mattyjayt/terra-hawk-scout/docs/adr/README.md

# Architecture decision records
- [ADR-0001 — Raspberry Pi 5 on the Scout first](0001-pi5-on-scout.md) · *Accepted*
- [ADR-0002 — ESP32 + micro-ROS as the real-time I/O controller](0002-esp32-micro-ros.md) · *Superseded by ADR-0006*
- [ADR-0003 — Encoder motors for odometry](0003-encoder-motors.md) · *Deferred: no encoders on the robot today*
- [ADR-0004 — Documentation-first workflow](0004-documentation-first.md) · *Accepted*
- [ADR-0005 — Arduino UNO R4 over USB serial as the base controller](0005-r4-usb-serial-base.md) · *Accepted*
- [ADR-0006 — Scout runs on the Pi 5 + Arduino UNO R4 only (no ESP32)](0006-scout-pi-r4-only.md) · *Accepted*
