mattyjayt/terra-hawk-scout/docs/design/DD-SCOUT-LOC.md

---
id: DD-SCOUT-LOC
title: Localisation (EKF)
status: Planned
owner: Argos (draft) · Jaime (approver)
updated: 2026-11-09
---
# DD-SCOUT-LOC — Localisation (EKF)

**Learning-critical.** robot_localization config, covariances, the drift measurement method. See the [sensor-fusion figure](../figures/sensor-fusion/sensor-fusion.html) (a concept figure drawn with wheel encoders; the Scout has none, so LiDAR scan matching takes that role).

## Context and requirements
_TBD_

## Goals / non-goals
_TBD_

## Design
_TBD_

## Interfaces
_TBD_

## Alternatives considered
_TBD_

## Risks
_TBD_

## Test plan
_TBD_

## Open questions
_TBD_
