mattyjayt/terra-hawk-scout/docs/design/DD-SCOUT-PERC.md

---
id: DD-SCOUT-PERC
title: Perception node (Camera 3 · YOLO · Python)
status: In progress (code in `scout_perception`: person_detector, pan_tracker; this doc is still to be written)
owner: Argos (draft) · Jaime (approver)
updated: 2026-11-08
---
# DD-SCOUT-PERC — Perception node (Camera 3 · YOLO · Python)

**Learning-critical.** Model choice (YOLO NCNN vs ONNX Runtime), the FPS budget, classes and dataset (Roboflow).

## Context and requirements
_TBD_

## Goals / non-goals
1. Display raw_image on foxglove
2. Display compressed image on foxglove
3. Integrate object detection & tracking
4. Publish detections
5. Move and pan servo with camera to ensure subject remains in centre

## Design
_TBD_

## Interfaces
_TBD_

## Alternatives considered
_TBD_

## Risks
_TBD_

## Test plan
_TBD_

## Open questions
_TBD_
