mattyjayt/terra-hawk-scout/docs/adr/0004-documentation-first.md

# ADR-0004 — Documentation-first workflow
- **Status:** Accepted (2026-10-30)
- **Context:** Problems caught in specs are cheaper than problems caught in hardware.
- **Decision:** PRD → SRS → interfaces → design docs approved before code; IDs trace into issues, tests and releases.
- **Consequences:** recorded in the related design docs; revisit if the constraint changes.
