mattyjayt/terra-hawk-scout/cad/scout-v2/docs/figures/drivetrain-power/drivetrain-power-light.html

Fig 2Drive and powerHold to cut /cmd_velL 0.30 · R 0.30 m/s · 1481 counts/s

1 Power: 3S pack 9.0–12.6 V → 7.5 A fuse → 10 A DC switch → Cytron MDD3A. Duty capped at 8.4 V ÷ V_pack (67 % full, 93 % at 9.0 V), so the motors see ≤ 8.4 V average. Branch: Pololu D36V50F5 → 5 V to the Pi 5 header2 Drive: Hiwonder TT motor, 1:42 gearbox; hall encoder on the motor shaft, 1008 counts per wheel turn claimed (×4 quadrature) → π × 65 mm ÷ 1008 = 0.20 mm per count3 Skid steer: in a turn the tyres scrub sideways, so the wheels run as if the track were 1.7–1.9 × the 124 mm geometric one. Wheel odometry is good for distance, bad for heading: the EKF takes yaw from the MPU-6050 gyro4 Loop: ESP32 counts with PCNT and runs the wheel PID at ≥ 50 Hz (20 ms); no /cmd_vel for 300 ms → MDD3A inputs LOW/LOW: braked to a stop in 0.16–0.19 s (coasting takes 0.32–0.42 s)Scout v2's left side with the near half of the top deck cut away (the parts it carries stay in place) and the near front wheel laid on the bench. The tour drives straight at 0.3 m/s (1.47 wheel turns, about 1481 counts per second), then turns left at 0.5 rad/s with 0.2 m/s forward: the near wheels slow to 0.14 m/s and the far ones speed up to 0.26 m/s, because the scrubbing tyres need an effective track about 1.8 × 124 mm. Read through the geometric track those wheel speeds claim 0.90 rad/s, so heading comes from the gyro. Then /cmd_vel goes quiet: after 300 ms the ESP32 drives both MDD3A inputs LOW and the motors brake. Hold the figure to cut /cmd_vel yourself. The encoder magnet is drawn turning 3 × the wheel; the real one turns 42 ×. The 1008-count figure is Hiwonder's claim (one buyer measured 600): measure it on arrival. The MPU-6050 hangs under the top deck between the driver and the buck. The right-side wiring, the I²C lead and the LiDAR tower are left out; layout after CAD r1, with the fuse holder moved beside the XT30 so the series path is in view.
