mattyjayt/terra-hawk-scout/docs/design/DD-SCOUT-HWIF.md

---
id: DD-SCOUT-HWIF
title: ros2_control hardware interface (C++)
status: Deferred (not in the current plan; the base bridge, DD-SCOUT-BRIDGE, drives the base)
owner: Argos (draft) · Jaime (approver)
updated: 2026-11-09
---
# DD-SCOUT-HWIF — ros2_control hardware interface (C++)

**Learning-critical:** Jaime writes the core. Covers the read()/write() cycle, state/command interfaces and reuse of the base bridge's serial-r4 core (DD-SCOUT-BRIDGE).

## Context and requirements
_TBD_

## Goals / non-goals
_TBD_

## Design
_TBD_

## Interfaces
_TBD_

## Alternatives considered
_TBD_

## Risks
_TBD_

## Test plan
_TBD_

## Open questions
_TBD_
