mattyjayt/terra-hawk-scout/cad/scout-layout/shots/scout_iso.png

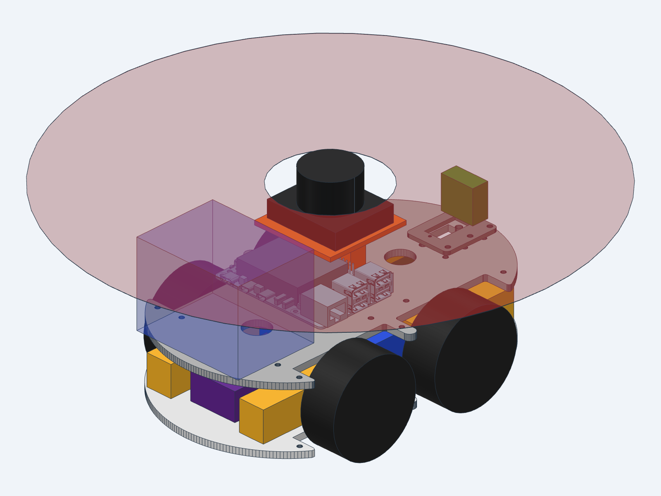
cad/scout-layout/shots/scout_iso.png
