mattyjayt/terra-hawk-scout/cad/scout-layout/shots/scout_top.png

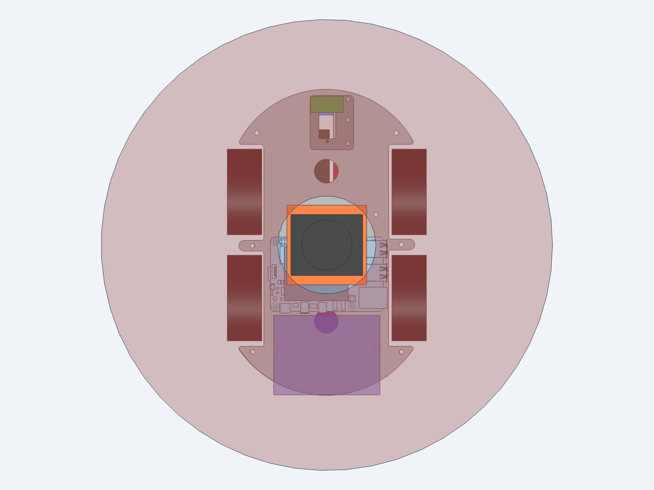
cad/scout-layout/shots/scout_top.png
