mattyjayt/terra-hawk-scout/cad/scout-v2/analysis/a1_mass_com.png

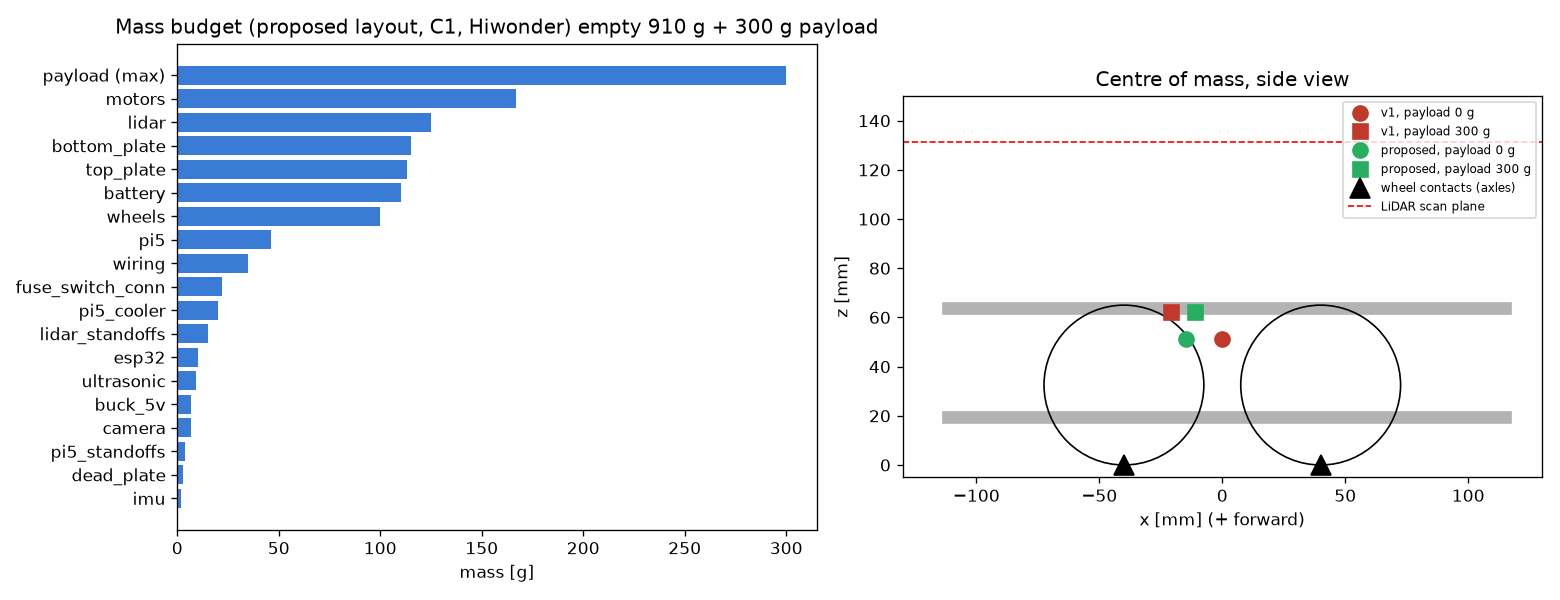
cad/scout-v2/analysis/a1_mass_com.png
