mattyjayt/terra-hawk-scout/cad/scout-v2/analysis/a2_torque_speed.png

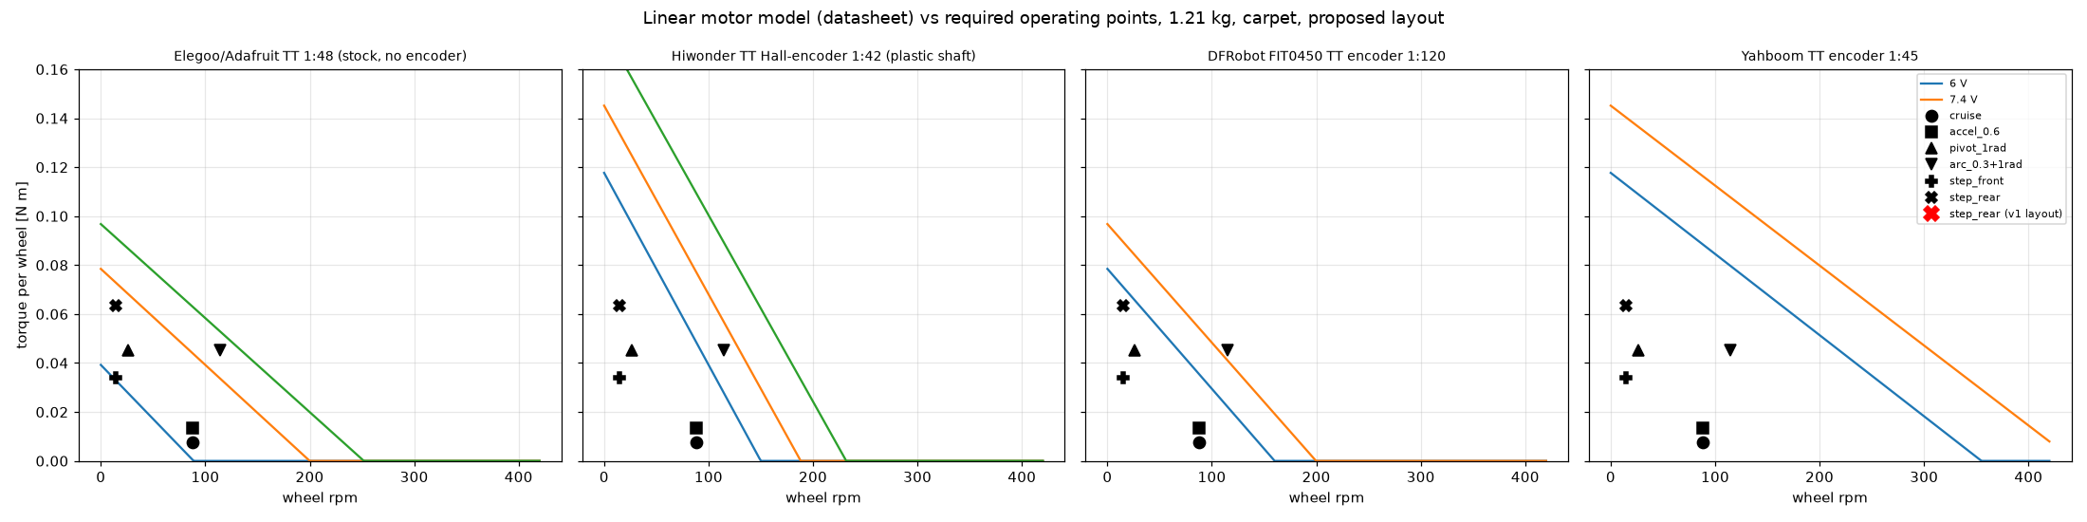
cad/scout-v2/analysis/a2_torque_speed.png
