mattyjayt/terra-hawk-scout/cad/scout-v2/analysis/a3_skid_steer.png

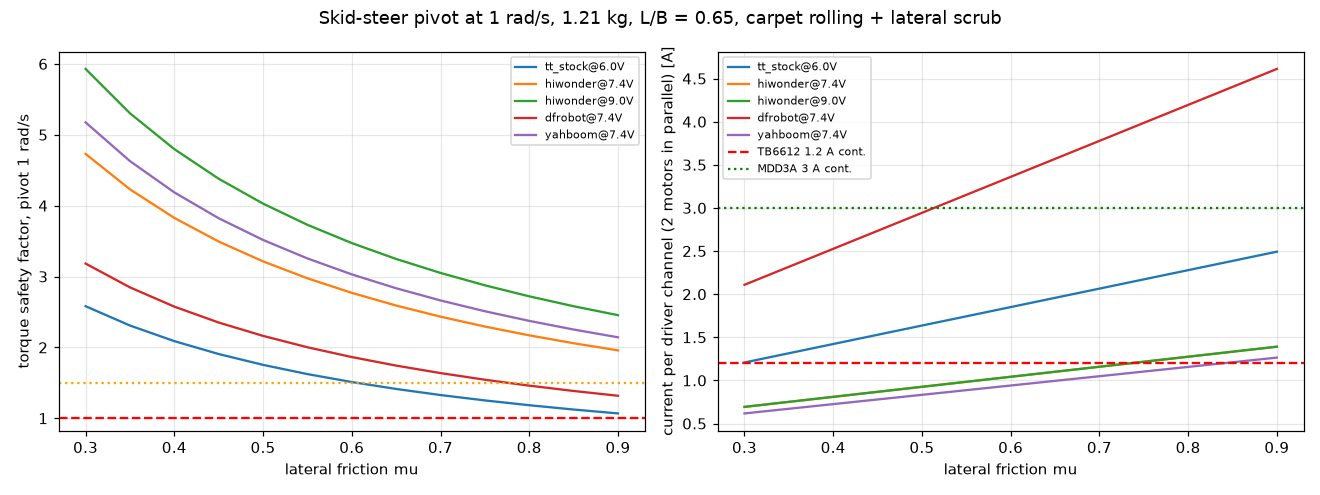
cad/scout-v2/analysis/a3_skid_steer.png
