mattyjayt/terra-hawk-scout/cad/scout-v2/analysis/a5_power.png

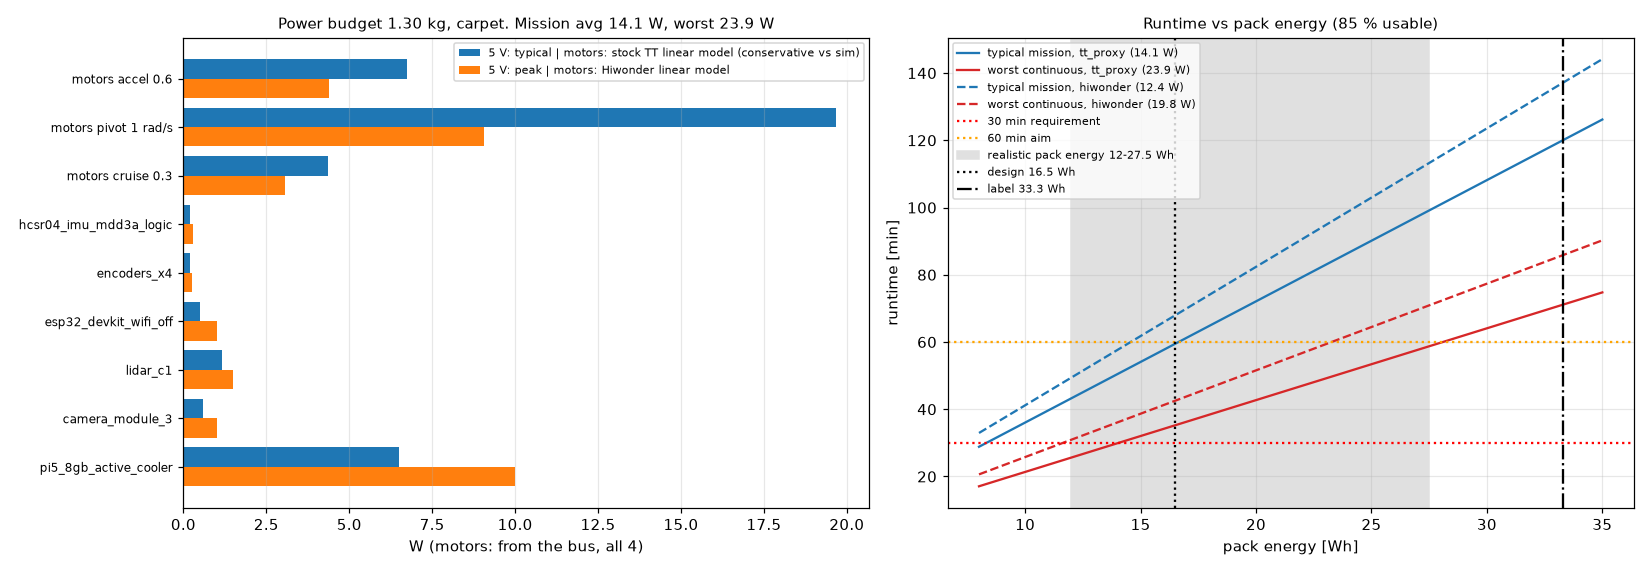
cad/scout-v2/analysis/a5_power.png
