mattyjayt/terra-hawk-scout/cad/scout-v2/analysis/a6_stability.png

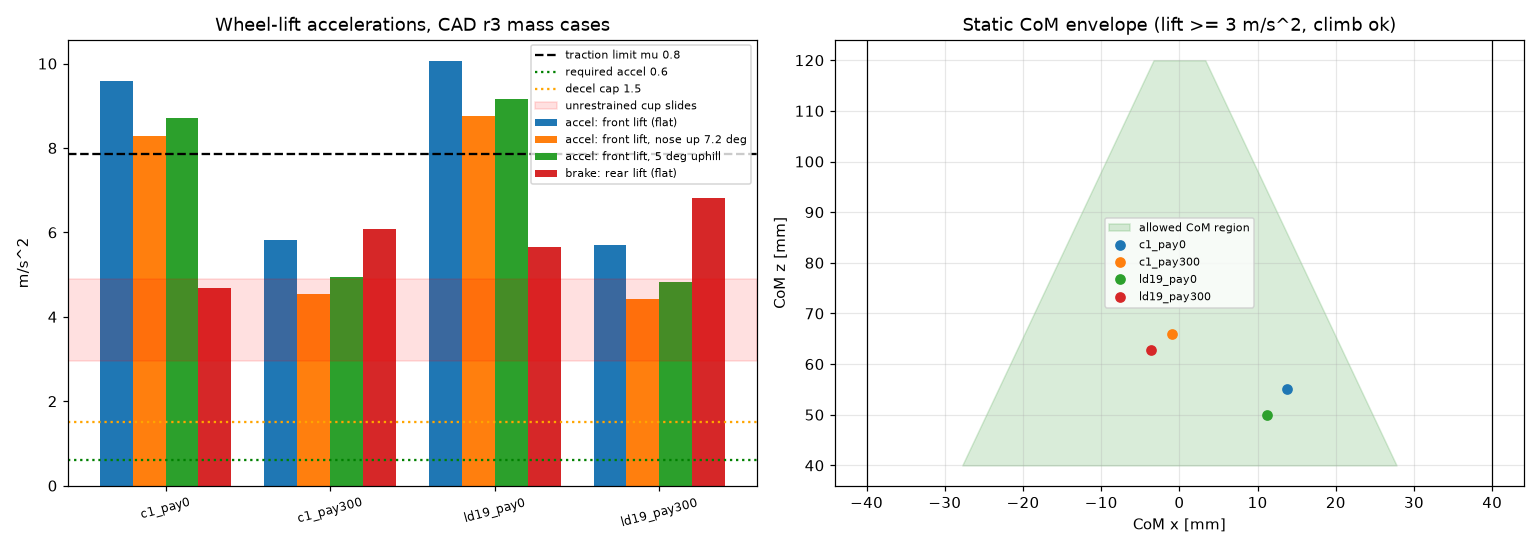
cad/scout-v2/analysis/a6_stability.png
