mattyjayt/terra-hawk-scout/cad/scout-v2/analysis/a7_odometry.png

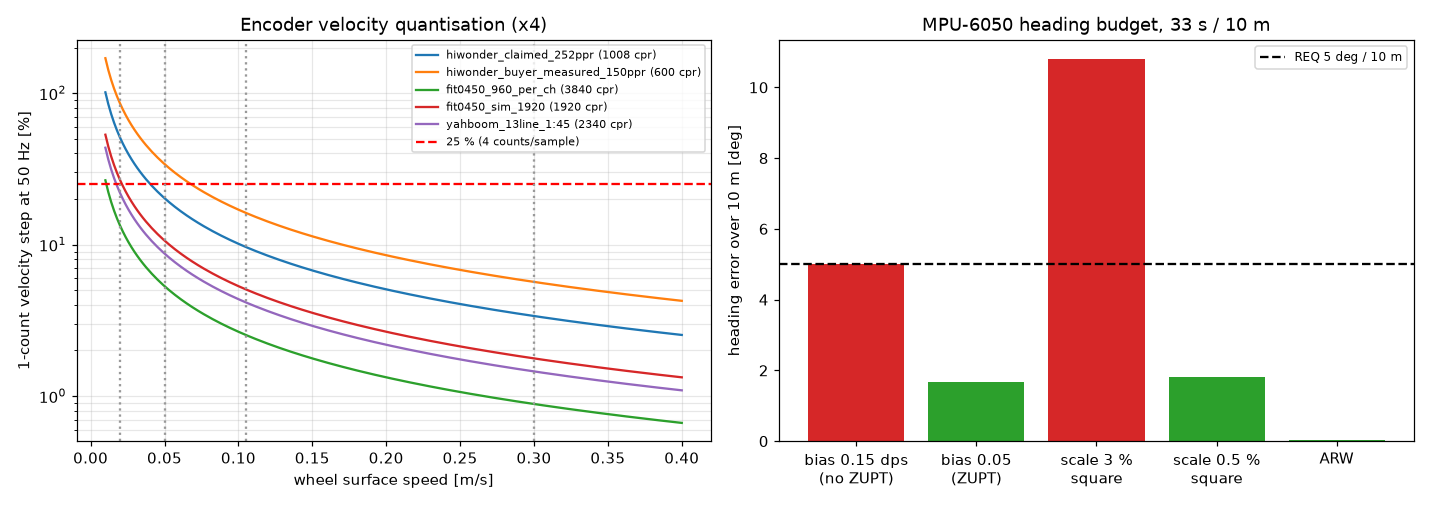
cad/scout-v2/analysis/a7_odometry.png
