mattyjayt/terra-hawk-scout/cad/scout-v2/analysis/a8_sensors.png

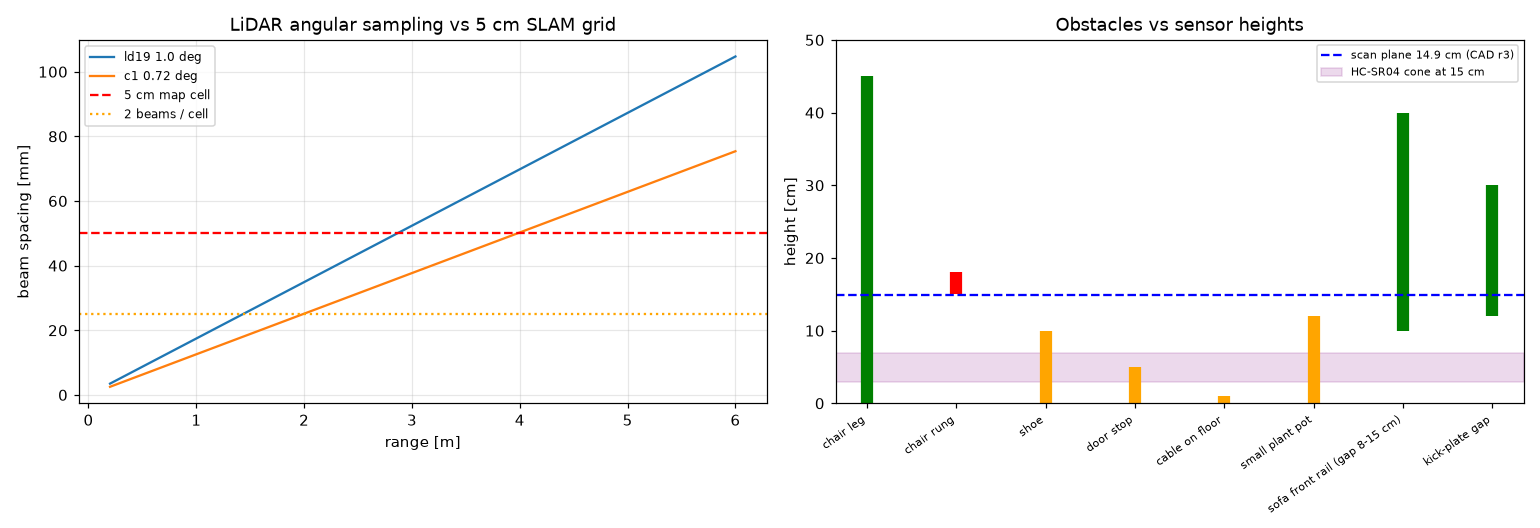
cad/scout-v2/analysis/a8_sensors.png
