mattyjayt/terra-hawk-scout/cad/scout-v2/analysis/a9_motor_review.png

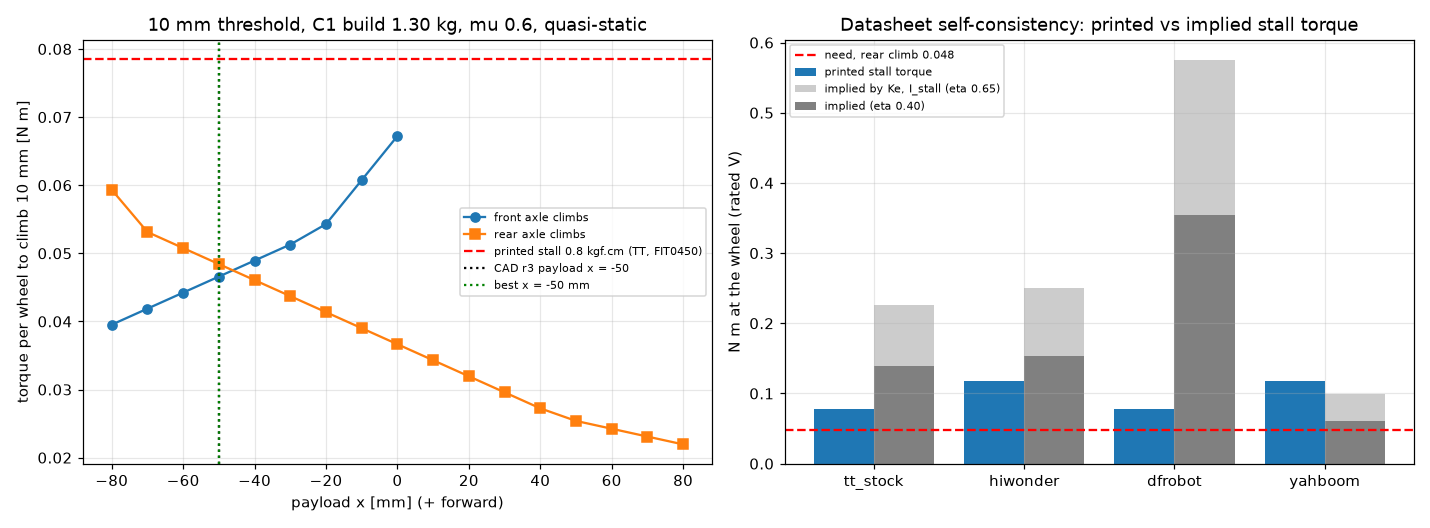
cad/scout-v2/analysis/a9_motor_review.png
