mattyjayt/terra-hawk-scout/cad/scout-v2/analysis/a9_torque_speed.png

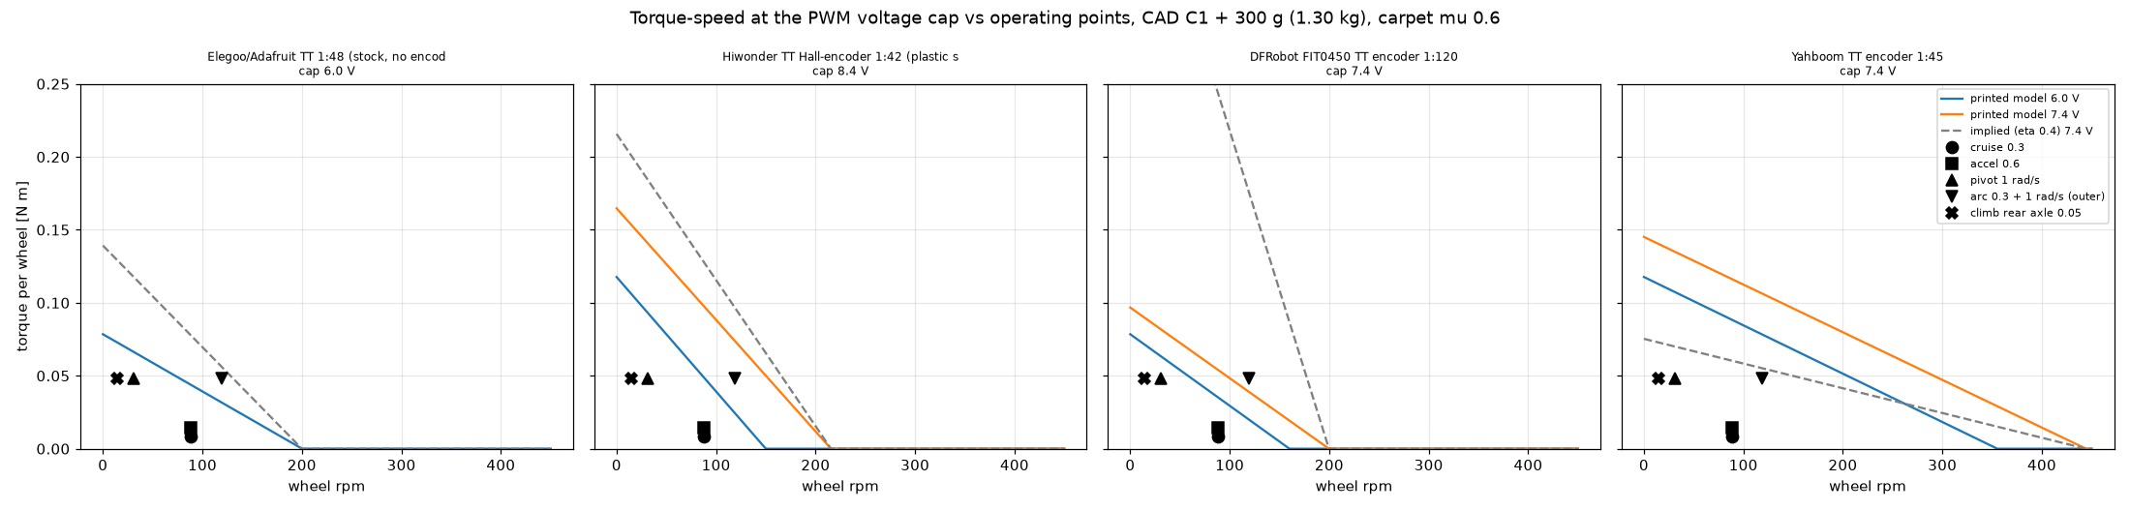
cad/scout-v2/analysis/a9_torque_speed.png
