mattyjayt/terra-hawk-scout/cad/scout-v2/docs/diagrams/scout-power-distribution/scout-power-distribution.png

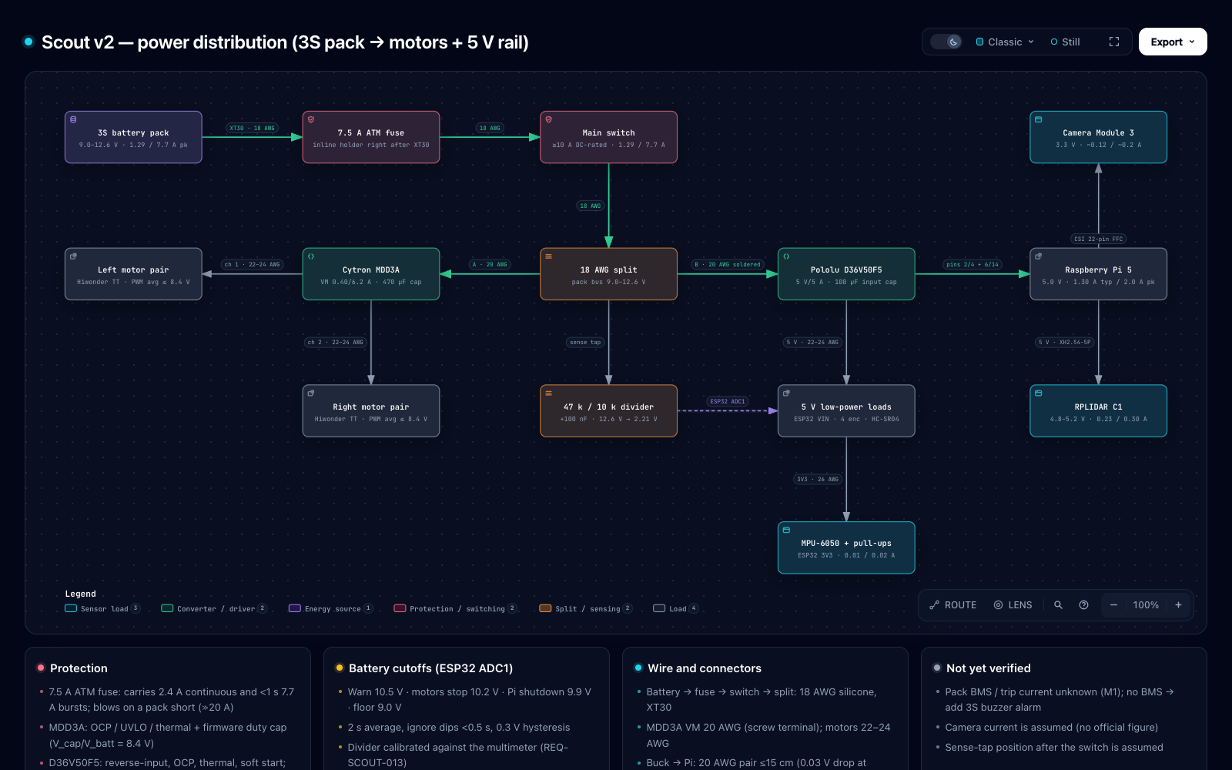
cad/scout-v2/docs/diagrams/scout-power-distribution/scout-power-distribution.png
