mattyjayt/terra-hawk-scout/cad/scout-v2/docs/figures/drivetrain-power/shots/desktop-light.png

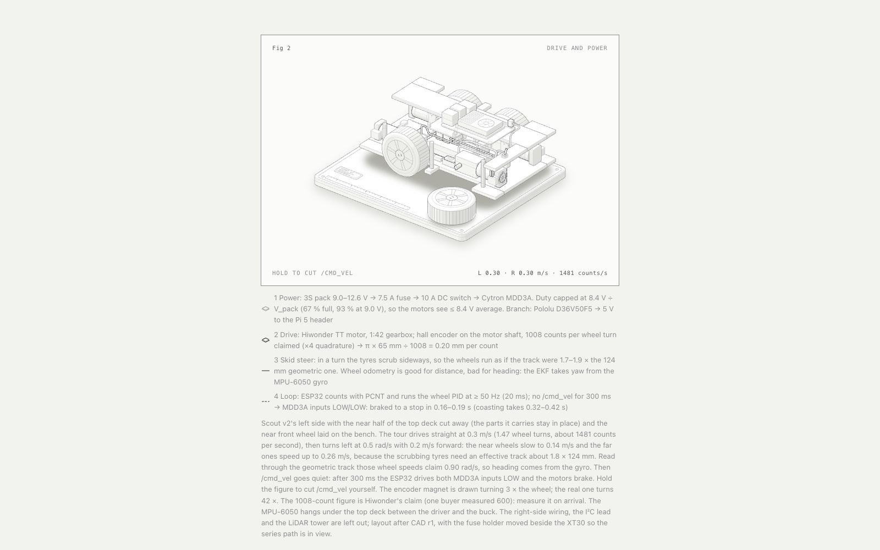
cad/scout-v2/docs/figures/drivetrain-power/shots/desktop-light.png
