mattyjayt/terra-hawk-scout/cad/scout-v2/docs/figures/drivetrain-power/shots/held-stopped.png

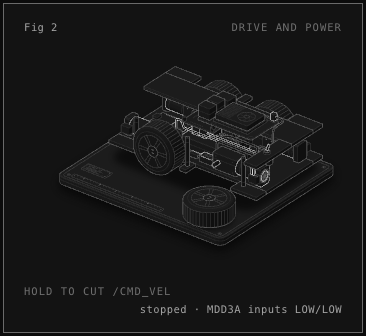
cad/scout-v2/docs/figures/drivetrain-power/shots/held-stopped.png
