mattyjayt/terra-hawk-scout/cad/scout-v2/docs/figures/drivetrain-power/shots/lines-light.png

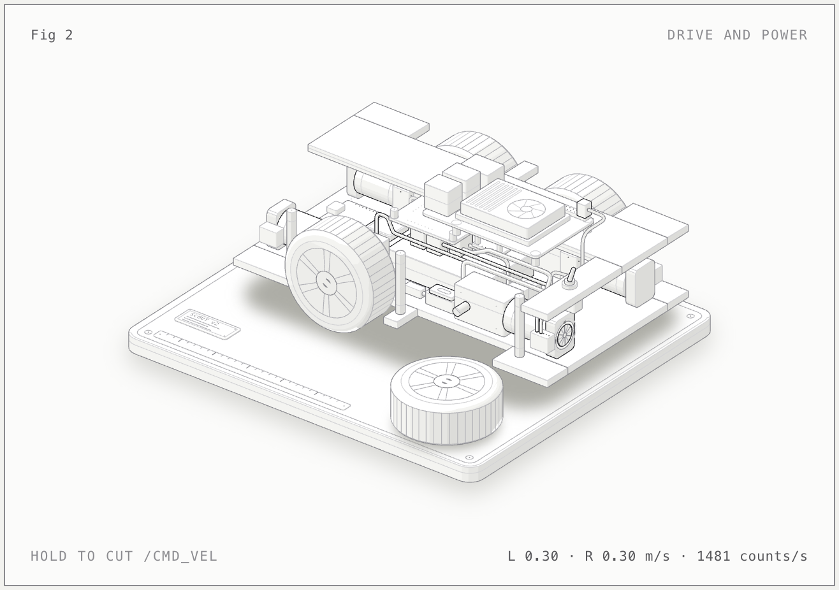
cad/scout-v2/docs/figures/drivetrain-power/shots/lines-light.png
