mattyjayt/terra-hawk-scout/cad/scout-v2/docs/figures/drivetrain-power/shots/lines.png

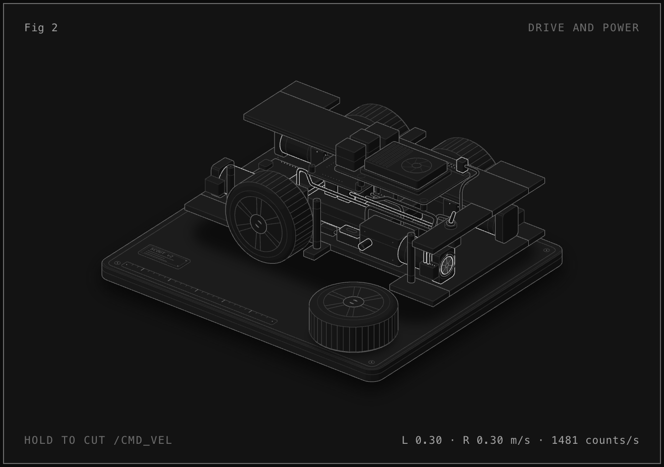
cad/scout-v2/docs/figures/drivetrain-power/shots/lines.png
