mattyjayt/terra-hawk-scout/cad/scout-v2/docs/figures/drivetrain-power/shots/phone-390-light.png

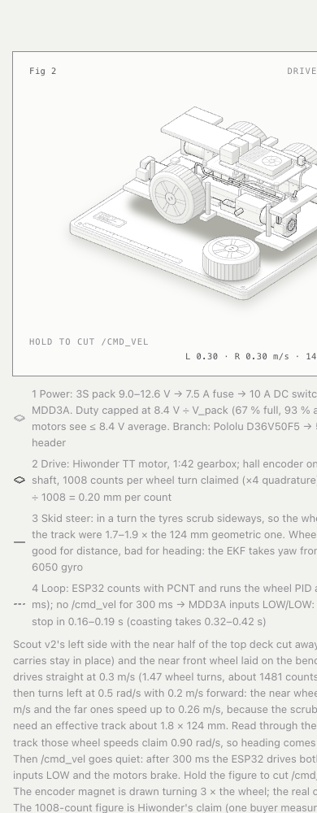
cad/scout-v2/docs/figures/drivetrain-power/shots/phone-390-light.png
