mattyjayt/terra-hawk-scout/cad/scout-v2/docs/figures/drivetrain-power/shots/phone-emulated.png

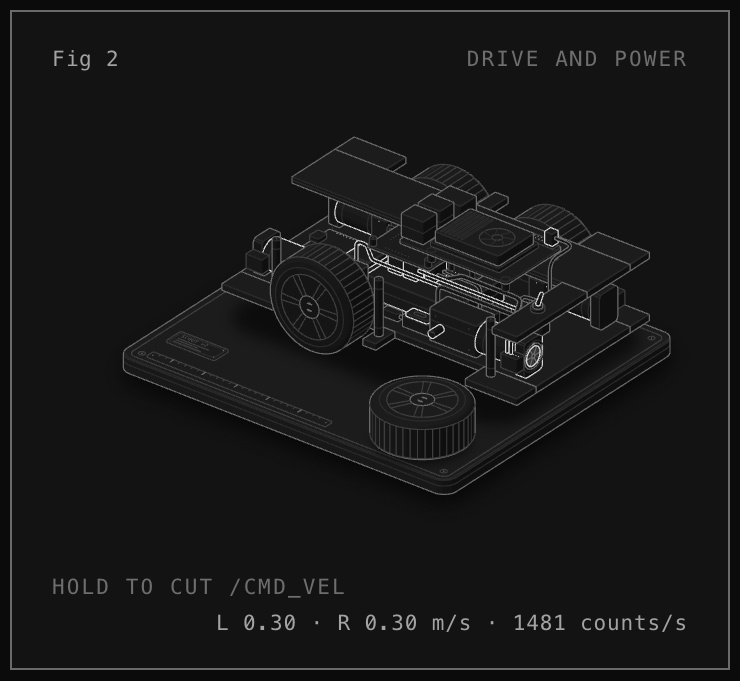
cad/scout-v2/docs/figures/drivetrain-power/shots/phone-emulated.png
