mattyjayt/terra-hawk-scout/cad/scout-v2/docs/figures/drivetrain-power/shots/phone-light-turn.png

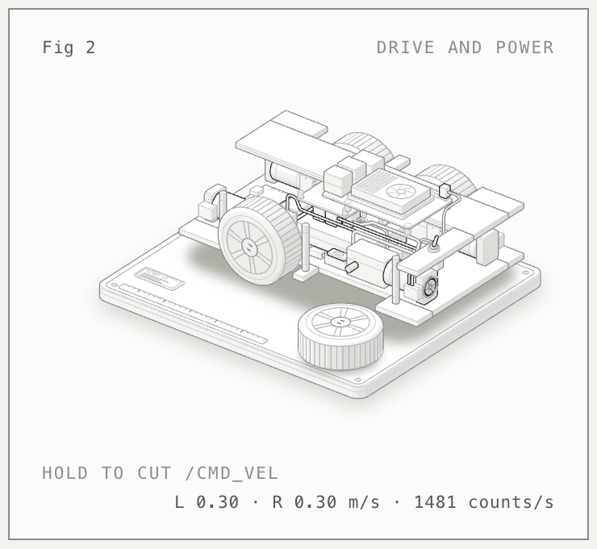
cad/scout-v2/docs/figures/drivetrain-power/shots/phone-light-turn.png
