mattyjayt/terra-hawk-scout/cad/scout-v2/docs/figures/drivetrain-power/shots/plate-dark-3000.png

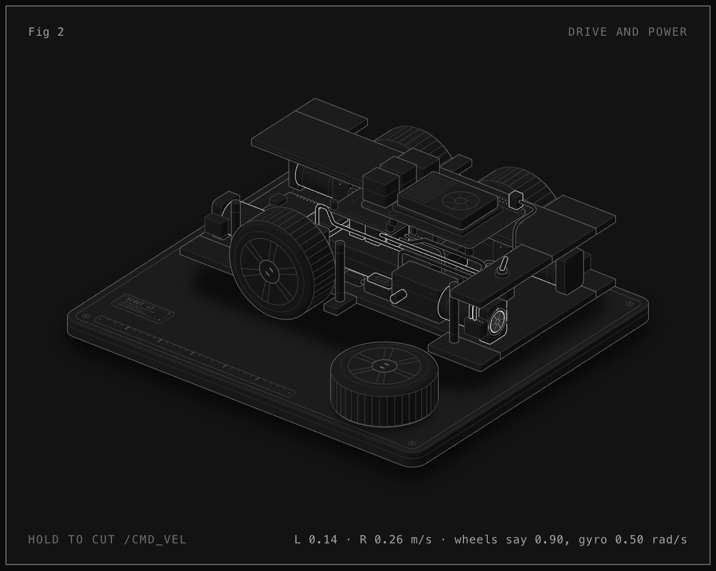
cad/scout-v2/docs/figures/drivetrain-power/shots/plate-dark-3000.png
