mattyjayt/terra-hawk-scout/cad/scout-v2/docs/figures/drivetrain-power/shots/plate-dark-7000.png

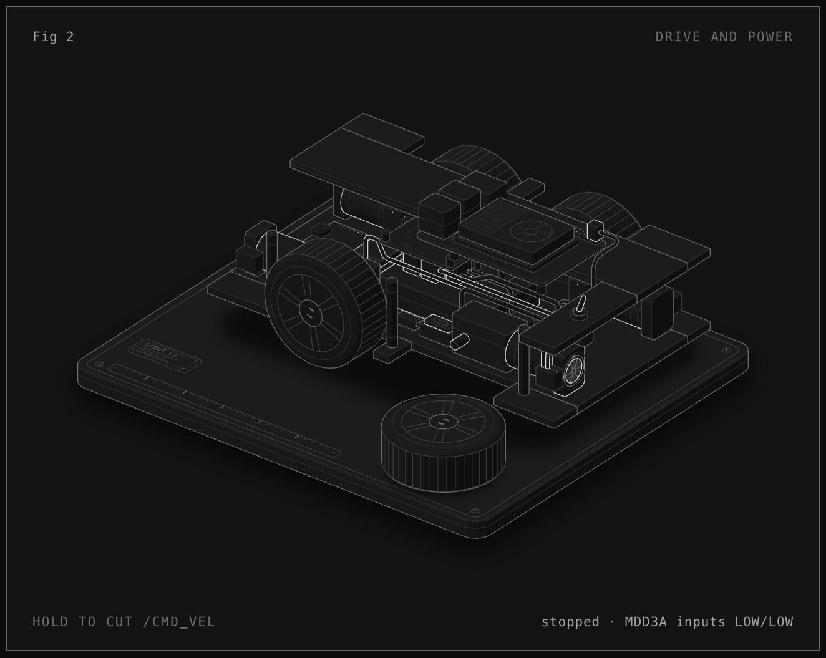
cad/scout-v2/docs/figures/drivetrain-power/shots/plate-dark-7000.png
