mattyjayt/terra-hawk-scout/cad/scout-v2/docs/figures/drivetrain-power/shots/turn-phone.png

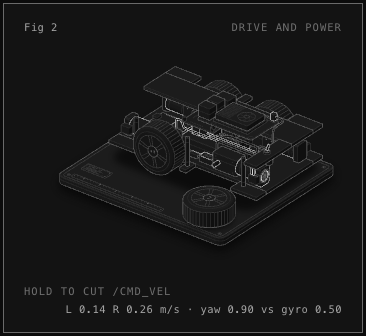
cad/scout-v2/docs/figures/drivetrain-power/shots/turn-phone.png
