mattyjayt/terra-hawk-scout/cad/scout-v2/docs/figures/drivetrain-power/shots/zoom-5v.png

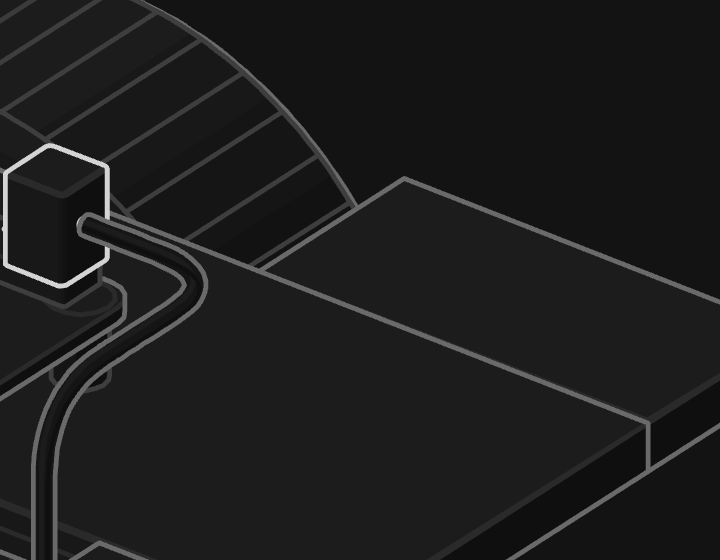
cad/scout-v2/docs/figures/drivetrain-power/shots/zoom-5v.png
