mattyjayt/terra-hawk-scout/cad/scout-v2/docs/figures/drivetrain-power/shots/zoom-front.png

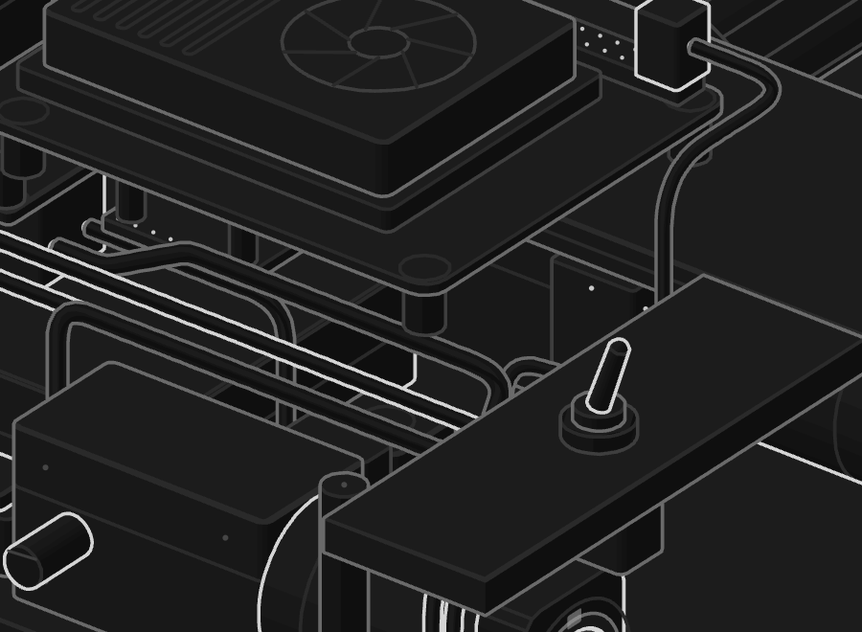
cad/scout-v2/docs/figures/drivetrain-power/shots/zoom-front.png
