mattyjayt/terra-hawk-scout/cad/scout-v2/shots/scout_v2_side.png

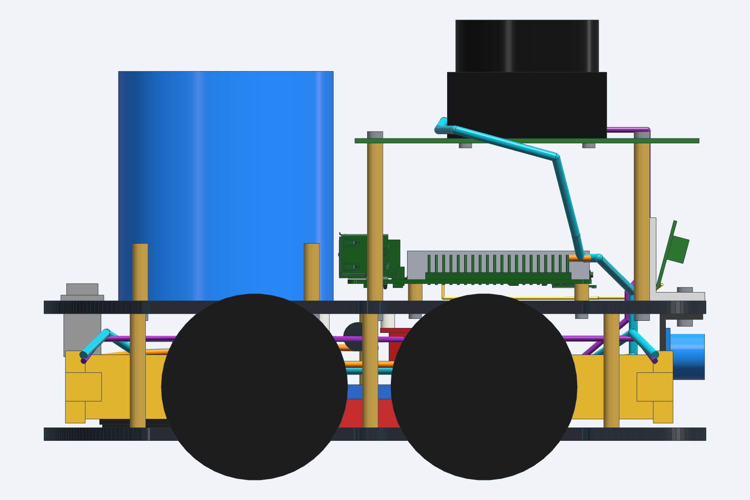
cad/scout-v2/shots/scout_v2_side.png
