mattyjayt/terra-hawk-scout/cad/scout-v2/shots/scout_v2_top.png

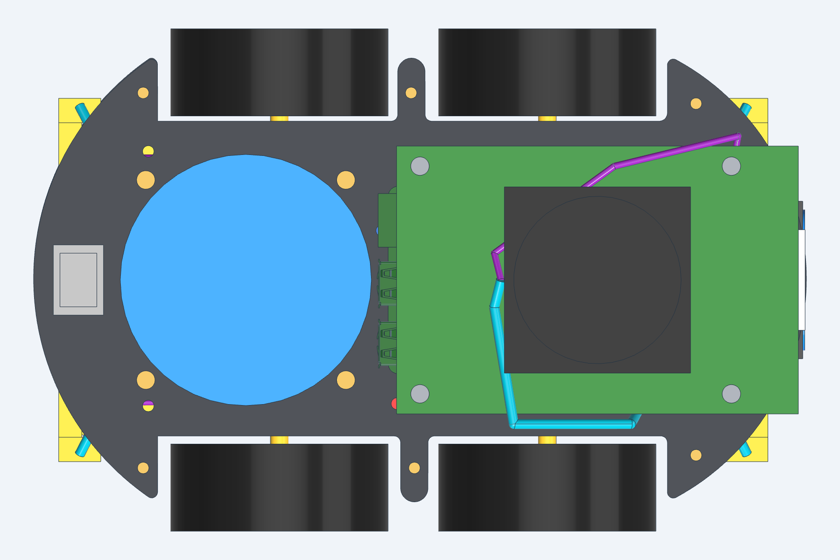
cad/scout-v2/shots/scout_v2_top.png
