mattyjayt/terra-hawk-scout/cad/scout-v2/sim/plots/a_straight.png

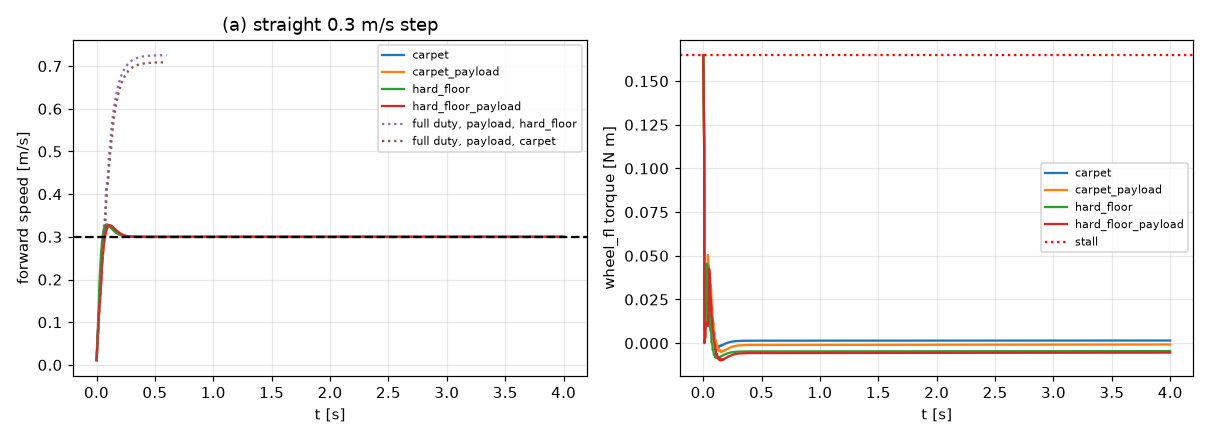
cad/scout-v2/sim/plots/a_straight.png
