mattyjayt/terra-hawk-scout/cad/scout-v2/sim/plots/b_spin.png

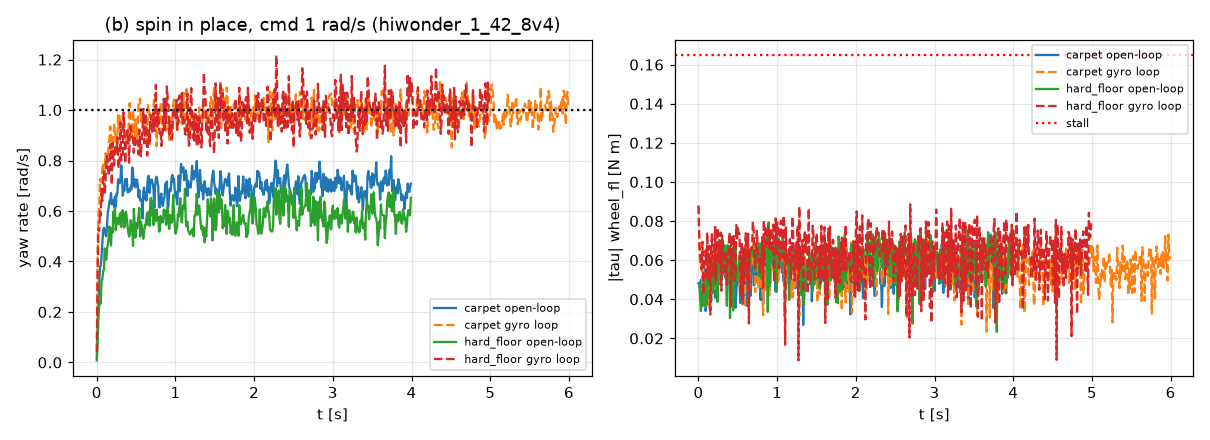
cad/scout-v2/sim/plots/b_spin.png
