mattyjayt/terra-hawk-scout/cad/scout-v2/sim/plots/c_estop.png

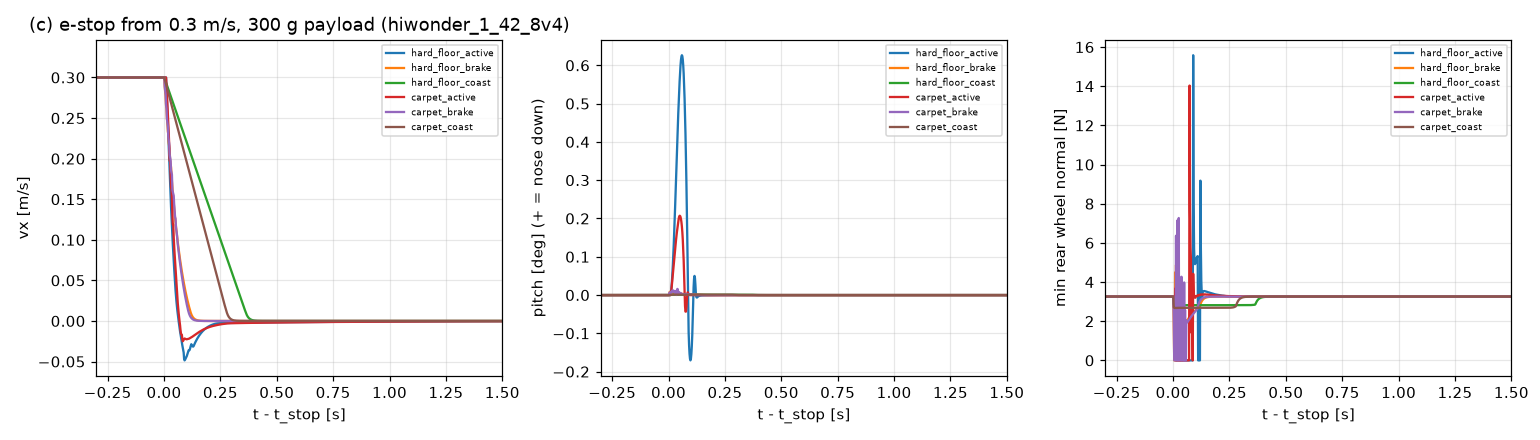
cad/scout-v2/sim/plots/c_estop.png
