mattyjayt/terra-hawk-scout/cad/scout-v2/sim/plots/d_threshold.png

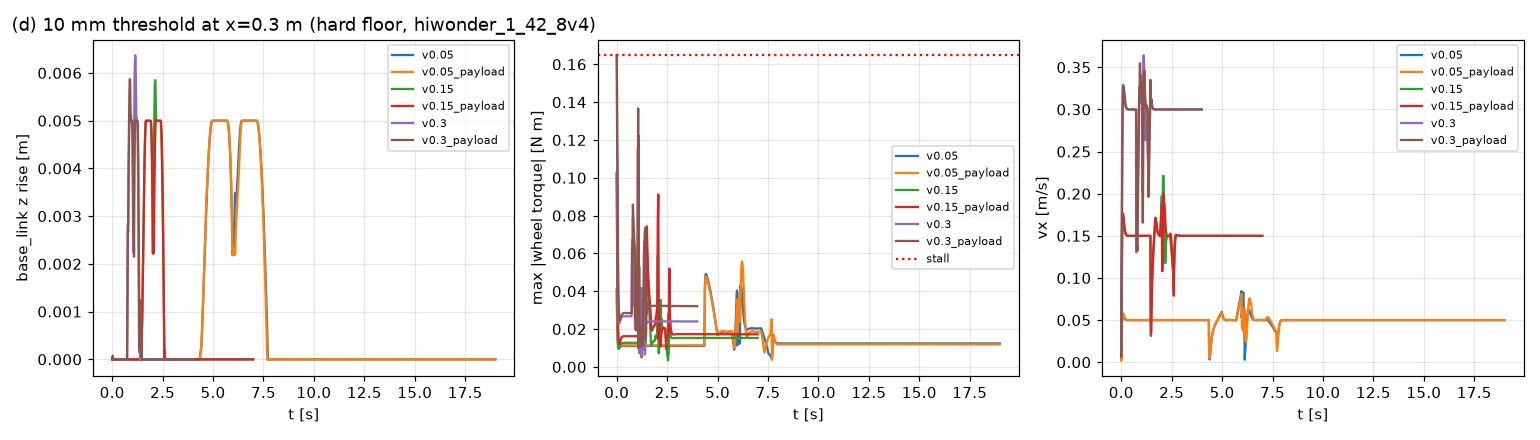
cad/scout-v2/sim/plots/d_threshold.png
