mattyjayt/terra-hawk-scout/cad/scout-v2/sim/plots/e_odometry.png

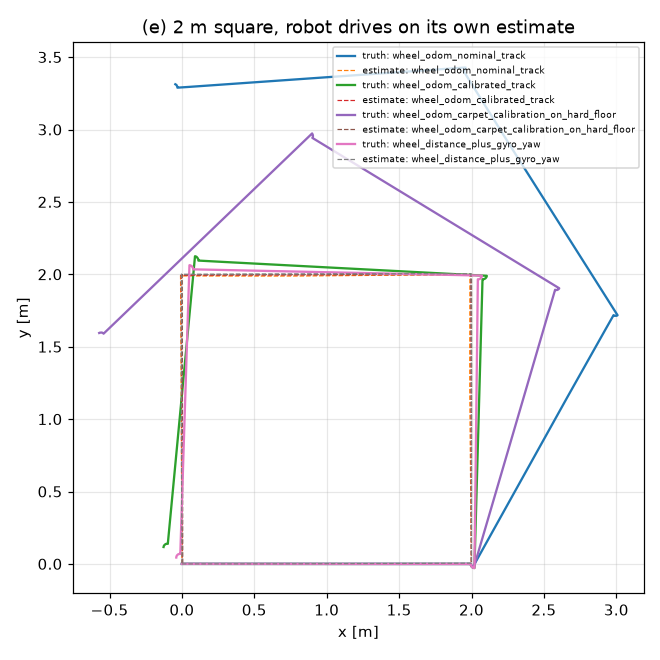
cad/scout-v2/sim/plots/e_odometry.png
