mattyjayt/terra-hawk-scout/cad/scout-v2/sim/plots/f_payload_retention.png

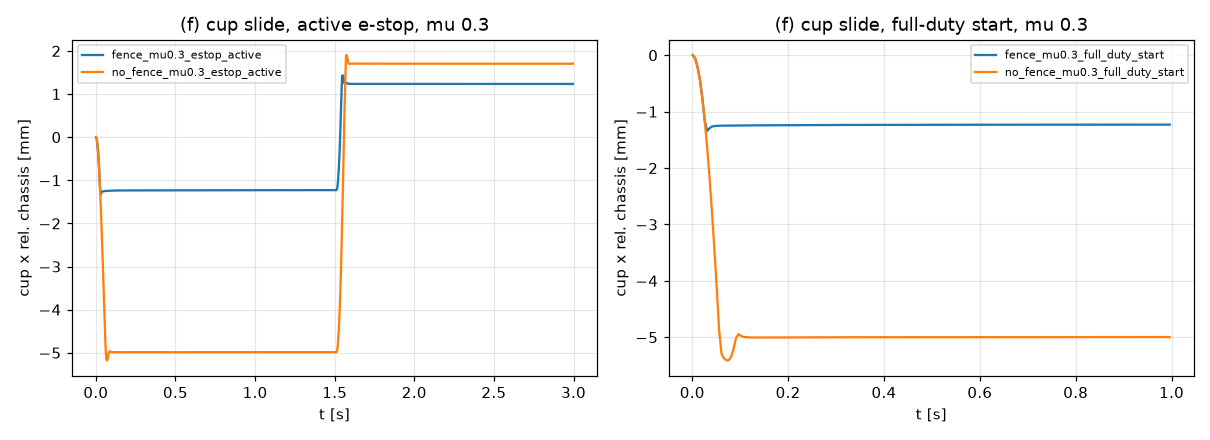
cad/scout-v2/sim/plots/f_payload_retention.png
