mattyjayt/terra-hawk-scout/cad/scout-v2/sim/plots/tt_1_48_6v/b_spin.png

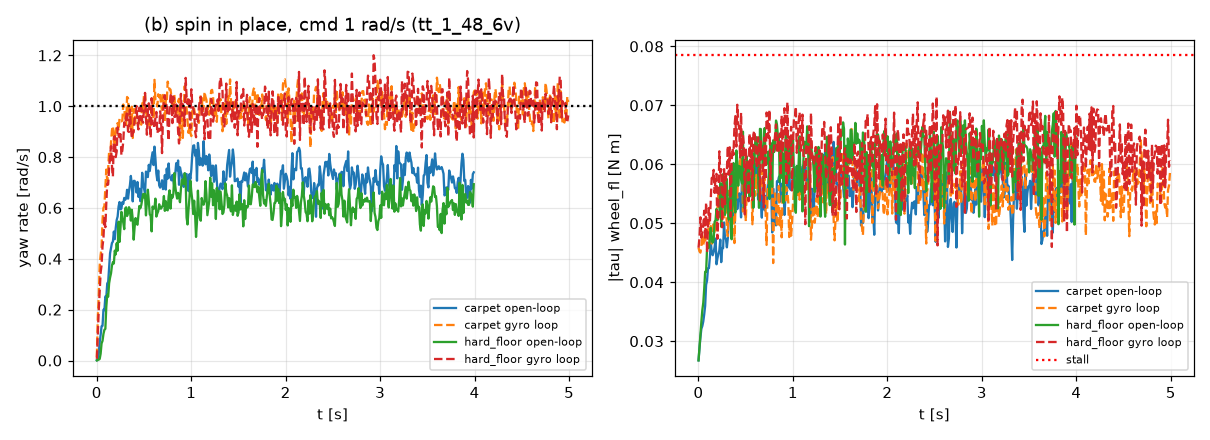
cad/scout-v2/sim/plots/tt_1_48_6v/b_spin.png
