mattyjayt/terra-hawk-scout/cad/scout-v2/sim/plots/tt_1_48_6v/c_estop.png

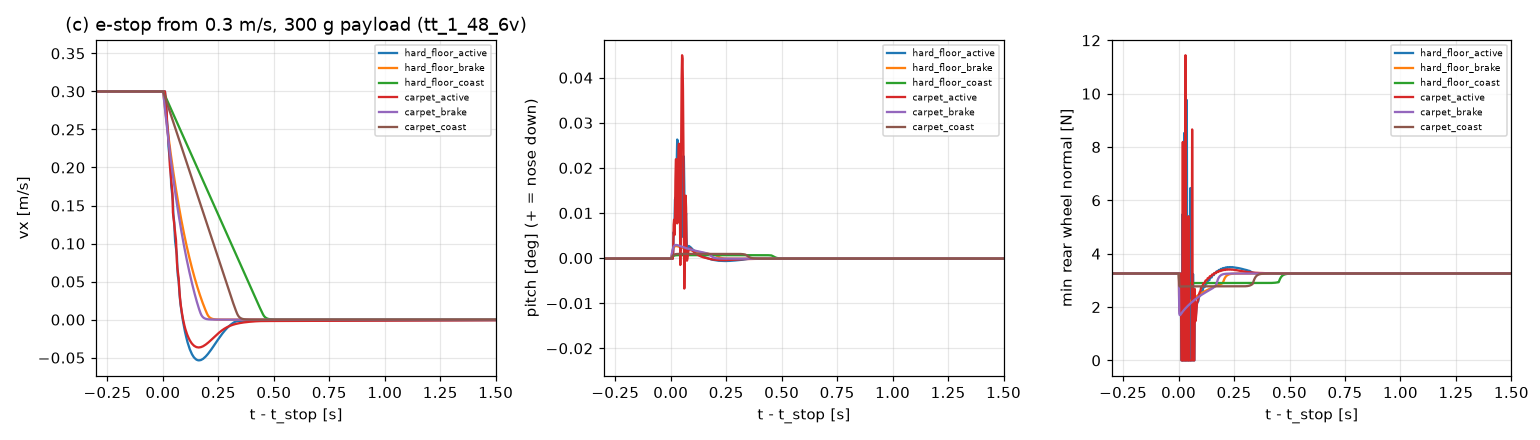
cad/scout-v2/sim/plots/tt_1_48_6v/c_estop.png
