mattyjayt/terra-hawk-scout/docs/figures/sensor-fusion/shots/after-slip-light.png

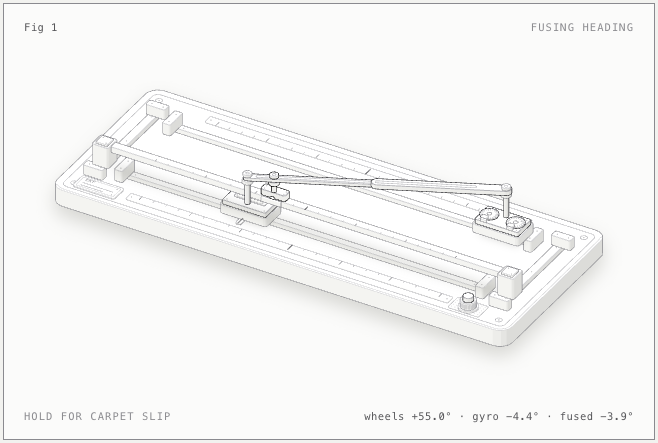
docs/figures/sensor-fusion/shots/after-slip-light.png
