mattyjayt/terra-hawk-scout/docs/figures/sensor-fusion/shots/desktop-dark.png

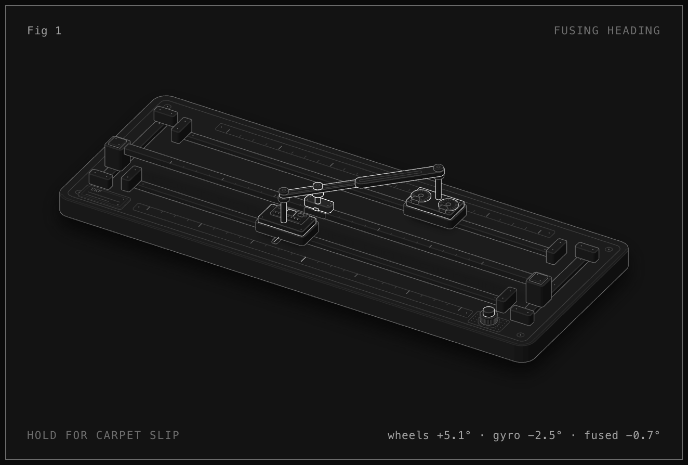
docs/figures/sensor-fusion/shots/desktop-dark.png
