mattyjayt/terra-hawk-scout/docs/figures/sensor-fusion/shots/desktop-light-3000.png

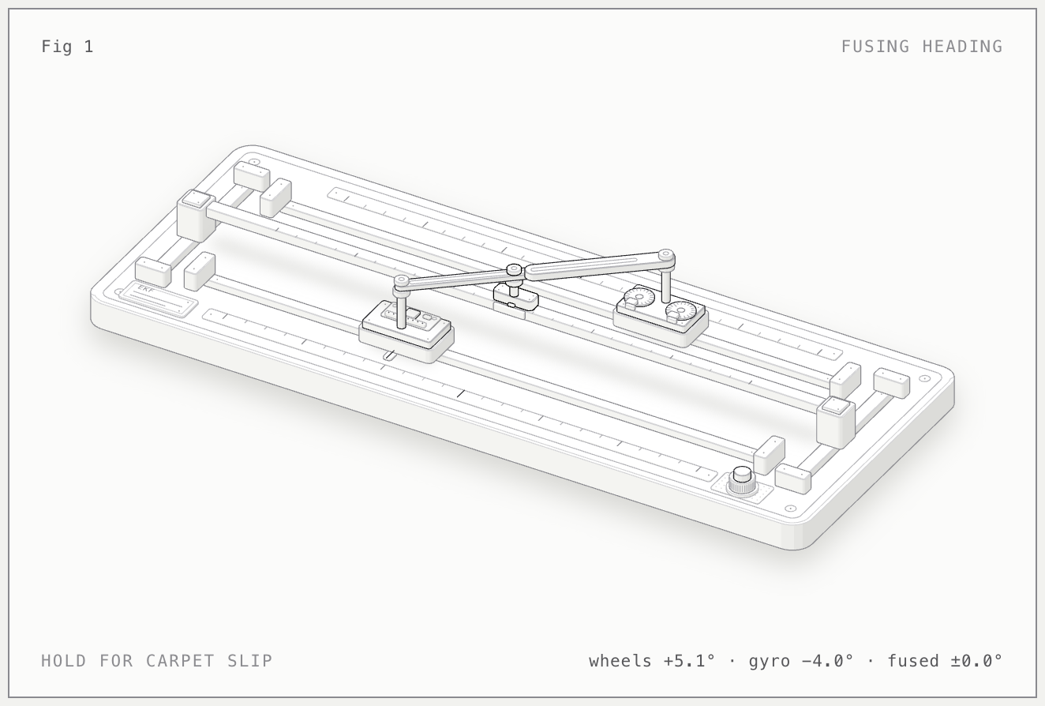
docs/figures/sensor-fusion/shots/desktop-light-3000.png
