mattyjayt/terra-hawk-scout/docs/figures/sensor-fusion/shots/desktop-light.png

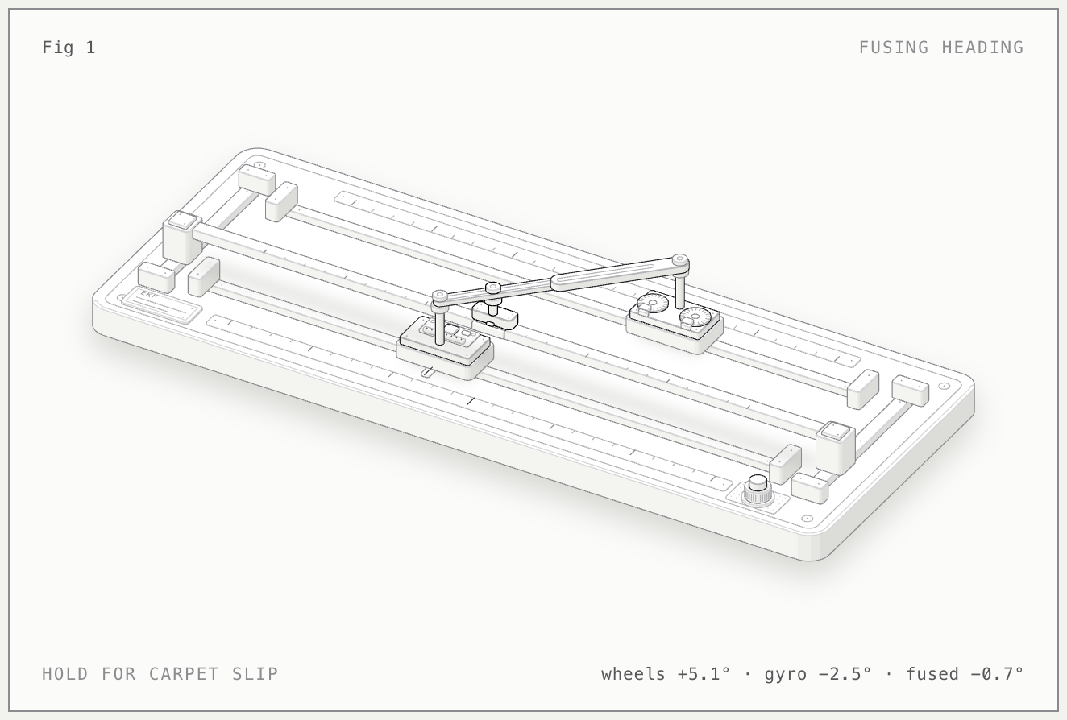
docs/figures/sensor-fusion/shots/desktop-light.png
