mattyjayt/terra-hawk-scout/docs/figures/sensor-fusion/shots/lines-light.png

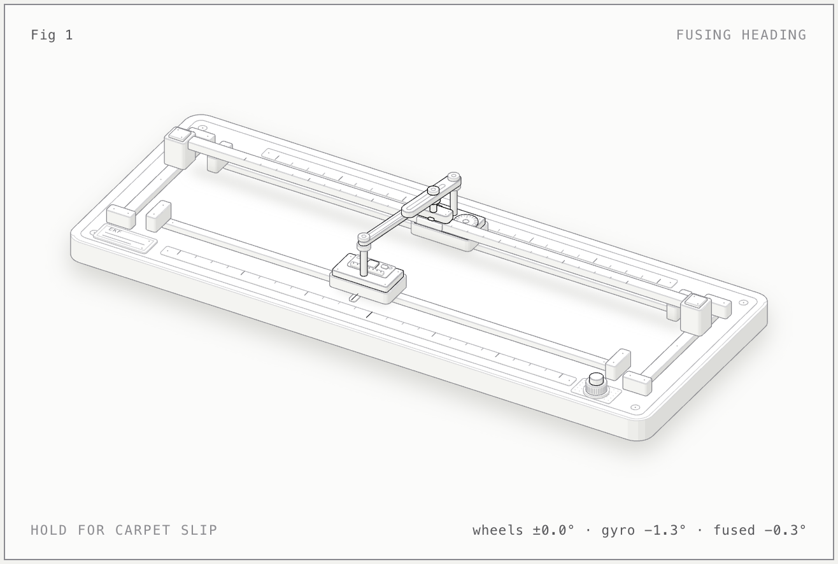
docs/figures/sensor-fusion/shots/lines-light.png
