mattyjayt/terra-hawk-scout/docs/figures/sensor-fusion/shots/lines.png

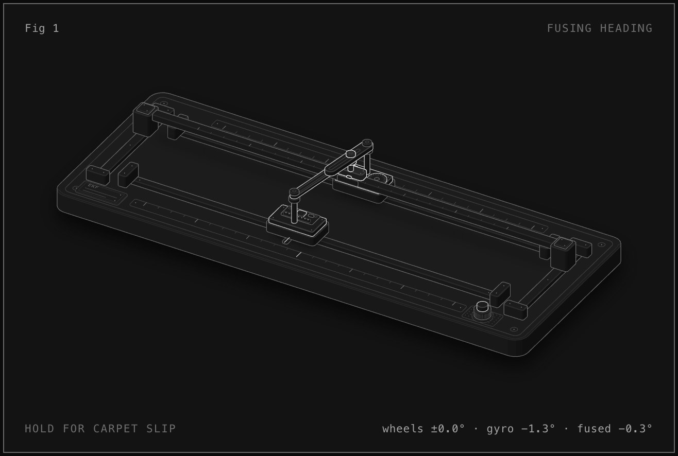
docs/figures/sensor-fusion/shots/lines.png
