mattyjayt/terra-hawk-scout/docs/figures/sensor-fusion/shots/phone-dark.png

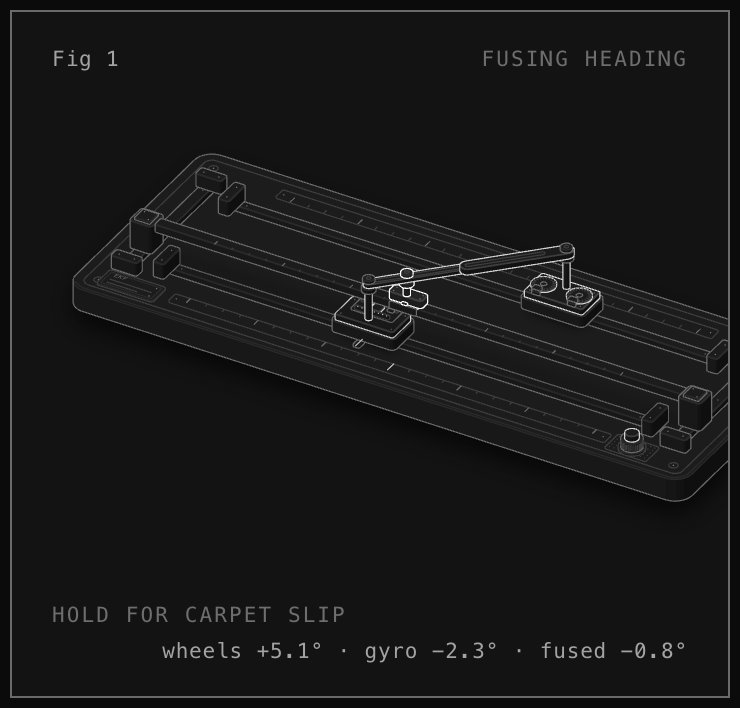
docs/figures/sensor-fusion/shots/phone-dark.png
