mattyjayt/terra-hawk-scout/docs/figures/sensor-fusion/shots/phone-light.png

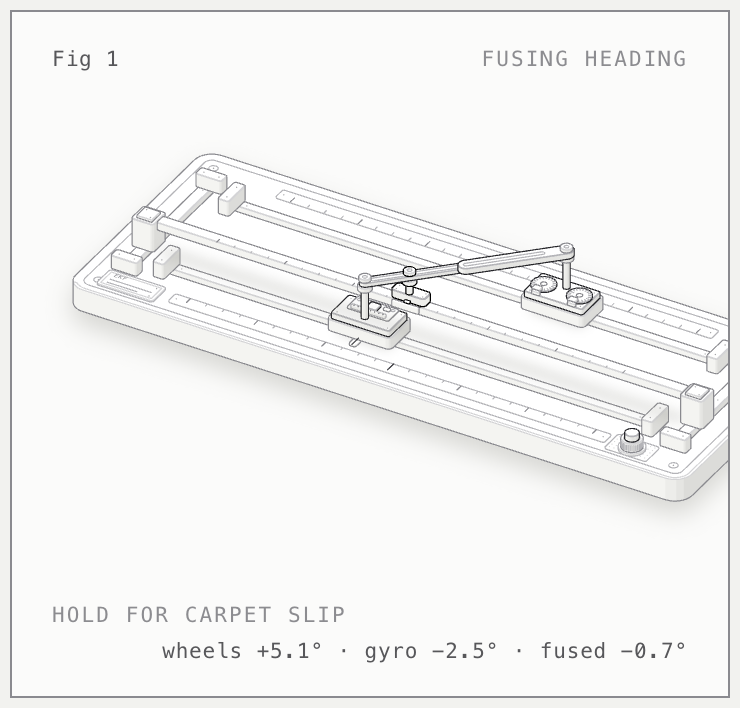
docs/figures/sensor-fusion/shots/phone-light.png
