mattyjayt/terra-hawk-scout/docs/figures/sensor-fusion/shots/zoom-dark.png

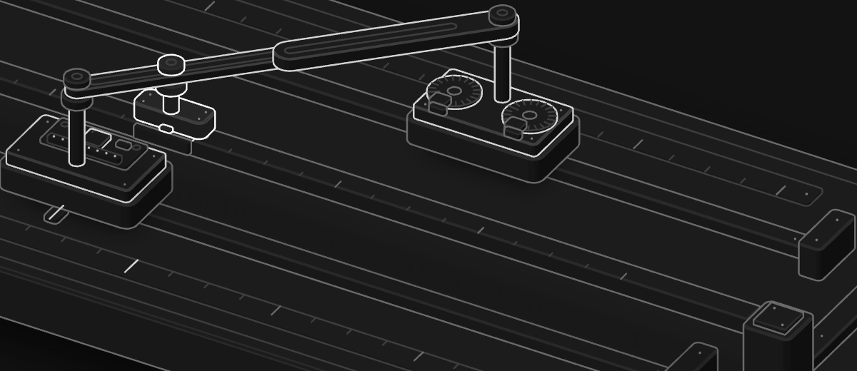
docs/figures/sensor-fusion/shots/zoom-dark.png
