mattyjayt/terra-hawk-scout/docs/hardware/bom.md

# Scout bill of materials
✅ have · 🚚 ordered · 🛒 to buy · ⏸ deferred.

| Part | Qty | Status | Notes |
|---|---|---|---|
| Elegoo Smart Robot Car V4.0 chassis (plates, TT motors, wheels) | 1 | ✅ | plates 132.5 × 230.8 × 4.5 mm |
| Raspberry Pi 5, 8 GB | 1 | ✅ | |
| Pi Camera Module 3 | 1 | ✅ | imx708, detected on the Pi |
| Arduino UNO R4 WiFi | 1 | ✅ | base controller under the Elegoo shield, USB to the Pi (ADR-0006) |
| TB6612FNG (Elegoo shield) | 1 | ✅ | VM ≤ 13.5 V |
| MPU-6050 (GY-521) | 1 | ✅ | |
| SG90 servo | 1 | ✅ | camera pan |
| HC-SR04 ultrasonic | 1 | ✅ | owned, not used yet |
| Elegoo 2S battery box | 1 | ✅ | powers the shield and motors today |
| 3S Li-ion 12.6 V 3000 mAh | 1 | ✅ | 70 × 50 × 15 mm (measured) |
| LM2596 buck | 2 | ✅ | for sensors/motor rail only (≤ 2–3 A) |
| 2D LiDAR: SLAMTEC RPLIDAR C1 | 1 | 🚚 | arriving this week |
| TT encoder gear motors | 4 | ⏸ | deferred (ADR-0003) |
| 5 V / 5 A regulator (Pololu D36V50F5) | 1 | 🛒 | Pi 5 supply on battery (v2 design) |
| Fuse holder + 5 A fuse, switch, JST/XT30 connectors | — | 🛒 | |
