mattyjayt/terra-hawk-scout/cad/scout-v2/out/3MF/scout_v2.3mf

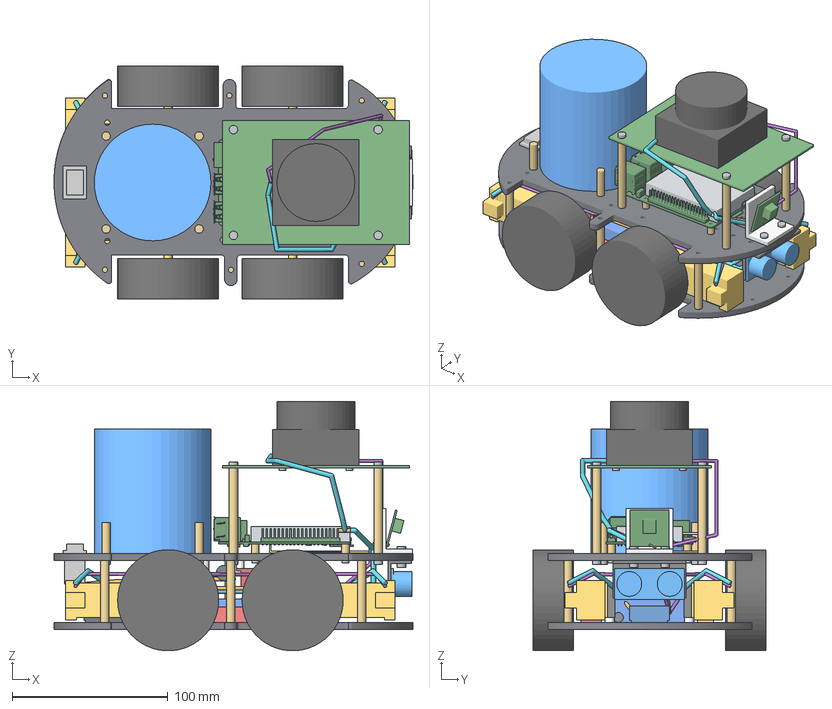
[picture p55: CAD file, 2026-11-03]
cad/scout-v2/out/3MF/scout_v2.3mf
230.8 x 150.0 x 160.3 mm
bottom_plate
top_plate
motor_fl
wheel_fl
motor_bracket_fl
motor_spacer_fl
motor_fr
wheel_fr
motor_bracket_fr
motor_spacer_fr
motor_rl
wheel_rl
motor_bracket_rl
motor_spacer_rl
motor_rr
wheel_rr
motor_bracket_rr
motor_spacer_rr
deck_pillar_1
deck_pillar_2
deck_pillar_3
deck_pillar_4
deck_pillar_5
deck_pillar_6
battery
buck_5v
cap_buck
esp32
xt30
fuse_holder
mdd3a_standoff_1
mdd3a_standoff_2
mdd3a_standoff_3
mdd3a_standoff_4
mdd3a
cap_driver
imu_standoff_1
imu_standoff_2
imu
switch
pi_standoff_1
pi_screw_1
pi_standoff_2
pi_screw_2
pi_standoff_3
pi_screw_3
pi_standoff_4
pi_screw_4
NAUO1
NAUO2
NAUO3 x 2
NAUO5
NAUO6
NAUO7
NAUO8 x 2
NAUO10
NAUO11 x 2
NAUO13
NAUO14
NAUO15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
