mattyjayt/terra-hawk-scout/cad/scout-v2/out/STL/parts/motor_rl.stl

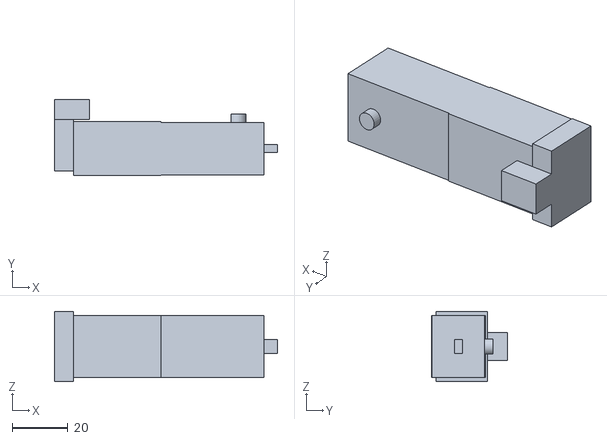
[picture p56: CAD file, 2026-11-03]
cad/scout-v2/out/STL/parts/motor_rl.stl
80.0 x 27.4 x 25.2
