mattyjayt/terra-hawk-scout/cad/scout-v2/out/STL/parts/imu_standoff_2.stl

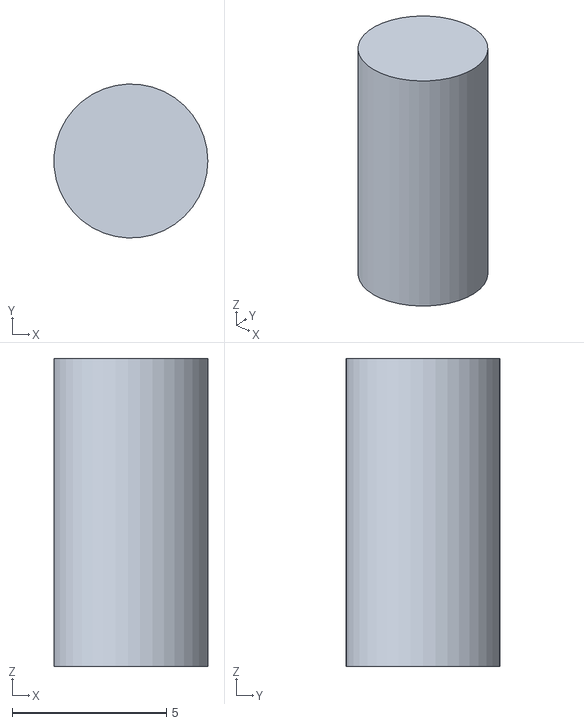
[picture p57: CAD file, 2026-11-03]
cad/scout-v2/out/STL/parts/imu_standoff_2.stl
4.99 x 5.00 x 10.0
