mattyjayt/terra-hawk-scout/cad/scout-v2/out/STL/parts/payload.stl

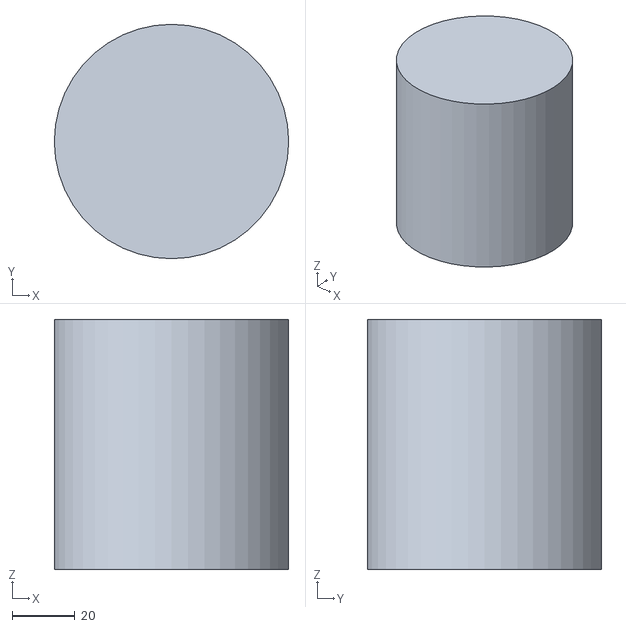
[picture p58: CAD file, 2026-11-03]
cad/scout-v2/out/STL/parts/payload.stl
75.0 x 75.0 x 80.0
