mattyjayt/terra-hawk-scout/cad/scout-v2/out/STL/parts/cable_driver_motor_fr.stl

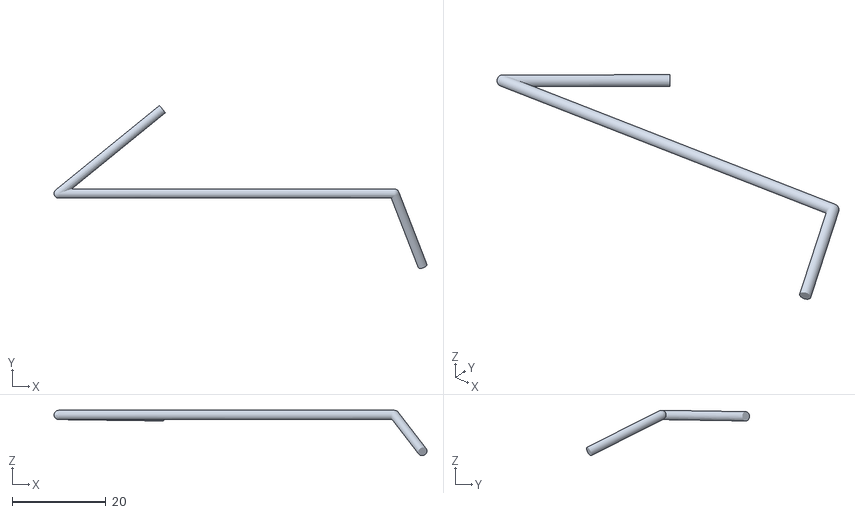
[picture p59: CAD file, 2026-11-03]
cad/scout-v2/out/STL/parts/cable_driver_motor_fr.stl
79.5 x 34.8 x 9.70
