mattyjayt/terra-hawk-scout/cad/scout-v2/out/STL/parts/pi5_cooler.stl

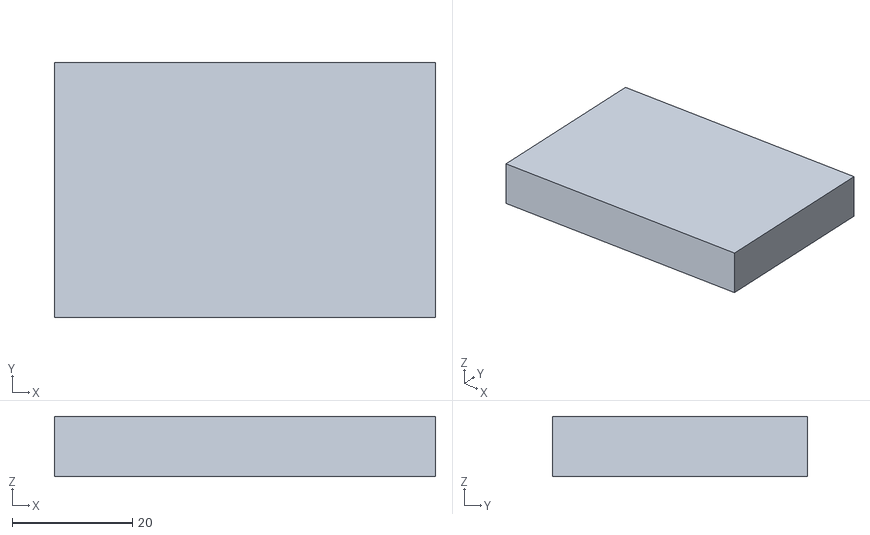
[picture p60: CAD file, 2026-11-03]
cad/scout-v2/out/STL/parts/pi5_cooler.stl
63.5 x 42.5 x 10.0
