mattyjayt/terra-hawk-scout/cad/scout-v2/out/STL/parts/wheel_rl.stl

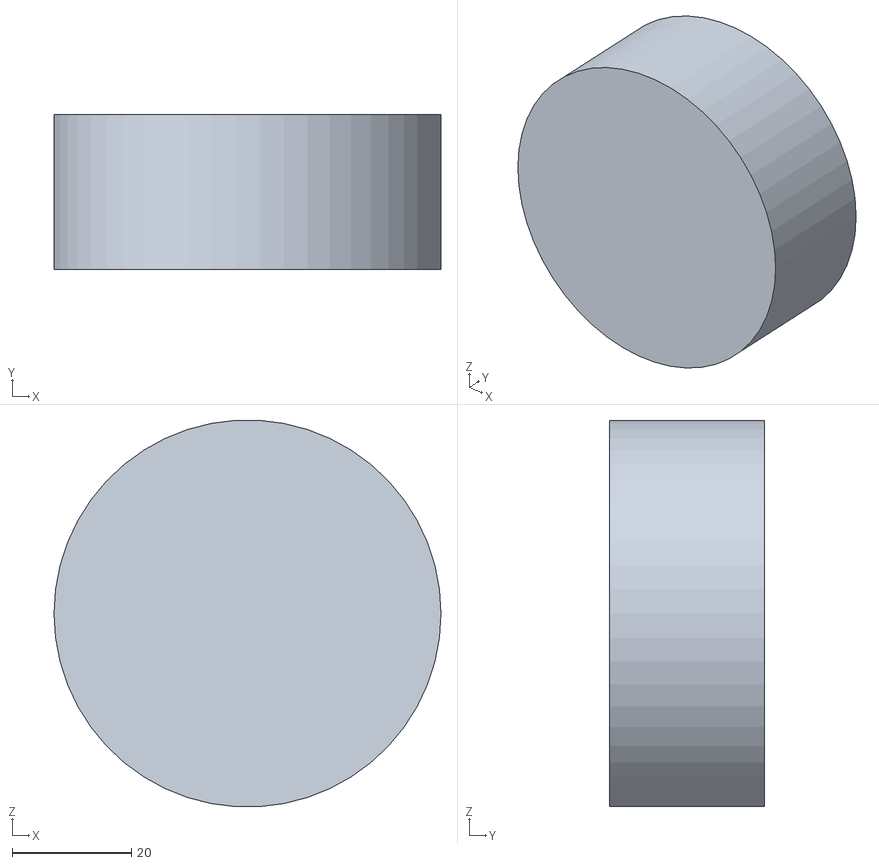
[picture p61: CAD file, 2026-11-03]
cad/scout-v2/out/STL/parts/wheel_rl.stl
65.0 x 26.0 x 64.9
