mattyjayt/terra-hawk-scout/cad/scout-v2/out/STL/parts/pi_standoff_3.stl

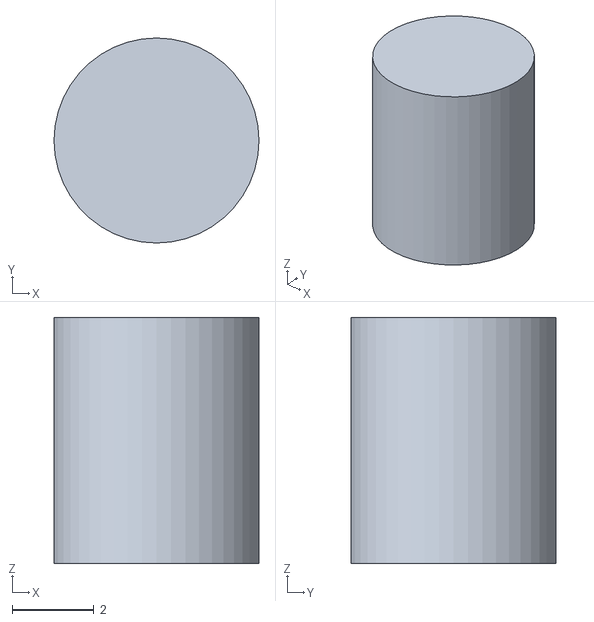
[picture p62: CAD file, 2026-11-03]
cad/scout-v2/out/STL/parts/pi_standoff_3.stl
5.00 x 5.00 x 6.00
