mattyjayt/terra-hawk-scout/cad/scout-v2/out/STL/parts/esp32.stl

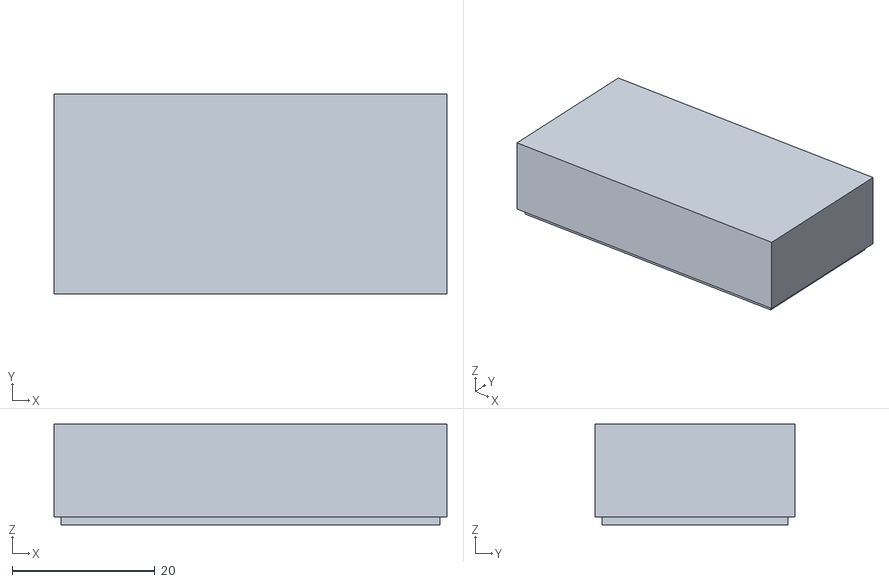
[picture p63: CAD file, 2026-11-03]
cad/scout-v2/out/STL/parts/esp32.stl
55.0 x 28.0 x 14.1
