mattyjayt/terra-hawk-scout/cad/scout-v2/out/STL/parts/cable_buck5_lidar.stl

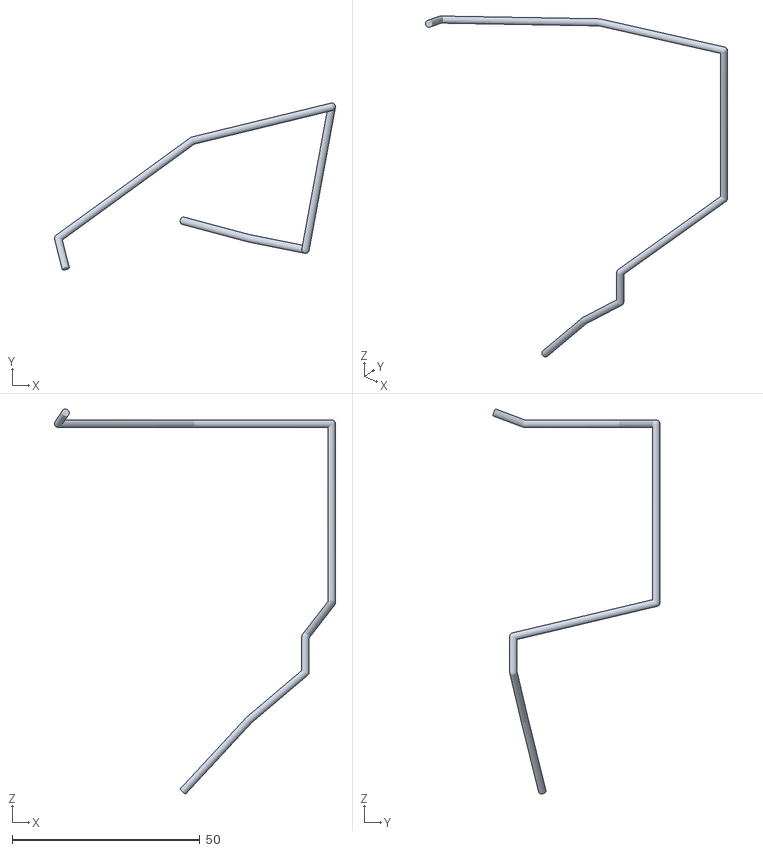
[picture p64: CAD file, 2026-11-03]
cad/scout-v2/out/STL/parts/cable_buck5_lidar.stl
74.8 x 44.4 x 102.4
