mattyjayt/terra-hawk-scout/cad/scout-v2/out/STL/parts/fence_post_2.stl

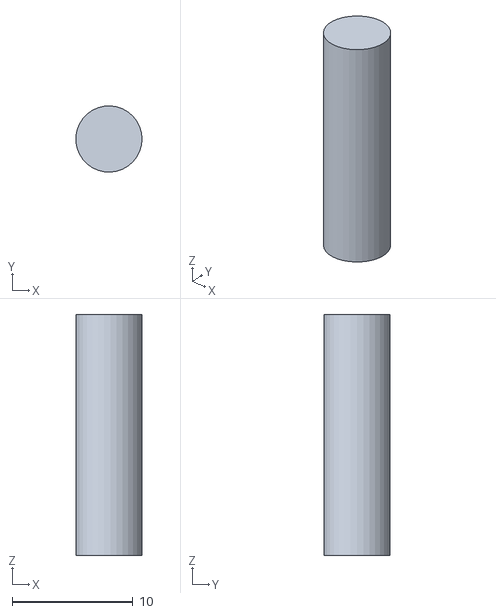
[picture p65: CAD file, 2026-11-03]
cad/scout-v2/out/STL/parts/fence_post_2.stl
5.49 x 5.49 x 20.0
