mattyjayt/terra-hawk-scout/cad/scout-v2/out/STL/parts/cable_driver_motor_rl.stl

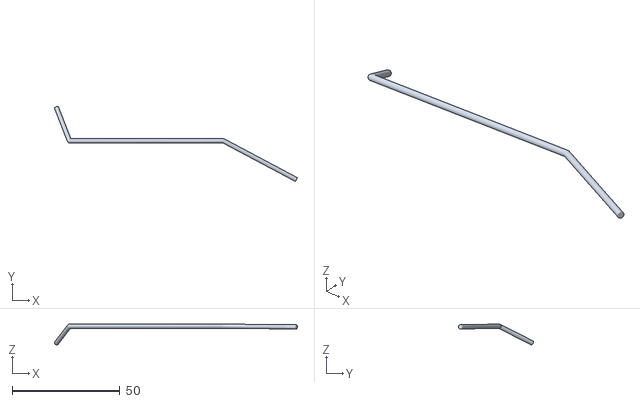
[picture p66: CAD file, 2026-11-03]
cad/scout-v2/out/STL/parts/cable_driver_motor_rl.stl
112.9 x 34.9 x 9.70
