mattyjayt/terra-hawk-scout/cad/scout-v2/out/STL/parts/cable_enc_fl.stl

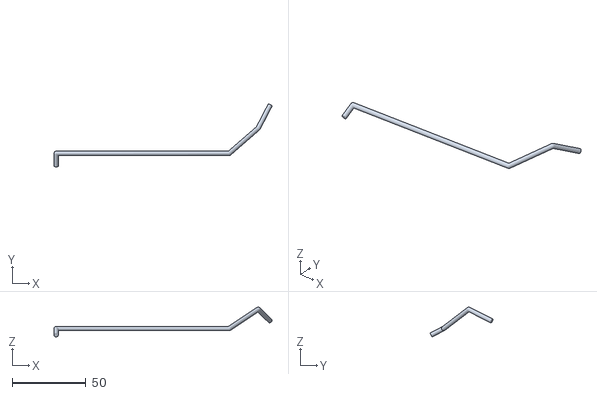
[picture p67: CAD file, 2026-11-03]
cad/scout-v2/out/STL/parts/cable_enc_fl.stl
147.4 x 42.5 x 20.2
