mattyjayt/terra-hawk-scout/cad/scout-v2/out/STL/parts/motor_spacer_rl.stl

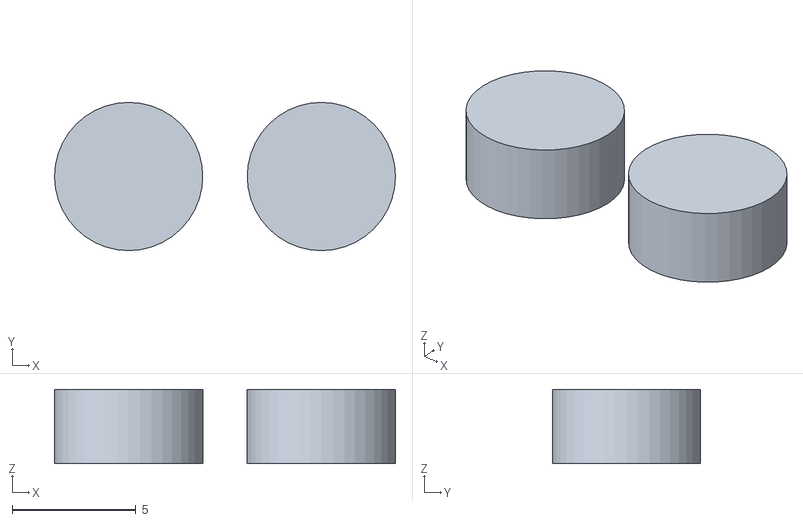
[picture p68: CAD file, 2026-11-03]
cad/scout-v2/out/STL/parts/motor_spacer_rl.stl
13.8 x 6.00 x 3.00
