mattyjayt/terra-hawk-scout/cad/scout-v2/out/STL/parts/mdd3a_standoff_2.stl

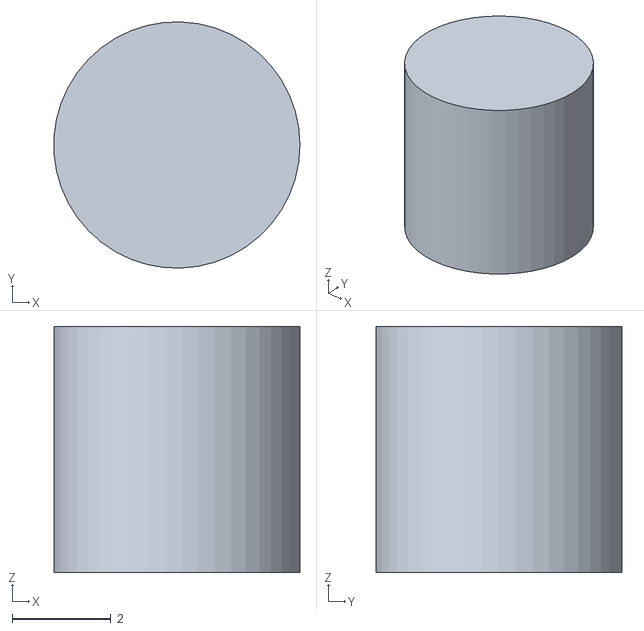
[picture p69: CAD file, 2026-11-03]
cad/scout-v2/out/STL/parts/mdd3a_standoff_2.stl
4.99 x 5.00 x 5.00
