mattyjayt/terra-hawk-scout/cad/scout-v2/out/STL/parts/switch.stl

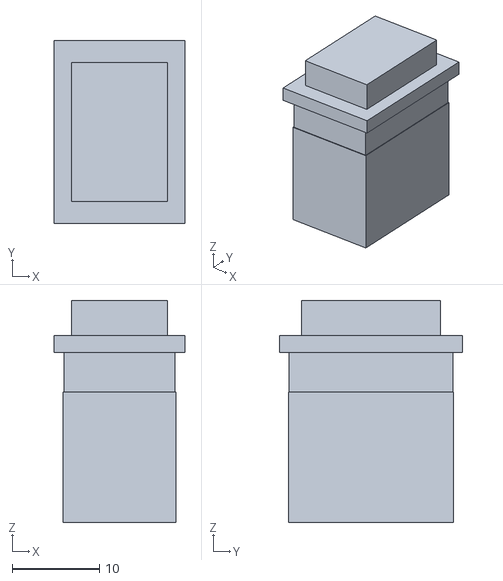
[picture p70: CAD file, 2026-11-03]
cad/scout-v2/out/STL/parts/switch.stl
15.0 x 21.0 x 25.5
