mattyjayt/terra-hawk-scout/cad/scout-v2/out/STL/parts/xt30.stl

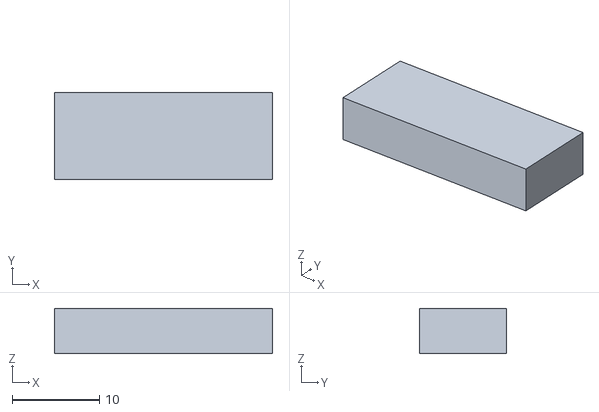
[picture p71: CAD file, 2026-11-03]
cad/scout-v2/out/STL/parts/xt30.stl
25.0 x 10.0 x 5.20
