mattyjayt/terra-hawk-scout/cad/scout-v2/out/STL/parts/camera_mount.stl

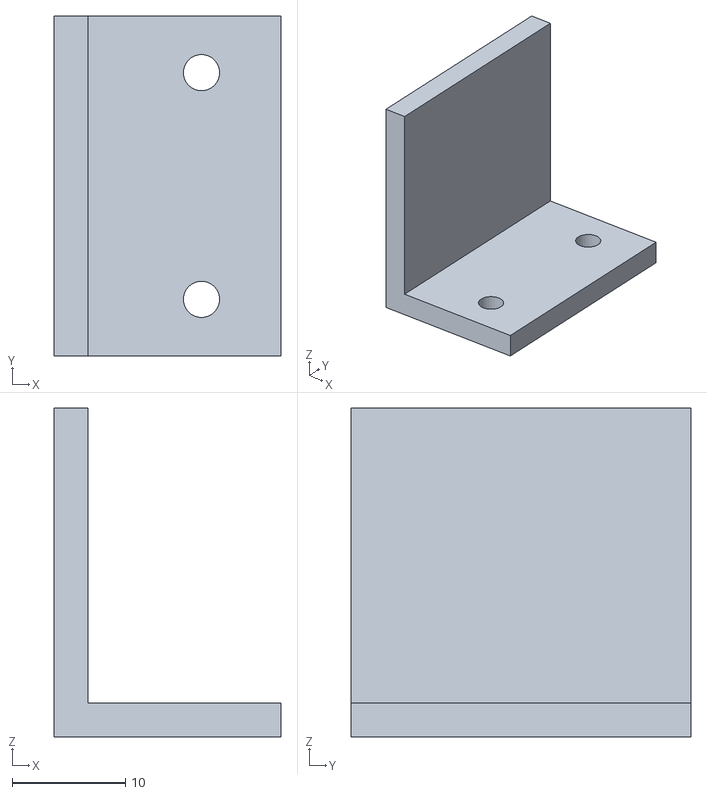
[picture p73: CAD file, 2026-11-03]
cad/scout-v2/out/STL/parts/camera_mount.stl
20.0 x 30.0 x 29.0
