mattyjayt/terra-hawk-scout/cad/scout-v2/out/STL/parts/lidar_leg_2.stl

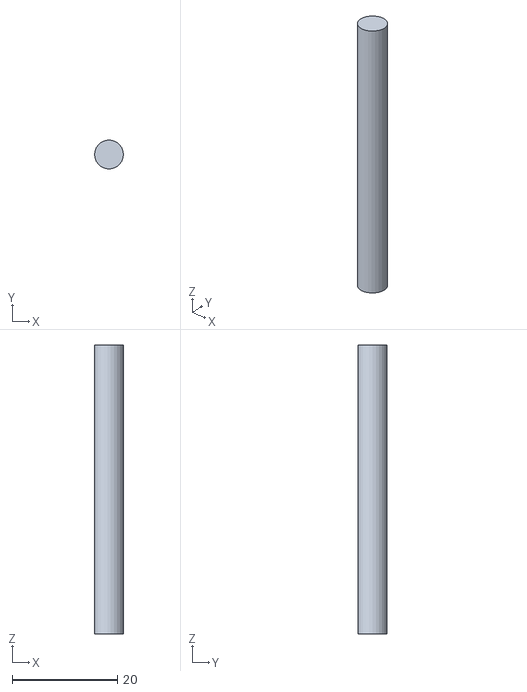
[picture p74: CAD file, 2026-11-03]
cad/scout-v2/out/STL/parts/lidar_leg_2.stl
5.50 x 5.46 x 55.0
