mattyjayt/terra-hawk-scout/cad/scout-v2/out/STL/parts/pi5.stl

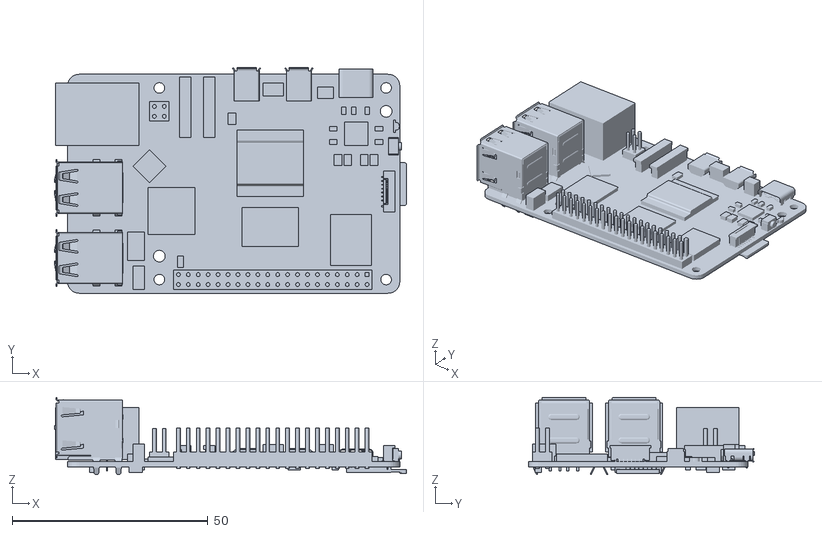
[picture p75: CAD file, 2026-11-03]
cad/scout-v2/out/STL/parts/pi5.stl
90.0 x 57.7 x 19.8
