mattyjayt/terra-hawk-scout/cad/scout-v2/out/STL/parts/cable_switch_buck5.stl

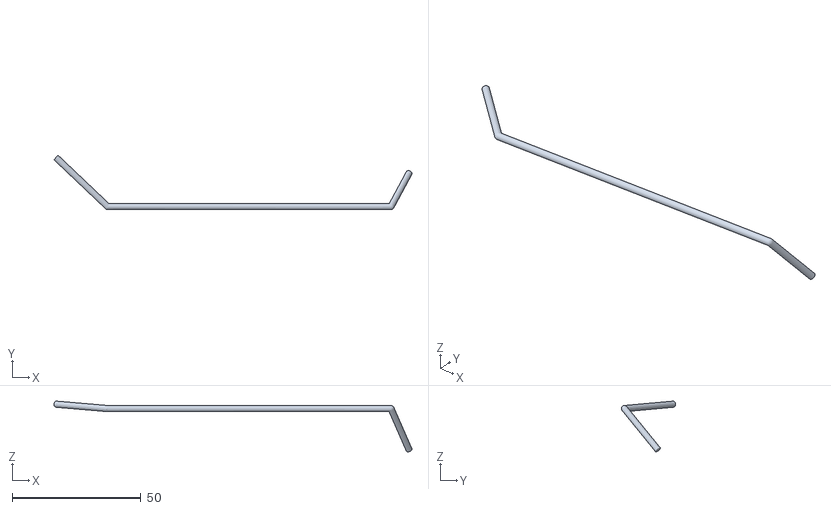
[picture p76: CAD file, 2026-11-03]
cad/scout-v2/out/STL/parts/cable_switch_buck5.stl
139.0 x 21.1 x 19.7
