mattyjayt/terra-hawk-scout/cad/scout-v2/out/STL/parts/motor_bracket_fr.stl

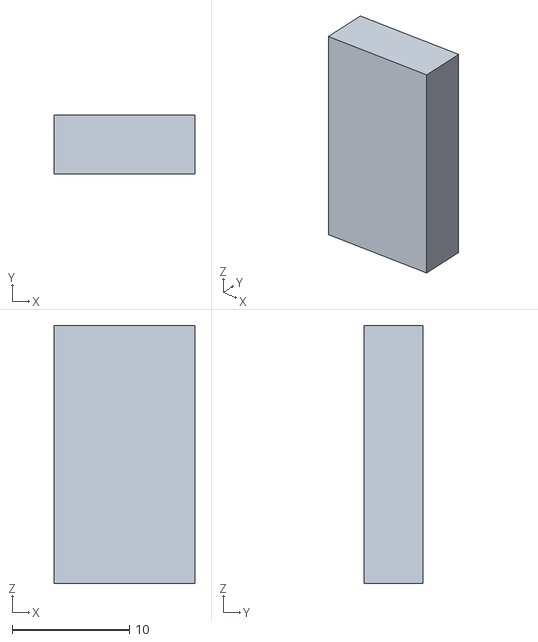
[picture p77: CAD file, 2026-11-03]
cad/scout-v2/out/STL/parts/motor_bracket_fr.stl
12.0 x 5.00 x 22.0
