mattyjayt/terra-hawk-scout/cad/scout-v2/out/STL/parts/cap_buck.stl

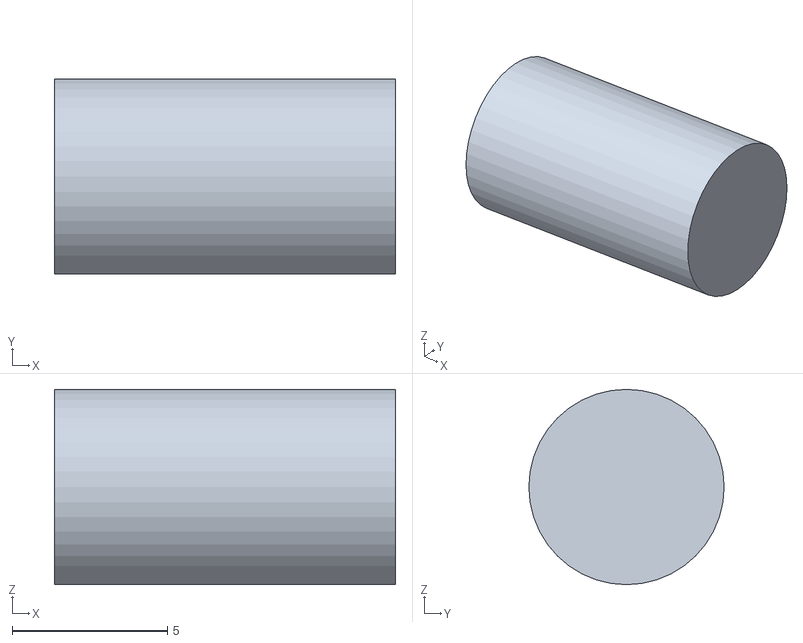
[picture p78: CAD file, 2026-11-03]
cad/scout-v2/out/STL/parts/cap_buck.stl
11.0 x 6.30 x 6.30
