mattyjayt/terra-hawk-scout/cad/scout-v2/out/STL/parts/ultrasonic.stl

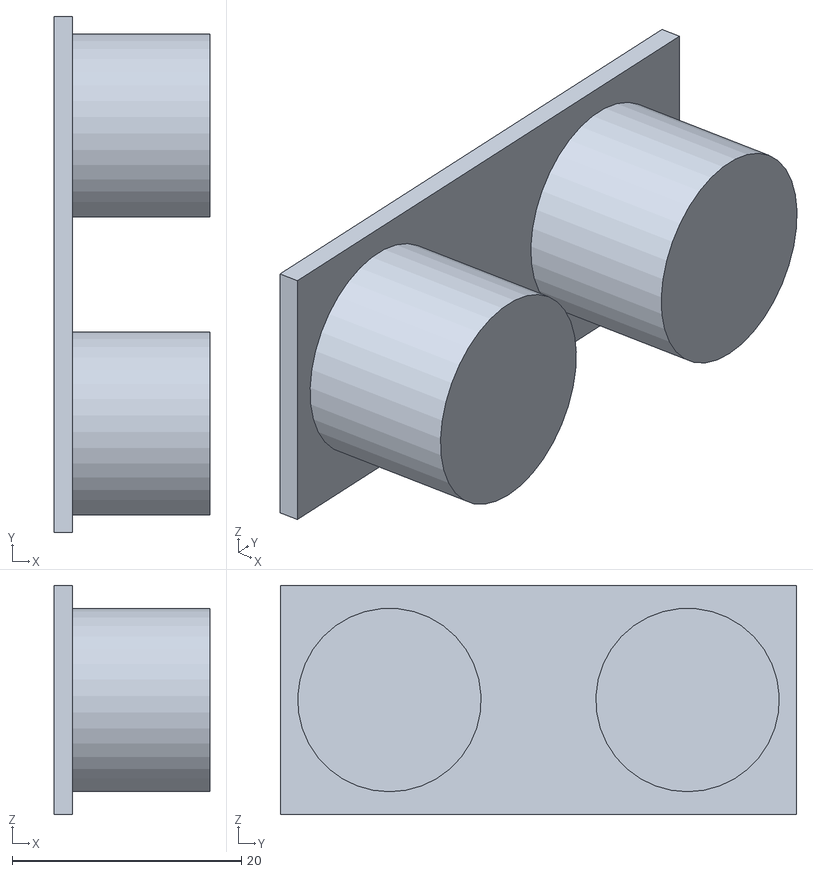
[picture p79: CAD file, 2026-11-03]
cad/scout-v2/out/STL/parts/ultrasonic.stl
13.6 x 45.0 x 20.0
