mattyjayt/terra-hawk-scout/cad/scout-v2/out/STL/parts/top_plate.stl

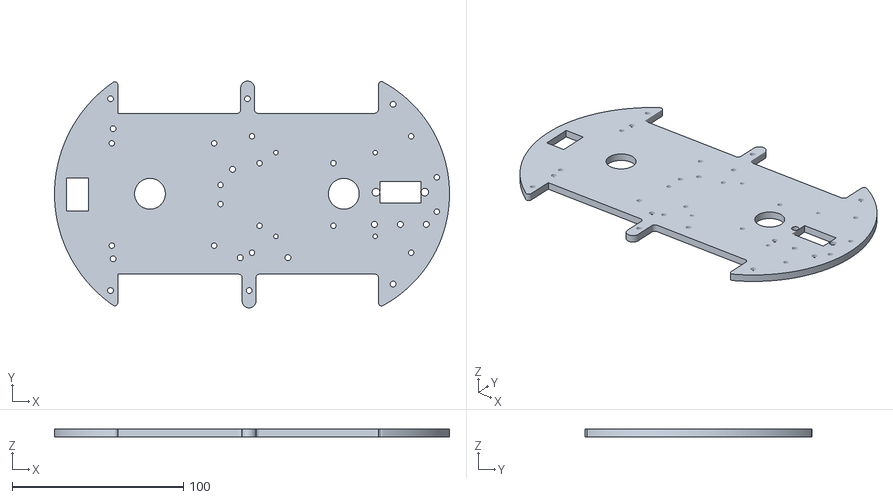
[picture p80: CAD file, 2026-11-03]
cad/scout-v2/out/STL/parts/top_plate.stl
230.8 x 132.5 x 4.50
