mattyjayt/terra-hawk-scout/cad/scout-v2/out/STL/parts/cable_camera_ffc.stl

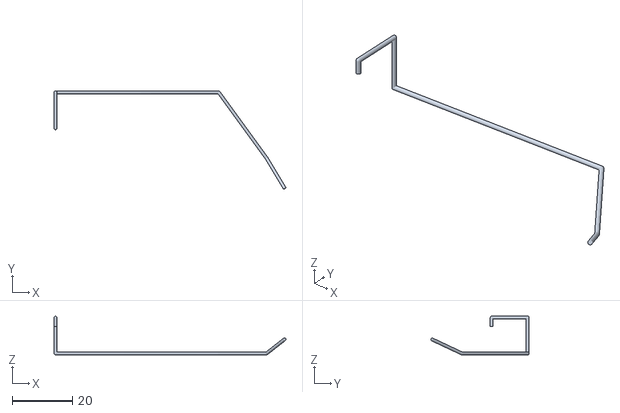
[picture p81: CAD file, 2026-11-03]
cad/scout-v2/out/STL/parts/cable_camera_ffc.stl
77.3 x 32.8 x 12.9
