mattyjayt/terra-hawk-scout/cad/scout-v2/out/STL/parts/cable_driver_esp32.stl

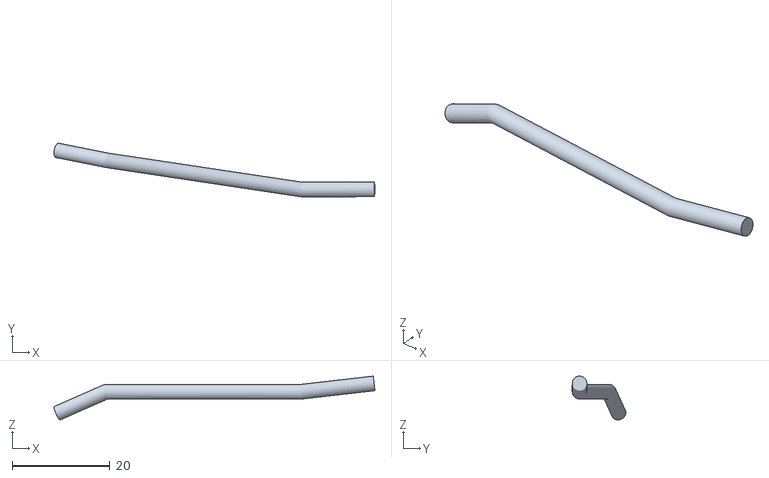
[picture p82: CAD file, 2026-11-03]
cad/scout-v2/out/STL/parts/cable_driver_esp32.stl
65.7 x 11.0 x 8.97
