mattyjayt/terra-hawk-scout/cad/scout-v2/out/STL/parts/fuse_holder.stl

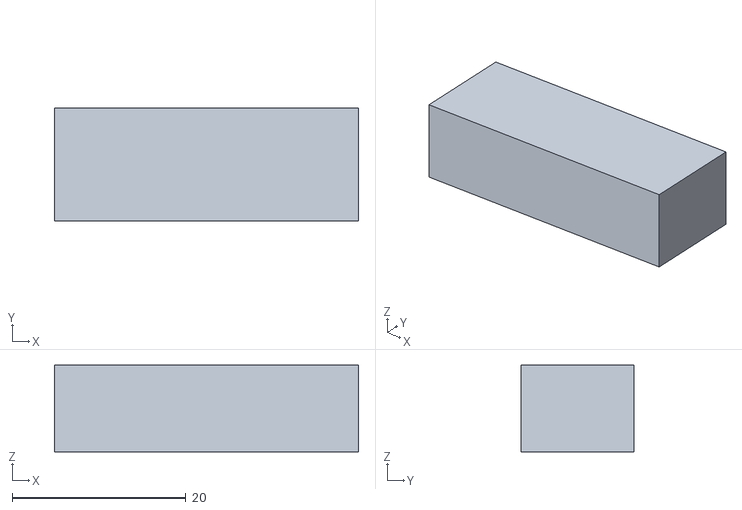
[picture p83: CAD file, 2026-11-03]
cad/scout-v2/out/STL/parts/fuse_holder.stl
35.0 x 13.0 x 10.0
