mattyjayt/terra-hawk-scout/cad/scout-v2/out/STL/parts/deck_pillar_2.stl

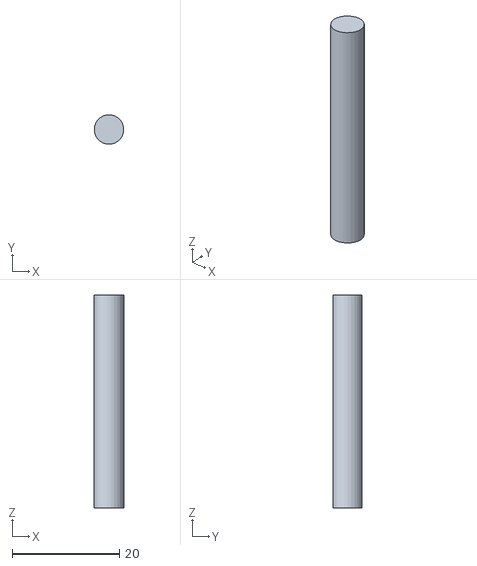
[picture p84: CAD file, 2026-11-03]
cad/scout-v2/out/STL/parts/deck_pillar_2.stl
5.50 x 5.46 x 39.7
