mattyjayt/terra-hawk-scout/cad/scout-v2/out/STL/parts/cable_switch_driver.stl

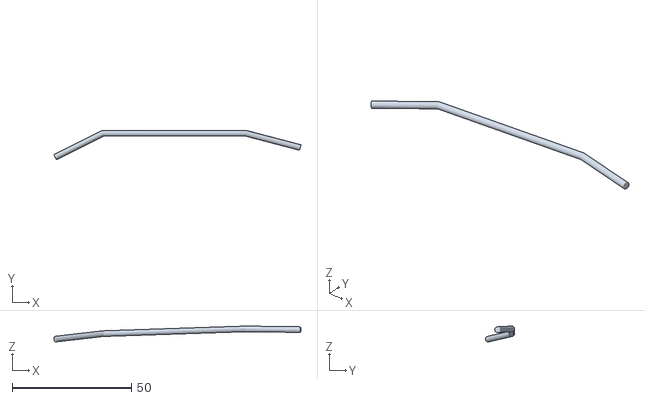
[picture p85: CAD file, 2026-11-03]
cad/scout-v2/out/STL/parts/cable_switch_driver.stl
103.7 x 12.3 x 6.68
