mattyjayt/terra-hawk-scout/cad/scout-v2/out/STL/parts/camera.stl

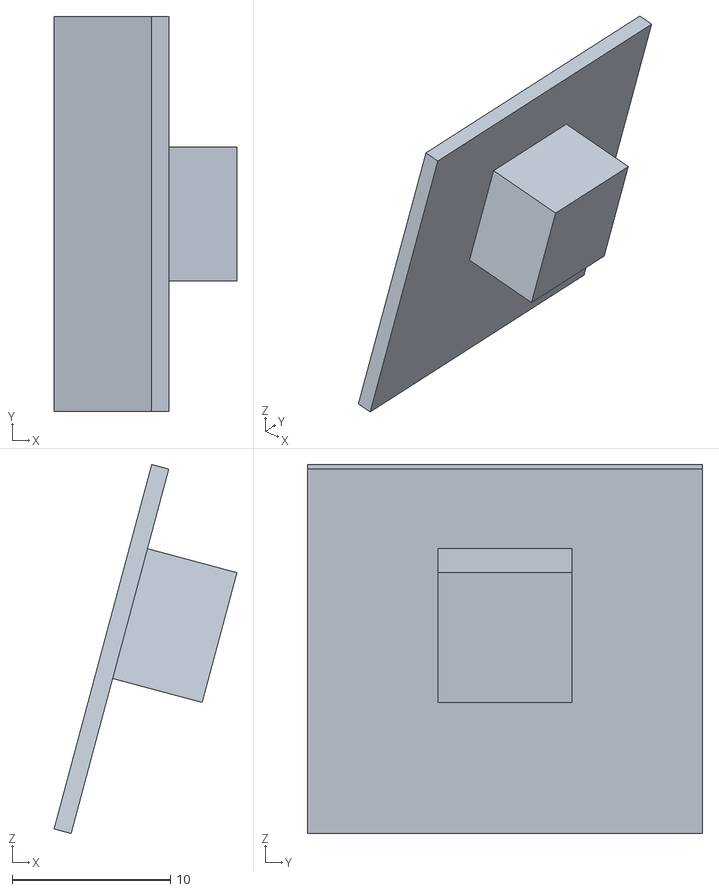
[picture p86: CAD file, 2026-11-03]
cad/scout-v2/out/STL/parts/camera.stl
11.6 x 25.0 x 23.3
