mattyjayt/terra-hawk-scout/cad/scout-v2/out/STL/parts/cable_us_esp32.stl

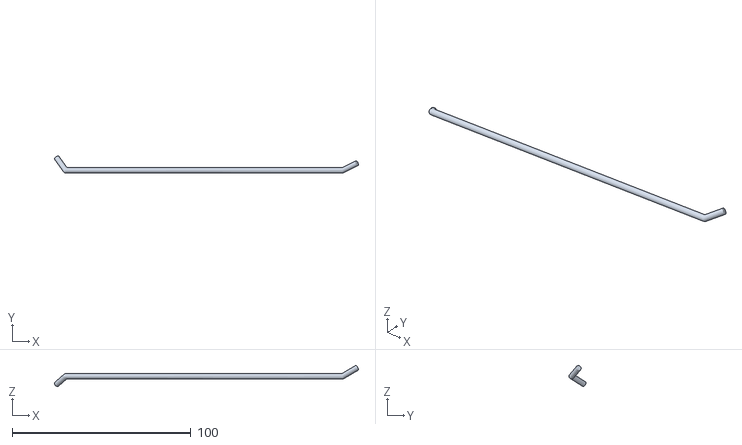
[picture p87: CAD file, 2026-11-03]
cad/scout-v2/out/STL/parts/cable_us_esp32.stl
170.2 x 9.53 x 11.8
