mattyjayt/terra-hawk-scout/cad/scout-v2/out/STL/parts/imu.stl

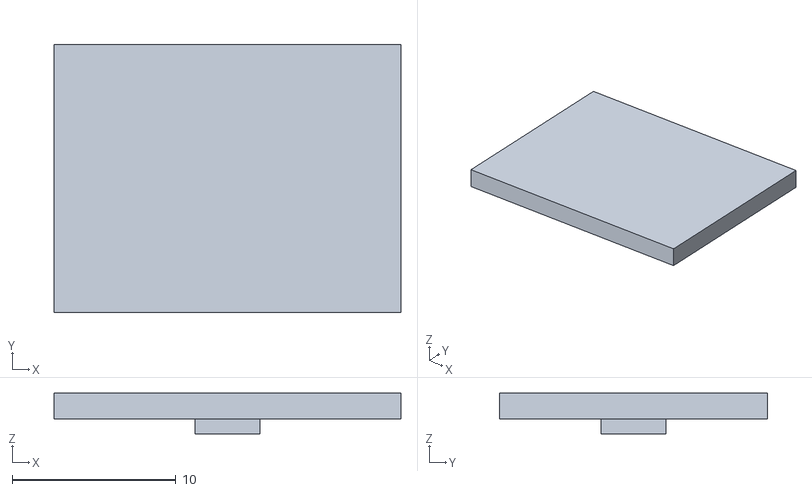
[picture p88: CAD file, 2026-11-03]
cad/scout-v2/out/STL/parts/imu.stl
21.2 x 16.4 x 2.50
