mattyjayt/terra-hawk-scout/cad/scout-v2/out/STL/parts/cable_lidar_uart.stl

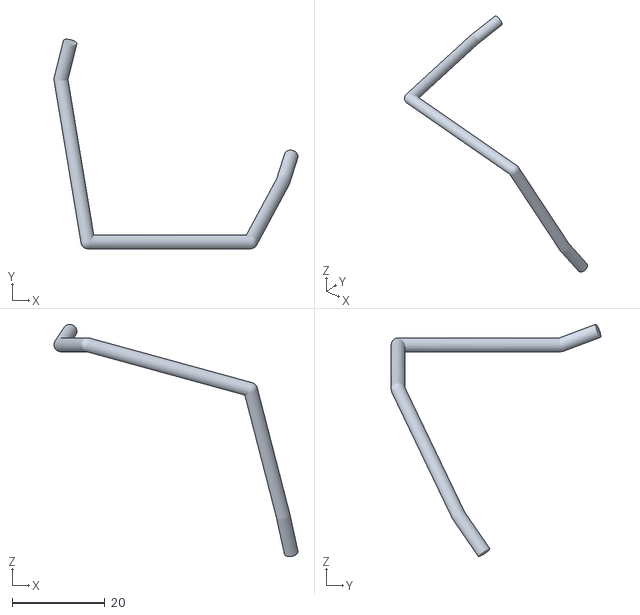
[picture p89: CAD file, 2026-11-03]
cad/scout-v2/out/STL/parts/cable_lidar_uart.stl
52.5 x 45.1 x 50.0
