mattyjayt/terra-hawk-scout/cad/scout-v2/out/STL/parts/cable_batt_xt30.stl

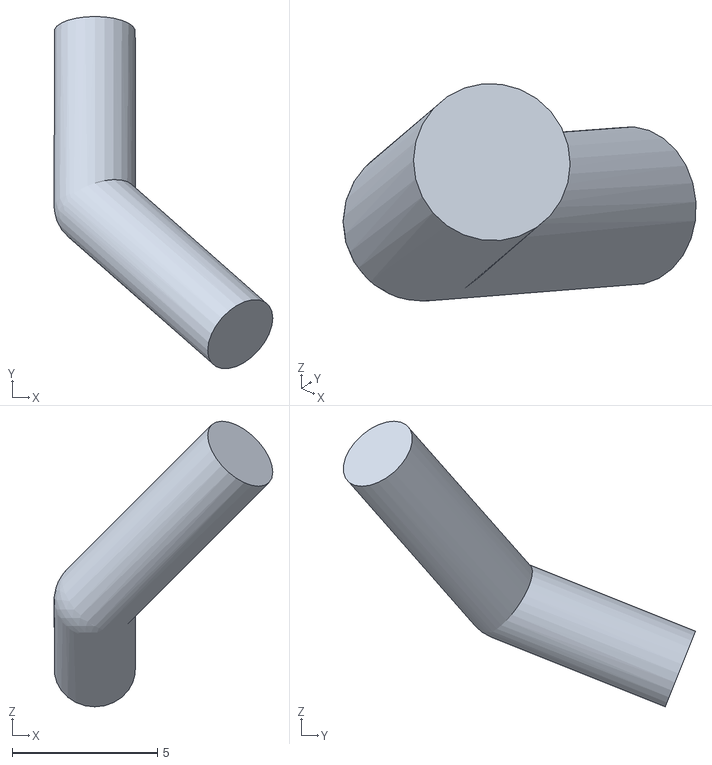
[picture p90: CAD file, 2026-11-03]
cad/scout-v2/out/STL/parts/cable_batt_xt30.stl
7.52 x 12.1 x 9.82
