mattyjayt/terra-hawk-scout/cad/scout-v2/out/STL/parts/cable_5v_esp32.stl

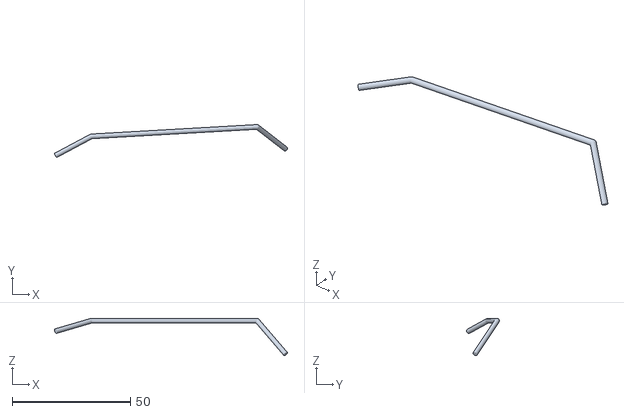
[picture p91: CAD file, 2026-11-03]
cad/scout-v2/out/STL/parts/cable_5v_esp32.stl
98.3 x 13.9 x 15.7
