mattyjayt/terra-hawk-scout/cad/scout-v2/out/STL/parts/cable_esp32_pi.stl

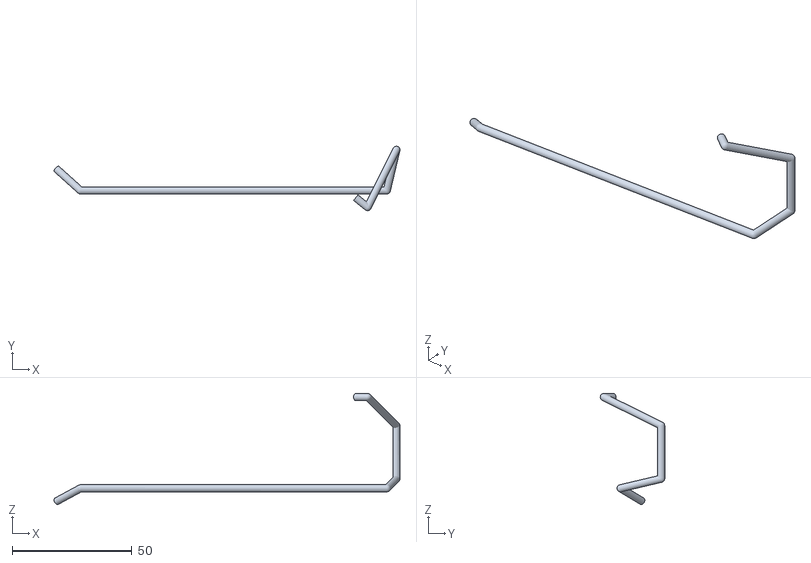
[picture p92: CAD file, 2026-11-03]
cad/scout-v2/out/STL/parts/cable_esp32_pi.stl
144.6 x 27.0 x 46.4
