mattyjayt/terra-hawk-scout/cad/scout-v2/out/STL/parts/cap_driver.stl

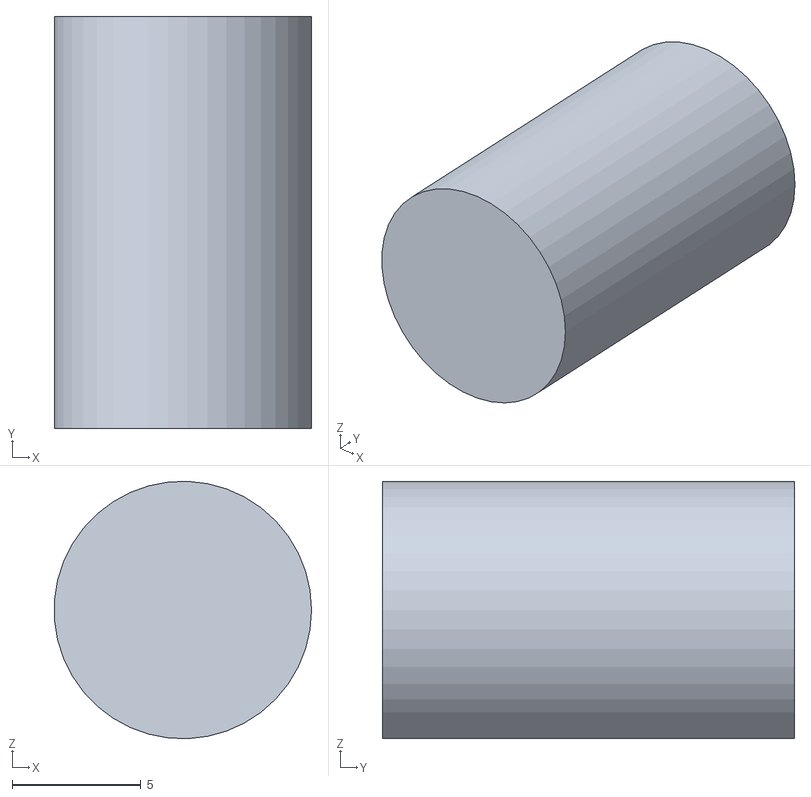
[picture p93: CAD file, 2026-11-03]
cad/scout-v2/out/STL/parts/cap_driver.stl
9.99 x 16.0 x 9.99
