mattyjayt/terra-hawk-scout/cad/scout-v2/out/STL/parts/cable_xt30_fuse.stl

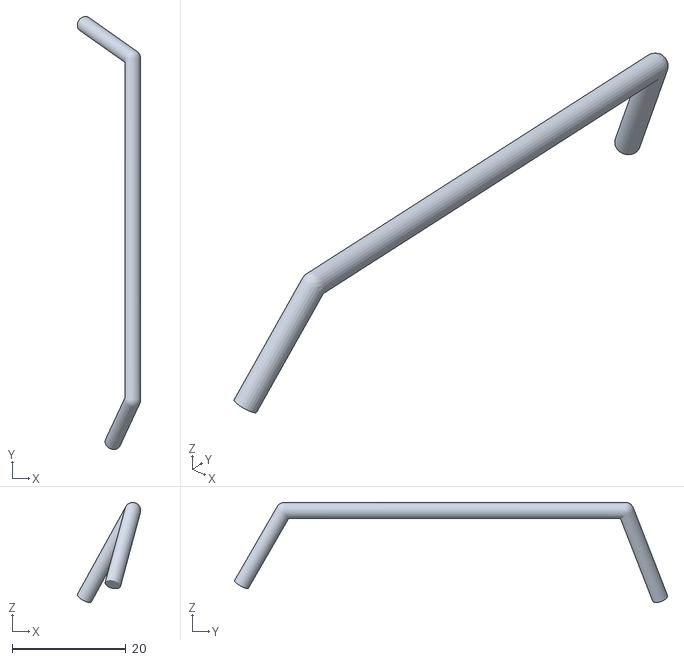
[picture p94: CAD file, 2026-11-03]
cad/scout-v2/out/STL/parts/cable_xt30_fuse.stl
11.1 x 76.0 x 17.6
