mattyjayt/terra-hawk-scout/cad/scout-v2/out/STL/parts/cable_buck5_pi.stl

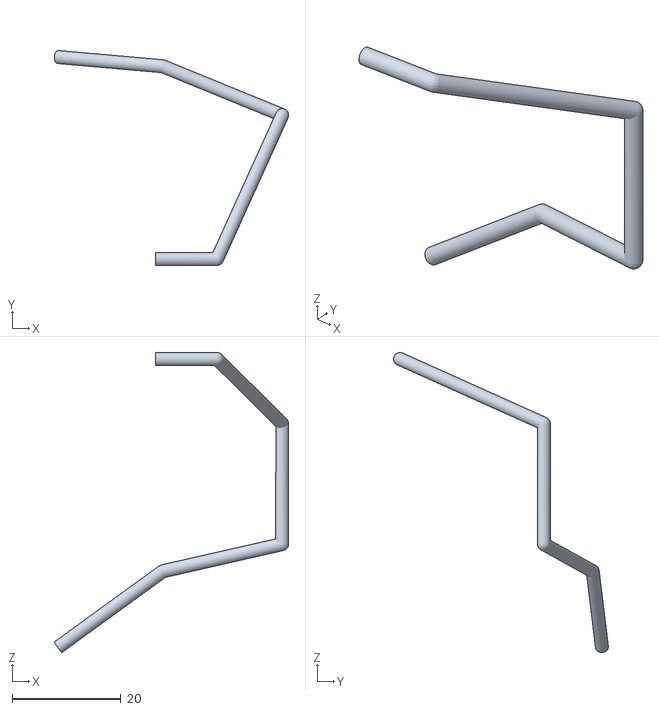
[picture p95: CAD file, 2026-11-03]
cad/scout-v2/out/STL/parts/cable_buck5_pi.stl
43.2 x 39.6 x 55.3
