mattyjayt/terra-hawk-scout/cad/scout-v2/out/STL/parts/battery.stl

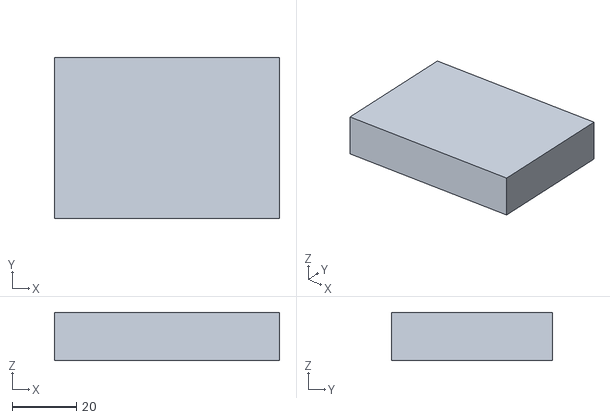
[picture p96: CAD file, 2026-11-03]
cad/scout-v2/out/STL/parts/battery.stl
70.0 x 50.0 x 15.0
