mattyjayt/terra-hawk-scout/cad/scout-v2/out/STL/parts/cable_imu_esp32.stl

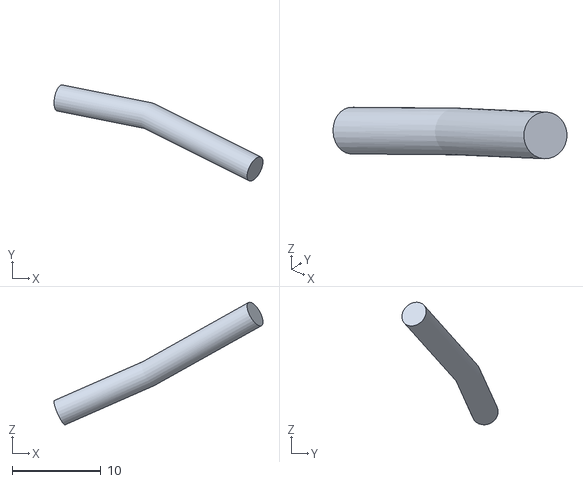
[picture p97: CAD file, 2026-11-03]
cad/scout-v2/out/STL/parts/cable_imu_esp32.stl
23.5 x 10.8 x 13.8
