mattyjayt/terra-hawk-scout/cad/scout-v2/out/STL/parts/buck_5v.stl

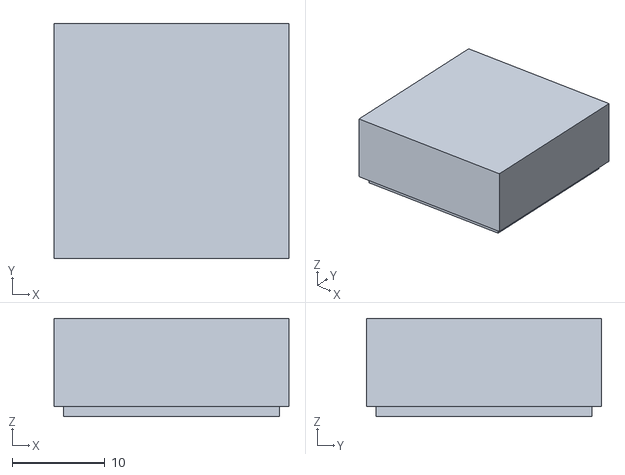
[picture p98: CAD file, 2026-11-03]
cad/scout-v2/out/STL/parts/buck_5v.stl
25.4 x 25.4 x 10.6
