mattyjayt/terra-hawk-scout/cad/scout-v2/out/STL/parts/lidar_board.stl

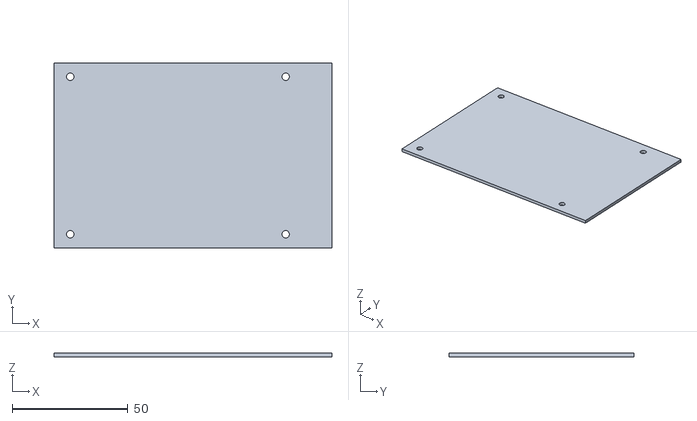
[picture p99: CAD file, 2026-11-03]
cad/scout-v2/out/STL/parts/lidar_board.stl
120.0 x 80.0 x 1.60
