mattyjayt/terra-hawk-scout/cad/scout-v2/out/STL/parts/cable_fuse_switch.stl

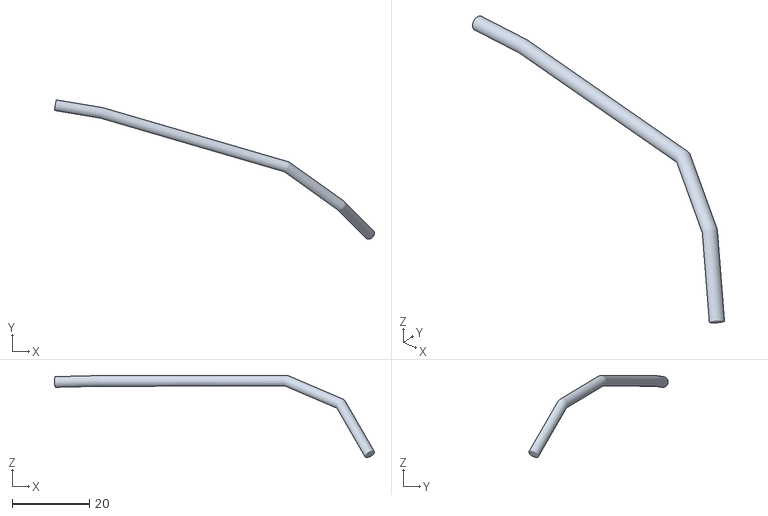
[picture p100: CAD file, 2026-11-03]
cad/scout-v2/out/STL/parts/cable_fuse_switch.stl
83.0 x 36.1 x 21.3
