mattyjayt/terra-hawk-scout/cad/scout-v2/out/STL/parts/ultrasonic_bracket.stl

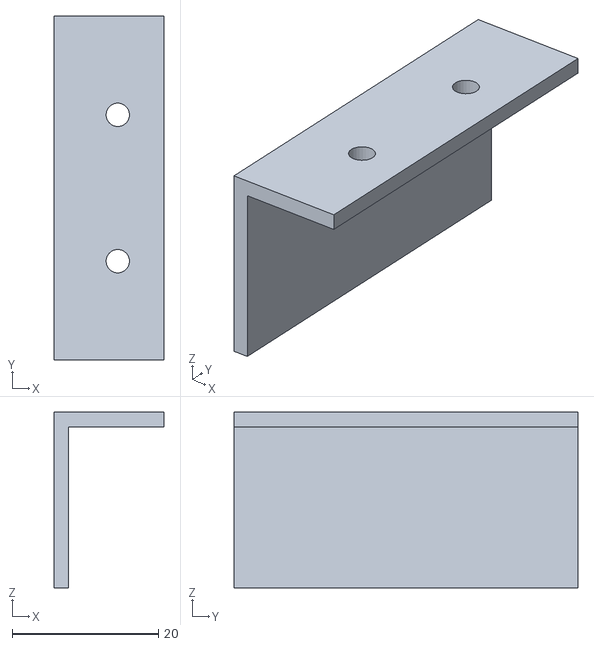
[picture p101: CAD file, 2026-11-03]
cad/scout-v2/out/STL/parts/ultrasonic_bracket.stl
15.0 x 47.0 x 24.0
