mattyjayt/terra-hawk-scout/cad/scout-v2/out/STL/parts/mdd3a.stl

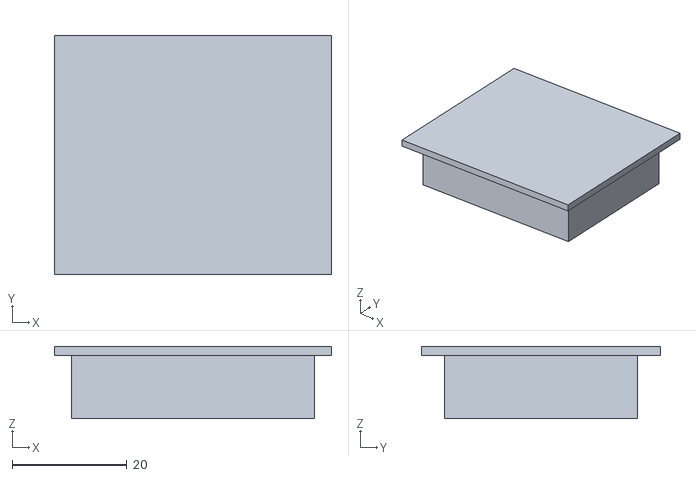
[picture p102: CAD file, 2026-11-03]
cad/scout-v2/out/STL/parts/mdd3a.stl
48.3 x 41.7 x 12.6
