mattyjayt/terra-hawk-scout/cad/scout-v2/out/STL/parts/lidar.stl

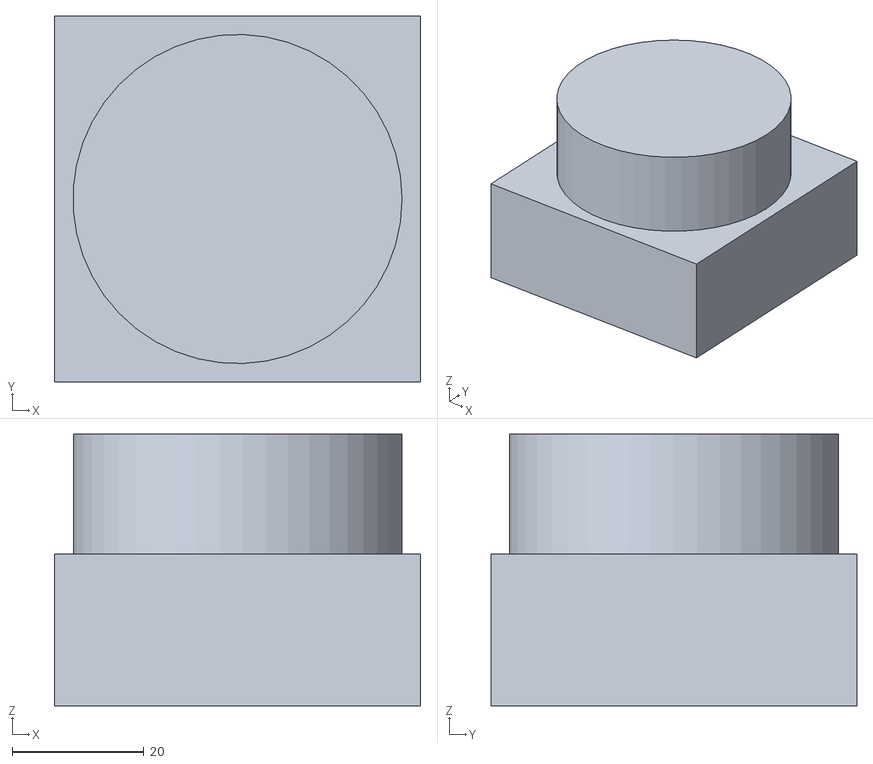
[picture p103: CAD file, 2026-11-03]
cad/scout-v2/out/STL/parts/lidar.stl
55.6 x 55.6 x 41.3
