mattyjayt/terra-hawk-scout/(list of files, cad)

Other CAD files:
cad/scout-v2/out/STL/parts/imu_standoff_1.stl
cad/scout-v2/out/STL/parts/cable_driver_motor_fl.stl
cad/scout-v2/out/STL/parts/wheel_fr.stl
cad/scout-v2/out/STL/parts/motor_spacer_fl.stl
cad/scout-v2/out/STL/parts/lidar_leg_1.stl
cad/scout-v2/out/STL/parts/fence_post_3.stl
cad/scout-v2/out/STL/parts/motor_rr.stl
cad/scout-v2/out/STL/parts/motor_bracket_rl.stl
cad/scout-v2/out/STL/parts/pi_standoff_1.stl
cad/scout-v2/out/STL/parts/motor_fl.stl
cad/scout-v2/out/STL/parts/pi_standoff_4.stl
cad/scout-v2/out/STL/parts/cable_enc_fr.stl
cad/scout-v2/out/STL/parts/cable_driver_motor_rr.stl
cad/scout-v2/out/STL/parts/motor_spacer_rr.stl
cad/scout-v2/out/STL/parts/mdd3a_standoff_3.stl
cad/scout-v2/out/STL/parts/fence_post_1.stl
cad/scout-v2/out/STL/parts/deck_pillar_4.stl
cad/scout-v2/out/STL/parts/deck_pillar_6.stl
cad/scout-v2/out/STL/parts/mdd3a_standoff_1.stl
cad/scout-v2/out/STL/parts/motor_bracket_rr.stl
cad/scout-v2/out/STL/parts/fence_post_4.stl
cad/scout-v2/out/STL/parts/bottom_plate.stl
cad/scout-v2/out/STL/parts/cable_enc_rr.stl
cad/scout-v2/out/STL/parts/lidar_leg_3.stl
cad/scout-v2/out/STL/parts/deck_pillar_1.stl
cad/scout-v2/out/STL/parts/pi_standoff_2.stl
cad/scout-v2/out/STL/parts/deck_pillar_3.stl
cad/scout-v2/out/STL/parts/motor_spacer_fr.stl
cad/scout-v2/out/STL/parts/lidar_leg_4.stl
cad/scout-v2/out/STL/parts/mdd3a_standoff_4.stl
cad/scout-v2/out/STL/parts/wheel_fl.stl
cad/scout-v2/out/STL/parts/motor_bracket_fl.stl
cad/scout-v2/out/STL/parts/wheel_rr.stl
cad/scout-v2/out/STL/parts/motor_fr.stl
cad/scout-v2/out/STL/parts/deck_pillar_5.stl
cad/scout-v2/out/STL/parts/fence_nut_1.stl
cad/scout-v2/out/STL/parts/fence_nut_2.stl
cad/scout-v2/out/STL/parts/fence_nut_3.stl
cad/scout-v2/out/STL/parts/fence_nut_4.stl
cad/scout-v2/out/STL/parts/front_screw_1.stl
cad/scout-v2/out/STL/parts/front_screw_2.stl
cad/scout-v2/out/STL/parts/lidar_board_screw_1.stl
cad/scout-v2/out/STL/parts/lidar_board_screw_2.stl
cad/scout-v2/out/STL/parts/lidar_board_screw_3.stl
cad/scout-v2/out/STL/parts/lidar_board_screw_4.stl
cad/scout-v2/out/STL/parts/lidar_leg_screw_1.stl
cad/scout-v2/out/STL/parts/lidar_leg_screw_2.stl
cad/scout-v2/out/STL/parts/lidar_leg_screw_3.stl
cad/scout-v2/out/STL/parts/lidar_leg_screw_4.stl
cad/scout-v2/out/STL/parts/lidar_screw_1.stl
cad/scout-v2/out/STL/parts/lidar_screw_2.stl
cad/scout-v2/out/STL/parts/lidar_screw_3.stl
cad/scout-v2/out/STL/parts/lidar_screw_4.stl
cad/scout-v2/out/STL/parts/pi_screw_1.stl
cad/scout-v2/out/STL/parts/pi_screw_2.stl
cad/scout-v2/out/STL/parts/pi_screw_3.stl
cad/scout-v2/out/STL/parts/pi_screw_4.stl
cad/scout-v2/out/STL/scout_v2.stl
