mattyjayt/terra-hawk-scout/cad/scout-v2/guide/index.html

Build guide · CAD round 3 · 2026-11-01

# Scout v2 assembly

The redesigned Elegoo Smart Robot Car V4.0: RPLIDAR C1, four Hiwonder encoder motors, Cytron MDD3A, Pololu 5 V buck, Pi 5 + ESP32. Orbit the model, explode it, or play the nine-step build.

Mass + cup

1.298 kg

Scan plane

148.9 mm

Ground clr.

13.8 mm

Front / rear

49 / 51

loading model…

Assembled Exploded Assembly animation

▶

0.00 / 16.40 s

Step01

Each step flies in over 1.6 s (step n starts at (n−1)·1.6 s). New parts in colour on the build cards below; drag to orbit, pinch or scroll to zoom.

01

## Build steps

Nine steps, same order as the animation. Each card lists the parts that go on, the check to pass before moving on, and jumps the 3D view to that step. Pictures: new parts in colour, earlier parts grey; step 05 is drawn lifted and seen from below; from step 06 the top plate is translucent.

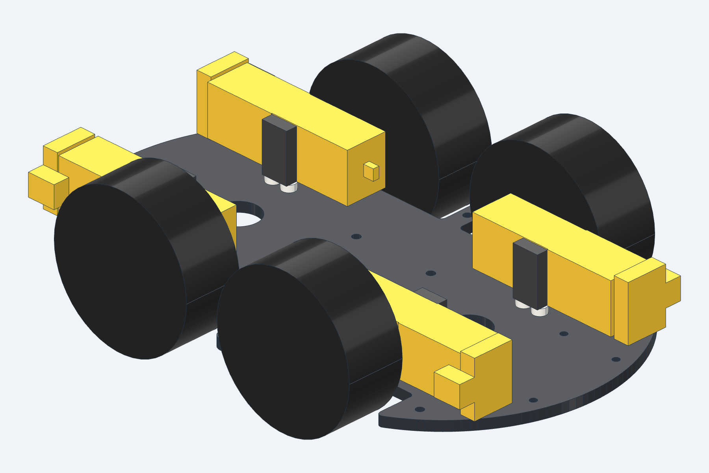
[picture p104: cad/scout-v2/assembly/step01.png]
Step 01: Bottom plate: motor spacers + Elegoo brackets, Hiwonder encoder motors, wheels


01

### Bottom plate: motor spacers + Elegoo brackets, Hiwonder encoder motors, wheels

Parts

- 1×Elegoo Smart Robot Car V4.0 bottom plate
- 4×M3 nylon round spacer 3 mm (2 per bracket)
- 4×Elegoo kit TT motor holder
- 4×Hiwonder TT Hall-encoder gear motor 1:42, plastic shaft
- 4×Elegoo kit 65 mm wheel

✓

Check

Wheels spin free; 1 mm nylon washer behind a wheel if it rubs (wheel–plate gap 1.57 mm)

▶ Show in 3D t = 0.0 s

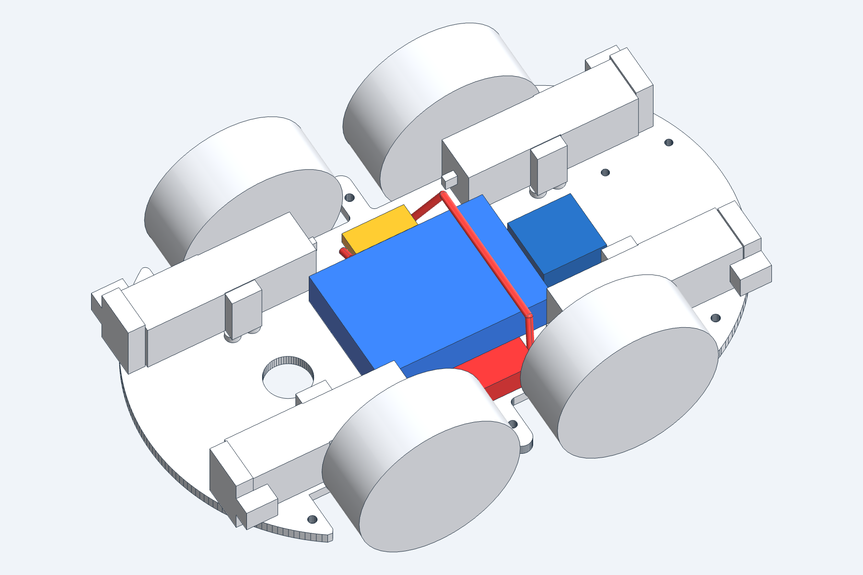
[picture p105: cad/scout-v2/assembly/step02.png]
Step 02: Lower-deck power: battery, XT30, 7.5 A fuse holder, D36V50F5 5 V buck (+100 uF)


02

### Lower-deck power: battery, XT30, 7.5 A fuse holder, D36V50F5 5 V buck (+100 uF)

Parts

- 1×Blue 3S Li-ion pack 70 x 50 x 15, 11.1 V 3000 mAh label
- 1×AMASS XT30U-M/F pair
- 1×Inline ATM mini-blade fuse holder (18 AWG) + 7.5 A ATM fuse
- 1×Pololu D36V50F5 5 V 5.5 A step-down regulator
- 1×100 uF / 25 V radial electrolytic D6.3 x 11 (buck VIN)
- ⌁Leads: batt_xt30, xt30_fuse

✓

Check

Battery centred on the centre of rotation; XT30 polarity checked before the fuse goes in; ≥2.2 mm side clearance

▶ Show in 3D t = 1.6 s

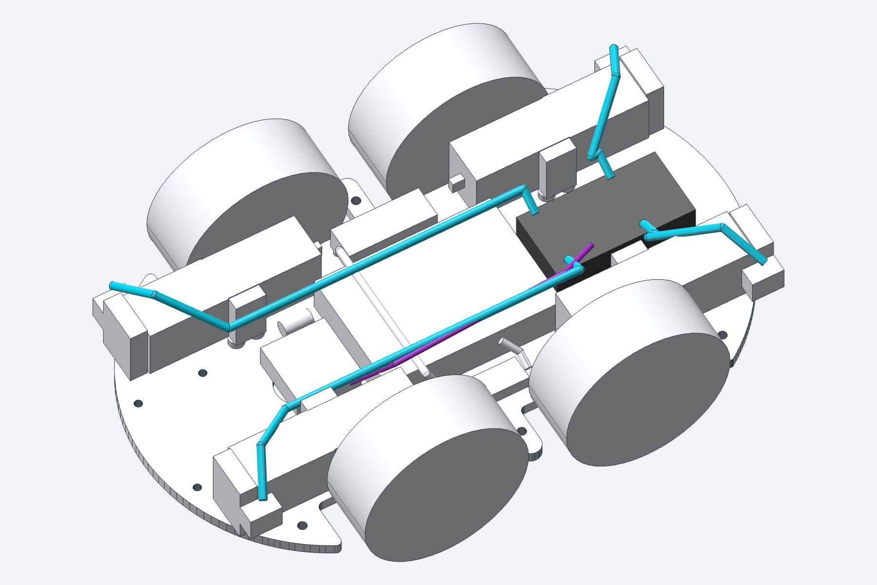
[picture p106: cad/scout-v2/assembly/step03.png]
Step 03: ESP32 in the rear bay + encoder and 5 V leads


03

### ESP32 in the rear bay + encoder and 5 V leads

Parts

- 1×ESP32 DevKit WROOM-32 USB-C
- ⌁Leads: 5v_esp32, enc_*

✓

Check

ESP32 at the rear clears the encoder connectors and the XT30/fuse

▶ Show in 3D t = 3.2 s

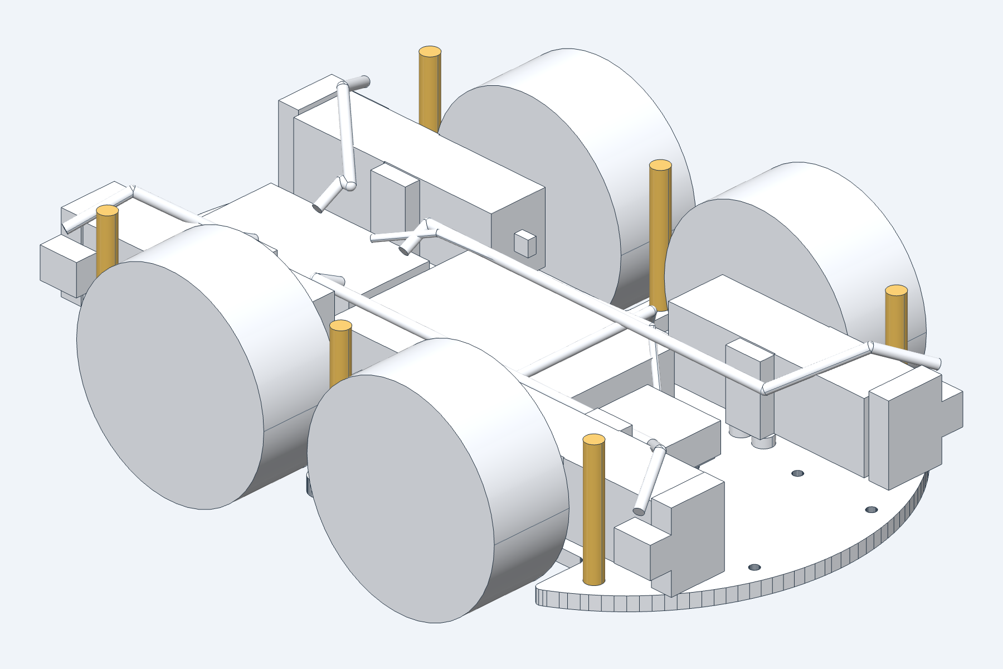
[picture p107: cad/scout-v2/assembly/step04.png]
Step 04: Deck pillars (Elegoo M3 brass)


04

### Deck pillars (Elegoo M3 brass)

Parts

- 6×Elegoo kit M3 brass hex pillar, 39.7 mm between the decks

✓

Check

Pillars square, no wire pinched under the top plate (assumed check)

▶ Show in 3D t = 4.8 s

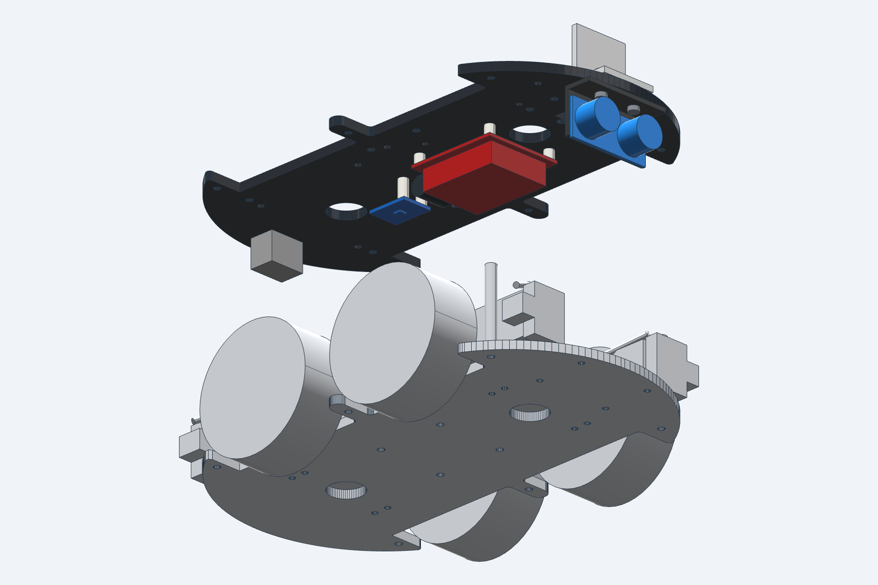
[picture p108: cad/scout-v2/assembly/step05.png]
Step 05: Top plate pre-fit on the bench: drill, MDD3A + 470 uF, IMU (chip down), rocker switch, HC-SR04 + camera holder


05

### Top plate pre-fit on the bench: drill, MDD3A + 470 uF, IMU (chip down), rocker switch, HC-SR04 + camera holder

Parts

- 1×Elegoo Smart Robot Car V4.0 top plate, drilled per the drilling table
- 4×M3 x 5 nylon hex F-F standoff + M3 x 6 nylon screws
- 1×Cytron MDD3A 4-16 V 3 A dual DC motor driver
- 1×470 uF / 25 V low-ESR radial electrolytic D10 x 16 (Panasonic EEU-FR1E471)
- 2×M3 x 10 nylon hex F-F standoff + M3 x 6 nylon screws
- 1×GY-521 MPU-6050 breakout
- 1×KCD1-form-factor SPST rocker, >= 10 A @ 12 VDC rated (DC rating to confirm on the listing)
- 1×generic HC-SR04 L-mount bracket (acrylic/ABS, 2 x M3 base holes)
- 1×HC-SR04 ultrasonic sensor
- 1×generic tilt-adjustable acrylic Raspberry Pi camera holder (2-piece, hinge screw), locked at 15 deg down
- 2×M3 x 12 pan screw + M3 nut (camera holder + HC-SR04 bracket, shared)

✓

Check

Bench pre-fit before mounting: MDD3A on nylon standoffs underneath, IMU within 25 mm of the CoR (x ≈ −25 mm), ≥10 A DC switch cut-out drilled

▶ Show in 3D t = 6.4 s

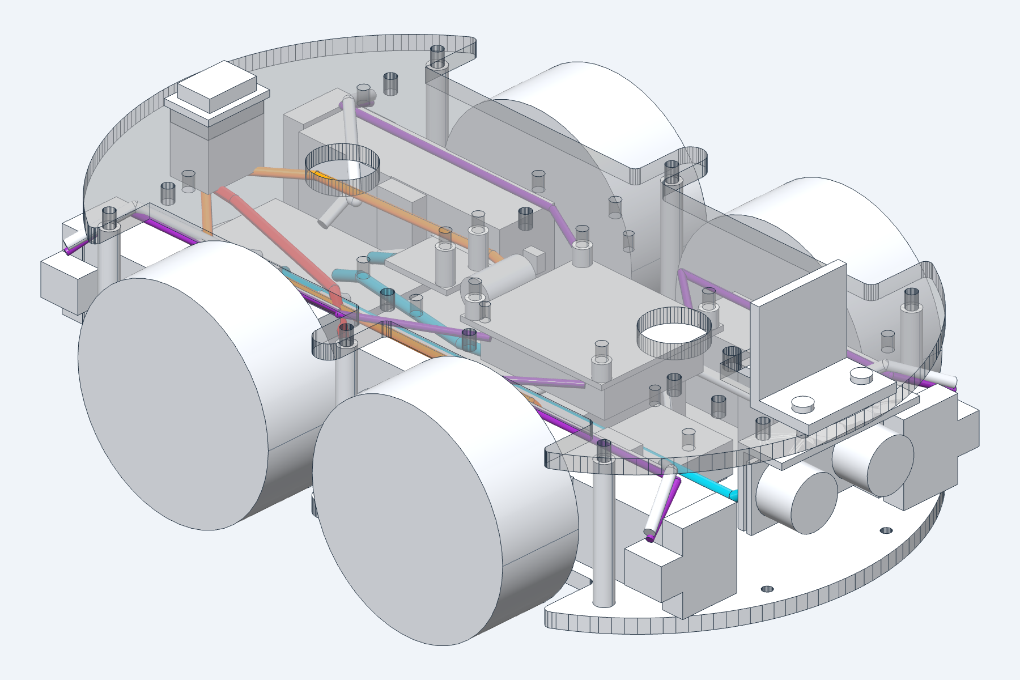
[picture p109: cad/scout-v2/assembly/step06.png]
Step 06: Close the decks: top plate on the pillars; fuse -> switch -> MDD3A / buck, motor and signal leads


06

### Close the decks: top plate on the pillars; fuse -> switch -> MDD3A / buck, motor and signal leads

Parts

- ⌁Leads: driver_esp32, driver_motor_*, fuse_switch, imu_esp32, switch_buck5, switch_driver, us_esp32

✓

Check

Polarity check, then multimeter: 5.0 V at the buck output with the Pi unplugged

▶ Show in 3D t = 8.0 s

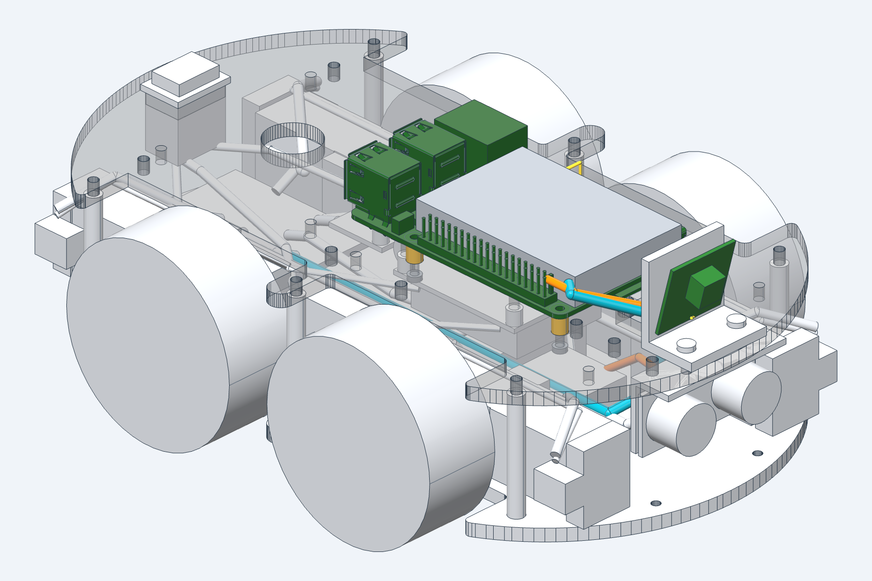
[picture p110: cad/scout-v2/assembly/step07.png]
Step 07: Pi 5 on M2.5 standoffs + Active Cooler, 5 V to GPIO, ESP32 UART, Camera Module 3 + FFC


07

### Pi 5 on M2.5 standoffs + Active Cooler, 5 V to GPIO, ESP32 UART, Camera Module 3 + FFC

Parts

- 4×M2.5 nut under the top plate (Pi standoff)
- 4×M2.5 x 6 brass hex M-F standoff
- 1×Raspberry Pi 5 8 GB
- 1×Raspberry Pi Active Cooler
- 1×Raspberry Pi Camera Module 3
- ⌁Leads: buck5_pi, camera_ffc, esp32_pi

✓

Check

Pi boots; vcgencmd get_throttled = 0x0; camera sees the floor ≤150 mm ahead; HC-SR04 does not block the camera FOV

▶ Show in 3D t = 9.6 s

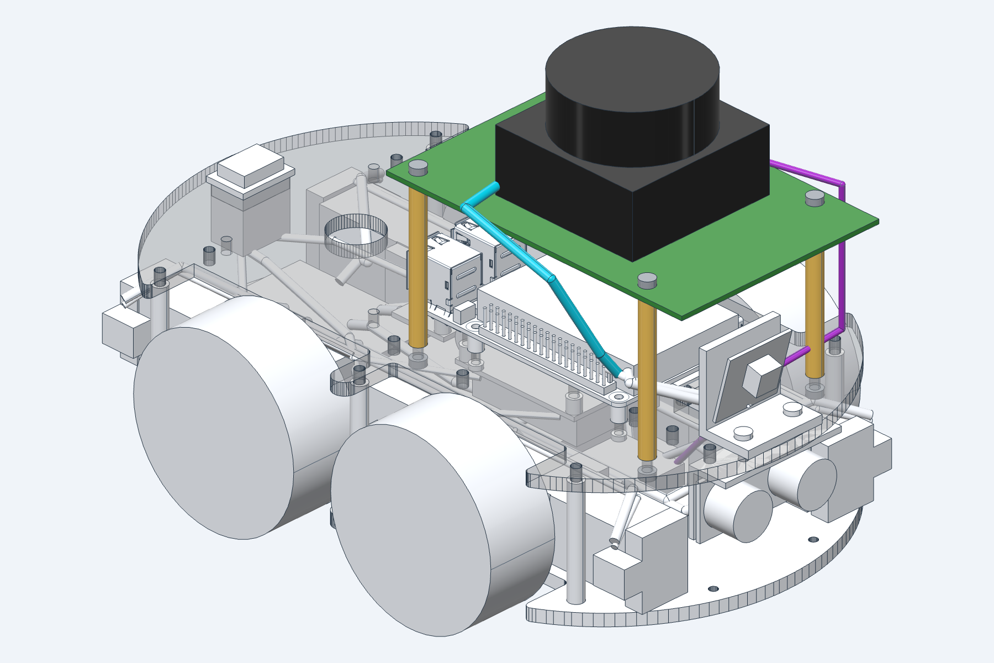
[picture p111: cad/scout-v2/assembly/step08.png]
Step 08: LiDAR tower: 4 M3 standoff legs + FR4 board, RPLIDAR C1, UART + 5 V leads


08

### LiDAR tower: 4 M3 standoff legs + FR4 board, RPLIDAR C1, UART + 5 V leads

Parts

- 4×M3 nut under the top plate (LiDAR leg)
- 4×M3 brass hex M-F standoffs, 5.5 AF, M3 nut under the plate, M3 x 6 screw on top
- 1×Electrokit ProtoPCB 80 x 120 mm (EKB12-class FR4 prototyping board)
- 4×M3 x 6 pan screw on the LiDAR board
- 4×M2.5 x 5 pan screw (LiDAR to board)
- 1×SLAMTEC RPLIDAR C1
- ⌁Leads: buck5_lidar, lidar_uart

✓

Check

Scan plane ~150 mm, ≥5 mm above every robot part; tower–cooler gap (0.75 mm in CAD) checked on the real cooler

▶ Show in 3D t = 11.2 s

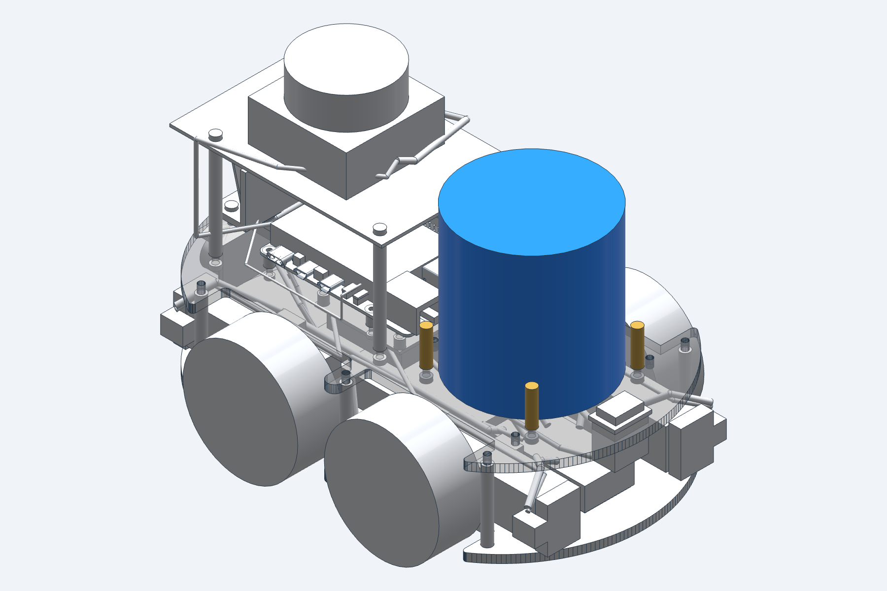
[picture p112: cad/scout-v2/assembly/step09.png]
Step 09: Payload fence: 4 M3 x 20 standoffs around the Ø75 x 80 cup keep-out (<= 300 g)


09

### Payload fence: 4 M3 x 20 standoffs around the Ø75 x 80 cup keep-out (<= 300 g)

Parts

- 4×M3 x 20 brass hex M-F standoff (payload fence)
- 4×M3 nut under the top plate (fence)
- 1×Seedling cup keep-out Ø75 x 80, <= 300 g (not bought)

✓

Check

Cup + plant within Ø75 × 80 mm (else LiDAR rear-sector shadow); 4-standoff fence holds the 300 g cup; CoM x ≥ −22 mm

▶ Show in 3D t = 12.8 s

02

## Wiring & power

Explorable diagrams (Archify) and the “how it works” figure (Anatomy). On a phone, use “open full screen”.

Power distribution Wiring Assembly sequence How it works

Battery → XT30 → 7.5 A fuse → rocker → MDD3A (470 µF) and D36V50F5 5 V buck (100 µF) → Pi 5, ESP32, C1.

Open full screen ↗

Signal and power leads: UART0 to the C1, UART2 to the ESP32, encoders, IMU, HC-SR04, camera FFC.

Open full screen ↗

The nine build steps in lanes, each with its check.

Open full screen ↗

Drivetrain and power path: how energy gets from the pack to the wheels.

Open full screen ↗

03

## Simulation

MuJoCo 3.17 runs (sim/scenarios.py, results in sim/results.json).

pass10 mm threshold at crawl (0.05 m/s) with the 300 g cup: climbs (0.056 N·m per wheel). Needs floor friction ≥ 0.4 in sim; measure M3/M4.

pass10 mm threshold at 0.3 m/s with the cup: climbs.

passEmergency stop from 0.3 m/s, brake LOW/LOW, hard floor: 0.127 s, so the firmware watchdog must be ≤ 170 ms for REQ-SCOUT-002.

passSpin in place on carpet with the gyro yaw loop: 1.00 rad/s (open loop only 0.70 rad/s).

Round-4 runs: round-3 CAD params (0.998 kg, 1.298 kg with the cup), Hiwonder 1:42 at the 8.4 V PWM cap. Floor friction is assumed until M4. Details: docs/sim-round4.md, verdict: docs/physics-final.md.

04

## Parts & drilling

Copied from docs/cad-round3.md §4, §5 and §7. Off-the-shelf parts only; nothing has been bought yet.

### Measure these first §7: open questions; they decide whether the model holds

- M5 (motor fit): Elegoo bracket hole pattern, gearbox inner-face spacing (54.4 mm assumed between gearboxes → 2.2 mm each side of the 50 mm battery), whether the Hiwonder encoder cap clears the plate with 3 mm spacers, free length behind each motor. Decides whether the Hiwonder fits as modelled.
- M1: battery mass, markings, BMS → fuse size (7.5 A assumed OK), battery mass in the CoM.
- M6: weigh plates, wheels, Pi + cooler; measure tyre width and the wheel-to-plate gap (1.57 mm in CAD).
- M7 (on arrival): D36V50F5 output at 3 A; Hiwonder encoder at 3.3 V; ppr.
- M8: only if the two-pack option (motors on the Elegoo 2S box) is taken — that would add a box to the lower deck, not modelled.
- Q-SW: a KCD1-size rocker with a published DC rating ≥ 10 A at 12–14 V (generic KCD1 = AC ratings only). If none is found, use a larger DC-rated rocker and re-place the cut-out.
- Q-C1: C1 connector position and pinout (lead assumed to exit the base's rear; 5 V from the buck, UART to GPIO14/15). Check the SLAMTEC C1 datasheet before wiring.
- Q-UART: Pi 5 UART2 on GPIO4/5 (dtoverlay=uart2-pi5) for the ESP32 and UART0 on GPIO14/15 for the C1 (disable the serial console). Confirm in the Pi docs.
- Q-MDD3A: which edge carries the VB+/VB− terminal (cap and cable ends assume the rear short edge).
- Q-holders: the exact HC-SR04 bracket and tilting camera holder to buy (dimensions assumed); the shared-screw holes (#19, #20) follow the holder bought.
- Brass standoff masses are over-estimated (solid cylinders): expect the real robot ≈ 20 g lighter than 0.998 kg (before M1/M6 corrections).

### Drilling table top plate + LiDAR board, robot frame

# | Part | Purpose | X (mm) | Y (mm) | Hole

1 | top_plate | Pi 5 M2.5 standoff | +74.0 | +24.5 | Ø2.7
2 | top_plate | Pi 5 M2.5 standoff | +74.0 | -24.5 | Ø2.7
3 | top_plate | Pi 5 M2.5 standoff | +16.0 | +24.5 | Ø2.7
4 | top_plate | Pi 5 M2.5 standoff | +16.0 | -24.5 | Ø2.7
5 | top_plate | MDD3A M3 nylon standoff | +49.6 | +18.3 | Ø3.2
6 | top_plate | MDD3A M3 nylon standoff | +49.6 | -18.3 | Ø3.2
7 | top_plate | MDD3A M3 nylon standoff | +6.4 | +18.3 | Ø3.2
8 | top_plate | MDD3A M3 nylon standoff | +6.4 | -18.3 | Ø3.2
9 | top_plate | IMU M3 nylon standoff | -16.4 | +5.6 | Ø3.2
10 | top_plate | IMU M3 nylon standoff | -16.4 | -5.6 | Ø3.2
11 | top_plate | LiDAR tower leg M3 | +95.0 | +34.0 | Ø3.2
12 | top_plate | LiDAR tower leg M3 | +95.0 | -34.0 | Ø3.2
13 | top_plate | LiDAR tower leg M3 | +2.0 | +34.0 | Ø3.2
14 | top_plate | LiDAR tower leg M3 | +2.0 | -34.0 | Ø3.2
15 | top_plate | payload fence post M3 | -20.1 | +29.9 | Ø3.2
16 | top_plate | payload fence post M3 | -20.1 | -29.9 | Ø3.2
17 | top_plate | payload fence post M3 | -79.9 | +29.9 | Ø3.2
18 | top_plate | payload fence post M3 | -79.9 | -29.9 | Ø3.2
19 | top_plate | camera holder + HC-SR04 bracket shared M3 | +110.0 | +10.0 | Ø3.2
20 | top_plate | camera holder + HC-SR04 bracket shared M3 | +110.0 | -10.0 | Ø3.2
21 | top_plate | KCD1 rocker cut-out 13 (X) x 19 (Y): 2 x Ø12 + file | -100.0 | +0.0 | 13 x 19 mm cut-out
22 | lidar_board | leg M3 through the FR4 board | +95.0 | +34.0 | Ø3.2
23 | lidar_board | leg M3 through the FR4 board | +95.0 | -34.0 | Ø3.2
24 | lidar_board | leg M3 through the FR4 board | +2.0 | +34.0 | Ø3.2
25 | lidar_board | leg M3 through the FR4 board | +2.0 | -34.0 | Ø3.2
26 | lidar_board | SLAMTEC RPLIDAR C1 M2.5 fixing | +76.5 | +21.5 | Ø2.7
27 | lidar_board | SLAMTEC RPLIDAR C1 M2.5 fixing | +76.5 | -21.5 | Ø2.7
28 | lidar_board | SLAMTEC RPLIDAR C1 M2.5 fixing | +33.5 | +21.5 | Ø2.7
29 | lidar_board | SLAMTEC RPLIDAR C1 M2.5 fixing | +33.5 | -21.5 | Ø2.7

The Elegoo plate origin: x = 0 is midway between the axles (pillar holes at x −80.7/−0.7/+84.4 are a handy reference), y = 0 is the centreline. Every hole is asserted in the model to lie inside its plate with ≥ 3 mm of material to the edge, to every existing hole and to the other new holes, and is cut in the CAD top plate. Mark from the pillar holes, centre-punch, pilot Ø1.5, then final size.

The rocker cut-out (#21) is the only non-round hole: drill 2 × Ø12 at x −100, y ±3.5, then file to 13 × 19 until the KCD1 snaps in. Alternative if filing is unwanted: a round Ø20 rocker drilled with a step drill (re-check the rating).

### Bill of materials every physical part in the model

Label(s) | Qty | Product | Source / URL | Mass each (g) | Dim./mass source
battery | 1 | Blue 3S Li-ion pack 70 x 50 x 15, 11.1 V 3000 mAh label (owned) | Jaime | 110 | measured
bottom_plate | 1 | Elegoo Smart Robot Car V4.0 bottom plate (owned) | Elegoo kit STL 'Bottom Plate.stl' | 114.5 | measured
buck_5v | 1 | Pololu D36V50F5 5 V 5.5 A step-down regulator (#4091) | www.pololu.com (https://www.pololu.com/product/4091/specs) | 7 | datasheet
camera | 1 | Raspberry Pi Camera Module 3 (owned) | datasheets.raspberrypi.com (https://datasheets.raspberrypi.com/camera/camera-module-3-standard-mechanical-drawing.pdf) | 4 | datasheet
camera_mount | 1 | generic tilt-adjustable acrylic Raspberry Pi camera holder (2-piece, hinge screw; e.g. listing 'Raspberry Pi camera module acrylic holder bracket'), locked at 15 deg down; dims assumed | generic listing | 4.9 | assumed
cap_buck | 1 | 100 uF / 25 V radial electrolytic D6.3 x 11 (buck VIN) | any (e.g. Panasonic FR series) | 0.6 | assumed
cap_driver | 1 | 470 uF / 25 V low-ESR radial electrolytic D10 x 16 (Panasonic EEU-FR1E471) | industrial.panasonic.com (https://industrial.panasonic.com/cdbs/www-data/pdf/RDF0000/ABA0000C1209.pdf) | 2 | datasheet
deck_pillar_1..6 | 6 | Elegoo kit M3 brass hex pillar, 39.7 mm between the decks (owned) | Elegoo V4.0 kit | 8 | measured
esp32 | 1 | ESP32 DevKit WROOM-32 USB-C (owned) | - | 10 | assumed
fence_nut_1..4 | 4 | M3 nut under the top plate (fence) | ISO 4032 | 0.5 | datasheet
fence_post_1..4 | 4 | M3 x 20 brass hex M-F standoff (payload fence) | RS PRO 222-452 family | 4 | datasheet
front_screw_1..2 | 2 | M3 x 12 pan screw + M3 nut (camera holder + HC-SR04 bracket, shared) | ISO 7045 / ISO 4032 | 1.3 | datasheet
fuse_holder | 1 | Inline ATM mini-blade fuse holder (18 AWG) + 7.5 A ATM fuse | any automotive supplier | 5 | assumed
imu | 1 | GY-521 MPU-6050 breakout (owned) | - | 2 | assumed
imu_standoff_1..2 | 2 | M3 x 10 nylon hex F-F standoff + M3 x 6 nylon screws | nylon standoff kit | 0.2 | datasheet
lidar | 1 | SLAMTEC RPLIDAR C1 | www.slamtec.com (https://www.slamtec.com/en/C1) (datasheet v1.0 fig 4-1) | 110 | datasheet
lidar_board | 1 | Electrokit ProtoPCB 80 x 120 mm (EKB12-class FR4 prototyping board) | www.electrokit.com (https://www.electrokit.com/en/experimentkort-1-hal-80x120mm-genomplaterade-hal) | 28.3 | datasheet
lidar_board_screw_1..4 | 4 | M3 x 6 pan screw on the LiDAR board | ISO 7045 | 0.5 | datasheet
lidar_leg_1..4 | 4 | M3 brass hex M-F standoffs, 5.5 AF (e.g. RS PRO 222-452 family / Wurth 971xxx), M3 nut under the plate, M3 x 6 screw on top | RS PRO 222-452 family | 11.1 | datasheet
lidar_leg_screw_1..4 | 4 | M3 nut under the top plate (LiDAR leg) | ISO 4032 | 0.5 | datasheet
lidar_screw_1..4 | 4 | M2.5 x 5 pan screw (LiDAR to board) | ISO 7045 | 0.2 | datasheet
mdd3a | 1 | Cytron MDD3A 4-16 V 3 A dual DC motor driver | www.cytron.io (https://www.cytron.io/p-3amp-4v-16v-dc-motor-driver-2-channels) | 14.5 | datasheet
mdd3a_standoff_1..4 | 4 | M3 x 5 nylon hex F-F standoff + M3 x 6 nylon screws | nylon standoff kit | 0.1 | datasheet
motor_bracket_fl, motor_bracket_fr, motor_bracket_rl, motor_bracket_rr | 4 | Elegoo kit TT motor holder (owned) | Elegoo V4.0 kit | 1.4 | assumed
motor_fl, motor_fr, motor_rl, motor_rr | 4 | Hiwonder TT Hall-encoder gear motor 1:42, plastic shaft (SKU 21100132) | www.hiwonder.com (https://www.hiwonder.com/products/tt-motor-plastic) | 34 | datasheet
motor_spacer_fl, motor_spacer_fr, motor_spacer_rl, motor_spacer_rr | 4 | M3 nylon round spacer 3 mm (2 per bracket) | Essentra/Keystone M3 nylon spacer kit | 0.2 | datasheet
payload | 1 | Seedling cup keep-out Ø75 x 80, <= 300 g (not bought) | BRIEF | 300 | assumed
pi5 | 1 | Raspberry Pi 5 8 GB (owned) | vendor/raspberry_pi_5.step | 46 | datasheet
pi5_cooler | 1 | Raspberry Pi Active Cooler (owned) | RP-008187-DS-1 mechanical drawing | 25 | datasheet
pi_screw_1..4 | 4 | M2.5 nut under the top plate (Pi standoff) | ISO 4032 | 0.2 | datasheet
pi_standoff_1..4 | 4 | M2.5 x 6 brass hex M-F standoff | M2.5 brass standoff kit | 1 | datasheet
switch | 1 | KCD1-form-factor SPST rocker, >= 10 A @ 12 VDC rated (DC rating to confirm on the listing) | probots.co.in (https://probots.co.in/kcd1-spdt-momentary-rocker-switch-3-pin-motor-control.html) (envelope) | 8 | datasheet
top_plate | 1 | Elegoo Smart Robot Car V4.0 top plate (owned), drilled per the drilling table | Elegoo kit STL 'Top Plate.stl' | 110.8 | measured
ultrasonic | 1 | HC-SR04 ultrasonic sensor (owned) | www.mouser.com (https://www.mouser.com/datasheet/2/813/HCSR04-1022824.pdf) | 8.5 | datasheet
ultrasonic_bracket | 1 | generic HC-SR04 L-mount bracket (acrylic/ABS, 2 x M3 base holes), e.g. listing 'HC-SR04 ultrasonic sensor mounting bracket'; dims assumed | generic listing | 3.6 | assumed
wheel_fl, wheel_fr, wheel_rl, wheel_rr | 4 | Elegoo kit 65 mm wheel (owned) | Elegoo V4.0 kit | 25 | datasheet
xt30 | 1 | AMASS XT30U-M/F pair | www.amass.com.cn | 3 | datasheet

### Cables

Routes, gauges and lengths (+15 % slack)

Route | Kind | Path (mm) | +15 % (mm) | Cable
cable_batt_xt30 | 18awg | 14.8 | 17.0 | battery pack lead (as supplied) + XT30U-M, 18 AWG silicone
cable_xt30_fuse | 18awg | 94.0 | 108.1 | XT30U-F pigtail 18 AWG into the inline ATM holder's lead (solder + heat-shrink)
cable_fuse_switch | 18awg | 97.2 | 111.7 | 18 AWG silicone, 6.3 mm insulated female QC on the rocker's input terminal
cable_switch_driver | 20awg | 106.2 | 122.1 | 20 AWG silicone pair (+ GND return) from the rocker output QC to the MDD3A VB+/VB- terminal; 470 uF/25 V soldered across VB+/VB- at the terminal
cable_switch_buck5 | 20awg | 159.4 | 183.3 | 20 AWG silicone pair to the D36V50F5 VIN/GND (both 20 AWG wires crimped together in the rocker's output QC = the split); 100 uF/25 V across VIN
cable_buck5_pi | 20awg | 113.2 | 130.1 | 20 AWG pair, 2.54 mm Dupont housings on GPIO pins 2/4 (+5 V) and 6/14 (GND), <= 15 cm
cable_5v_esp32 | 22awg | 108.3 | 124.6 | 22 AWG pair from the D36V50F5 VOUT to the ESP32 VIN/GND (also feeds encoders + HC-SR04)
cable_buck5_lidar | 22awg | 234.1 | 269.2 | 22 AWG pair from the D36V50F5 VOUT through the top-plate front slot to the C1 lead's VCC/GND
cable_lidar_uart | signal | 121.3 | 139.5 | C1 XH2.54-5P lead: TX/RX/GND as F Dupont to Pi GPIO 14/15 (pins 8/10, UART0) + GND pin 9
cable_driver_esp32 | signal | 66.5 | 76.5 | 5 x F-F Dupont jumpers (M1A/M1B/M2A/M2B PWM + GND)
cable_imu_esp32 | signal | 26.1 | 30.0 | 4 x F-F Dupont jumpers (VCC 3.3 V, GND, SDA, SCL)
cable_us_esp32 | signal | 174.8 | 201.0 | 4 x F-F Dupont jumpers 20-30 cm (VCC, TRIG, ECHO via 1k/2k divider, GND)
cable_esp32_pi | signal | 218.4 | 251.1 | 3 x F-F Dupont jumpers 30 cm (TX, RX, GND) to Pi GPIO4/5 (pins 7/29, UART2, dtoverlay=uart2-pi5)
cable_camera_ffc | ffc | 121.0 | 139.2 | Raspberry Pi 5 camera cable, 22-pin 'standard-mini' (official 200 mm)
cable_driver_motor_fl | 22awg | 118.4 | 136.2 | 22 AWG pair from the MDD3A outputs to each motor (encoder motors: the motor pins of the 6-pin lead)
cable_enc_fl | signal | 174.7 | 200.9 | motor's own 6-pin lead (PH2.0 / XH) + Dupont breakout to the ESP32 (A, B, VCC 3.3 V, GND)
cable_driver_motor_fr | 22awg | 118.4 | 136.2 | 22 AWG pair from the MDD3A outputs to each motor (encoder motors: the motor pins of the 6-pin lead)
cable_enc_fr | signal | 174.7 | 200.9 | motor's own 6-pin lead (PH2.0 / XH) + Dupont breakout to the ESP32 (A, B, VCC 3.3 V, GND)
cable_driver_motor_rl | 22awg | 128.3 | 147.5 | 22 AWG pair from the MDD3A outputs to each motor (encoder motors: the motor pins of the 6-pin lead)
cable_enc_rl | signal | 60.7 | 69.8 | motor's own 6-pin lead (PH2.0 / XH) + Dupont breakout to the ESP32 (A, B, VCC 3.3 V, GND)
cable_driver_motor_rr | 22awg | 128.3 | 147.5 | 22 AWG pair from the MDD3A outputs to each motor (encoder motors: the motor pins of the 6-pin lead)
cable_enc_rr | signal | 60.7 | 69.8 | motor's own 6-pin lead (PH2.0 / XH) + Dupont breakout to the ESP32 (A, B, VCC 3.3 V, GND)

05

## Which file for what

Everything lives in cad/scout-v2/. src/exports.py regenerates all of it (cadgen +0.8.4 run src/exports.py).

#### GLB

Web and phone: this page, quick looks.

out/GLB/scout_v2.glb (+ _assembly, _exploded). Mac: Quick Look (space bar) or Preview. iPhone: open from Files or AirDrop it. Also gltf-viewer.donmccurdy.com (drag and drop).

#### STEP

CAD software: exact solids for measuring and editing.

out/STEP/scout_v2.step (AP242, git-ignored). Open in Fusion 360, Onshape (import), SolidWorks or FreeCAD.

#### STL / 3MF

Meshes: slicers, mesh tools, renders.

out/STL/scout_v2.stl, one STL per part in out/STL/parts/, out/3MF/scout_v2.3mf. Open in PrusaSlicer, Bambu Studio, Blender or Preview. (Nothing is printed: off-the-shelf parts only.)

#### robot_params.json

Simulation and URDF/MJCF: masses, frames, sensor poses.

out/robot_params.json (v2-r3, REP-103, metres). Read by sim/gen_mjcf.py and the URDF generator; any text editor.

#### PNG / MP4 / HTML

Pictures, sim videos, diagrams.

assembly/, shots/, sim/videos/, docs/diagrams/, docs/figures/. Any browser or image viewer.

#### guide/

This page.

Double-click guide/index.html. On a phone, serve the folder: cd cad/scout-v2 && python3 -m http.server 8000, then open http://<mac-ip>:8000/guide/. After re-exporting the GLBs, run python3 -I guide/vendor/make_glb_js.py.

Frame: REP-103 base_footprint, +X forward, +Y left, +Z up; mm in CAD. 3D viewer: model-viewer 4.4.0 (Apache-2.0), bundled in guide/vendor/, no network needed.
