mattyjayt/terra-hawk-scout/cad/scout-v2/docs/diagrams/scout-assembly-sequence/scout-assembly-sequence.html

Dark

Style

Visual identitySto cycle

ClassicStable technical default Signal FlowMotion-forward presentation BlueprintEngineering review EditorialPublication and launch notes

Live Present

Export

Export diagramPortable, clean outputs

E

Share Route Share Card1200×630 PNG Reach Share Card1200×630 PNG Copy diagramPNG to clipboard

Image PNGLossless image JPEGCompact image WebPModern image

Vector & motion SVG · AutoMatches host theme SVG · LightAlways light SVG · DarkAlways dark WebM6s motion

# Scout v2 — mechanical assembly sequence with checks

Diagram guide Explore this system ×

Inspecting compiled semantics

01 Find any nodeSearch labels, responsibilities, kinds, and stable IDs. / 02 Trace a routeAsk how two semantic nodes connect in authored direction. R 03 See the whole systemOpen Semantic Radar with a live viewport and stable nodes. M 04 Compare semantic kindsCount roles, reveal their traffic, and compare direct authored links. L 05 Enter Presentation StageGive the live diagram the viewport without changing export. F

E ExportT ThemeS Style0 Reset+ Zoom in- Zoom outEsc Close

Find Archify useful? A star on GitHub helpsStar ↗ (https://github.com/tt-a1i/archify)

Find a node ×

⌕ /

No matching nodes

Semantic passport

Verified source

Authored reach

Upstream0 Downstream0

× Copy link Relations

Path Click where the path starts Find start Copy link Clear

Click two nodes on the diagram

← ▶ Journey → Overview

Click a start, then an end. Paths follow the arrows.

Semantic lens Compare system roles ×

Choose up to two semantic kinds. One reveals its real traffic; two compare only direct authored relationships.

Choose a kind to inspect its nodes and touching relationships.

Copy link Clear

Semantic radar Building overview Open radar ×

Click nodeDrag to pan

Semantic radar needs more MAP space.

Notes & index

ROUTE MAP LENS 100%

### Steps (off-the-shelf parts only)

- 01 Bottom plate + motor brackets + 4 Hiwonder encoder motors + wheels
- 02 Lower-deck power: battery on the centre of rotation, XT30, fuse holder, 5 V buck
- 03 ESP32 at the rear of the lower deck · 04 deck pillars
- 05 Top-plate bench pre-fit: MDD3A on nylon standoffs underneath, IMU near the CoR, switch
- 06 Top plate on + wiring · 07 Pi 5 + Active Cooler on standoffs, Camera Module 3 at the front tilted 15° down, HC-SR04 under the front edge
- 08 LiDAR tower (M2.5 standoffs + plate) with RPLIDAR C1, scan plane ~150 mm · 09 payload cup Ø75 × 80 mm with 4-standoff fence at x = −50 mm

### Checks, steps 01–04

- 01 Wheels spin free; 1 mm nylon washer behind a wheel if it rubs (wheel–plate gap 1.57 mm)
- 02 Battery centred on the centre of rotation; XT30 polarity checked before the fuse goes in; ≥2.2 mm side clearance
- 03 ESP32 at the rear clears the encoder connectors and the XT30/fuse
- 04 Pillars square, no wire pinched under the top plate (assumed check)

### Checks, steps 05–07

- 05 Bench pre-fit before mounting: MDD3A on nylon standoffs underneath, IMU within 25 mm of the CoR (x ≈ −25 mm), ≥10 A DC switch cut-out drilled
- 06 Polarity check, then multimeter: 5.0 V at the buck output with the Pi unplugged
- 07 Pi boots; vcgencmd get_throttled = 0x0; camera sees the floor ≤150 mm ahead; HC-SR04 does not block the camera FOV

### Checks, steps 08–09

- 08 Scan plane ~150 mm, ≥5 mm above every robot part; tower–cooler gap (0.75 mm in CAD) checked on the real cooler
- 09 Cup + plant within Ø75 × 80 mm (else LiDAR rear-sector shadow); 4-standoff fence holds the 300 g cup; CoM x ≥ −22 mm
