mattyjayt/terra-hawk-scout/cad/scout-v2/docs/diagrams/scout-wiring/scout-wiring.html

Dark

Style

Visual identitySto cycle

ClassicStable technical default Signal FlowMotion-forward presentation BlueprintEngineering review EditorialPublication and launch notes

Live Present

Export

Export diagramPortable, clean outputs

E

Share Route Share Card1200×630 PNG Reach Share Card1200×630 PNG Copy diagramPNG to clipboard

Image PNGLossless image JPEGCompact image WebPModern image

Vector & motion SVG · AutoMatches host theme SVG · LightAlways light SVG · DarkAlways dark WebM6s motion

# Scout v2 — electrical interfaces and signals

Diagram guide Explore this system ×

Inspecting compiled semantics

01 Find any nodeSearch labels, responsibilities, kinds, and stable IDs. / 02 Trace a routeAsk how two semantic nodes connect in authored direction. R 03 See the whole systemOpen Semantic Radar with a live viewport and stable nodes. M 04 Compare semantic kindsCount roles, reveal their traffic, and compare direct authored links. L 05 Enter Presentation StageGive the live diagram the viewport without changing export. F

E ExportT ThemeS Style0 Reset+ Zoom in- Zoom outEsc Close

Find Archify useful? A star on GitHub helpsStar ↗ (https://github.com/tt-a1i/archify)

Find a node ×

⌕ /

No matching nodes

Semantic passport

Verified source

Authored reach

Upstream0 Downstream0

× Copy link Relations

Path Click where the path starts Find start Copy link Clear

Click two nodes on the diagram

← ▶ Journey → Overview

Click a start, then an end. Paths follow the arrows.

Semantic lens Compare system roles ×

Choose up to two semantic kinds. One reveals its real traffic; two compare only direct authored relationships.

Choose a kind to inspect its nodes and touching relationships.

Copy link Clear

Semantic radar Building overview Open radar ×

Click nodeDrag to pan

Semantic radar needs more MAP space.

Notes & index

ROUTE MAP LENS 100%

### Pi 5 links

- ESP32 and RPLIDAR C1 each on their own Pi UART: no USB plugs, avoids the 600 mA no-PD USB limit
- C1: UART TX+RX 460800 baud, 3.3 V logic, 4.8–5.2 V supply (XH2.54-5P lead)
- Camera Module 3 on CSI via 22-pin mini FFC

### ESP32 real-time I/O

- MDD3A: 4 PWM/DIR lines; watchdog drives all inputs LOW/LOW (brake, 0.16–0.19 s)
- PWM pins boot LOW; duty cap lives in the lowest PWM-write function
- 4 encoders × A/B counted by PCNT (no GPIO ISRs); edge timing below 0.1 m/s
- 18 of 19 safe ESP32 pins used with the MDD3A

### Logic levels

- HC-SR04 ECHO is 5 V → 1 k / 2 k divider to 3.3 V; TRIG direct
- MPU-6050 on ESP32 3V3 with pull-ups
- Hiwonder encoder at 3.3 V unpublished: check on arrival, else dividers

### Not specified in the review

- Which Pi UART (UART0/2/3…) and which ESP32 GPIO numbers are used
- Pi 5 ↔ ESP32 baud rate
