mattyjayt/terra-hawk-scout/cad/scout-v2/docs/diagrams/scout-assembly-sequence/scout-assembly-sequence.png

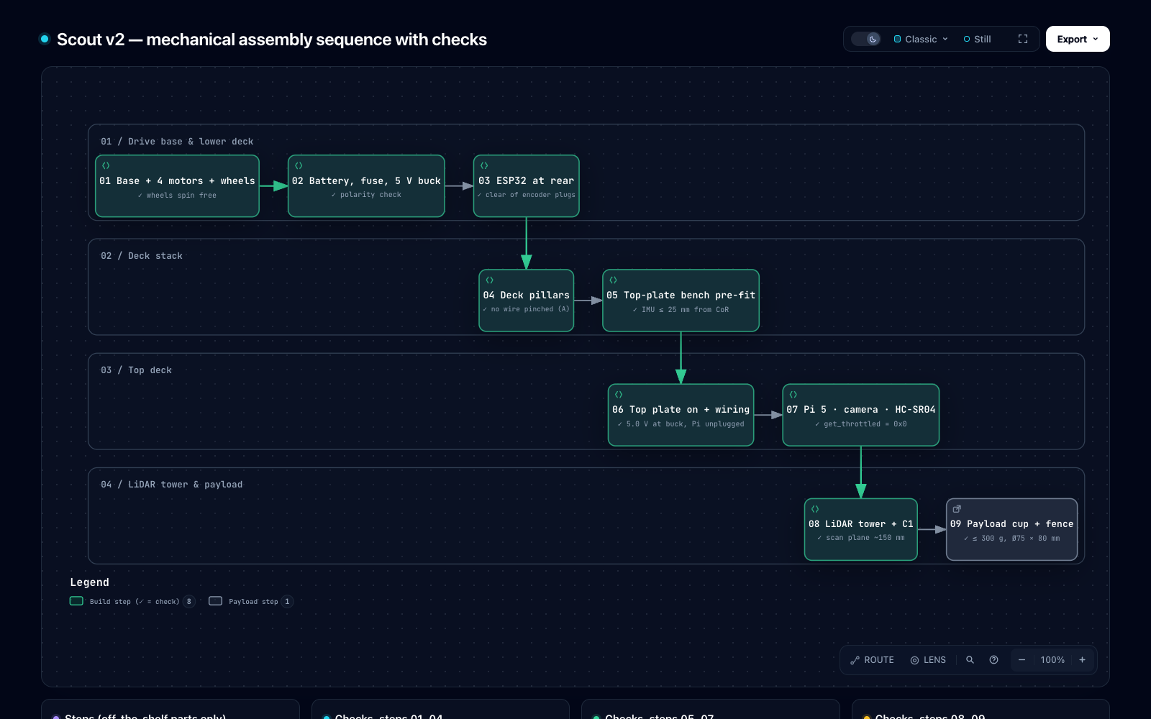
cad/scout-v2/docs/diagrams/scout-assembly-sequence/scout-assembly-sequence.png
