mattyjayt/terra-hawk-scout/cad/scout-v2/docs/diagrams/scout-wiring/scout-wiring.png

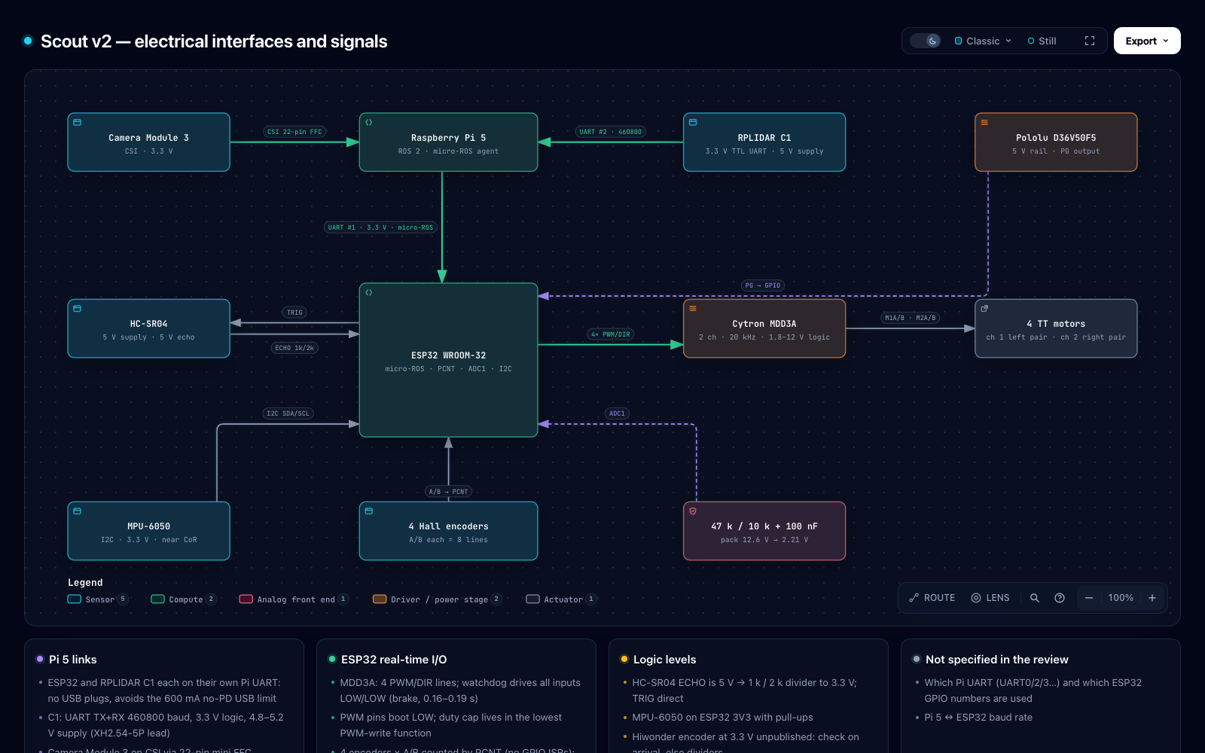
cad/scout-v2/docs/diagrams/scout-wiring/scout-wiring.png
