mattyjayt/terra-hawk-scout/cad/scout-v2/urdf/scout.urdf

<?xml version="1.0"?>
<!--
  TerraHawk Scout v2 robot description - GENERATED by urdf/gen_description.py, do not hand-edit.
  Params: out/robot_params.json  (version v2-r3)

  DESIGN LEDGER
  - Frames: REP-103. base_footprint = ground plane at the centre of rotation (midpoint of the
    front and rear axles, on the centreline). +X forward (Elegoo servo / Dead Plate end), +Y left, +Z up.
  - Units: metres, kilograms, radians. Params file is already in this frame (no transform).
  - base_link: fixed above base_footprint at mean axle height z=0.0325 m. Its inertial lumps every
    rigid chassis part in the params file (100 links, 0.898 kg, parallel-axis theorem in sim/scout_params.py).
  - Wheels: 4 continuous joints wheel_<fl|fr|rl|rr>_joint, axis +Y on every wheel, so a positive
    joint velocity rolls the robot forward on BOTH sides (no mirrored sign). Radius 0.0325 m,
    width 0.026 m, track 0.124 m, wheelbase 0.08 m.
    Wheel visual/collision cylinder is rotated rpy=(pi/2,0,0) so its axis lies along the joint axis.
  - Limits: effort = stall torque 0.1648 N m, velocity = no-load 22.56 rad/s:
    Hiwonder TT Hall-encoder 1:42 at the 8.4 V PWM average-voltage cap (sim/motor_profiles.json hiwonder_1_42_8v4;
    listing values, unverified - bench-test on arrival).
  - Sensors (fixed joints from base_link): laser_link at the scan plane (z=0.148905 above ground),
    camera_link (X forward body convention, pitched 15 deg down = rpy 0 +0.2618 0) + camera_optical_link (REP-103
    optical: z forward, x right, y down; rpy = -pi/2 0 -pi/2), imu_link (MPU-6050 die, GY-521 hung chip-down: roll pi),
    ultrasonic_link (X = sensing direction). RPLIDAR C1 native angles are clockwise; sllidar_ros2 converts.
  - Payload: the CAD keep-out cylinder (D75 x 80 mm, 300 g) at x = -50 mm; xacro arg payload:=true, and the expanded
    scout_payload.urdf.
  - Collision: boxes from each params link bbox (plates, motors, boards, LiDAR), cylinders for wheels. Cable routes
    (cable_*) are in the inertial lump only.
  - Assumptions: see the params file's mass_source fields (measured / datasheet / assumed / cad-volume x density).
-->
<robot name="scout">
  <material name="plate"><color rgba="0.85 0.85 0.85 1"/></material>
  <material name="motor"><color rgba="0.89 0.75 0.27 1"/></material>
  <material name="battery"><color rgba="0.23 0.48 0.84 1"/></material>
  <material name="lidar"><color rgba="0.13 0.16 0.19 1"/></material>
  <material name="pi5"><color rgba="0.12 0.44 0.26 1"/></material>
  <material name="default"><color rgba="0.55 0.35 0.68 1"/></material>
  <material name="rubber"><color rgba="0.1 0.1 0.1 1"/></material>
  <link name="base_footprint"/>
  <joint name="base_footprint_joint" type="fixed">
    <origin xyz="0 0 0.0325" rpy="0 0 0"/>
    <parent link="base_footprint"/>
    <child link="base_link"/>
  </joint>
  <link name="base_link">
    <inertial>
      <origin xyz="0.0153803 2.35581e-07 0.0249681" rpy="0 0 0"/>
      <mass value="0.898108"/>
      <inertia ixx="0.00211262" ixy="-5.90936e-07" ixz="-0.00068217" iyy="0.0044873" iyz="-2.23639e-06" izz="0.00381432"/>
    </inertial>
    <visual name="battery">
      <origin xyz="0 0 -0.0067" rpy="0 0 0"/>
      <geometry><box size="0.07 0.05 0.015"/></geometry>
      <material name="battery"/>
    </visual>
    <visual name="bottom_plate">
      <origin xyz="0.002005 -2.5e-06 -0.01645" rpy="0 0 0"/>
      <geometry><box size="0.23078 0.132523 0.0045"/></geometry>
      <material name="plate"/>
    </visual>
    <visual name="buck_5v">
      <origin xyz="0.0507 0 -0.0089" rpy="0 0 0"/>
      <geometry><box size="0.0254 0.0254 0.0106"/></geometry>
      <material name="default"/>
    </visual>
    <visual name="camera">
      <origin xyz="0.105785 0 0.0463845" rpy="0 0 0"/>
      <geometry><box size="0.011569 0.025 0.023339"/></geometry>
      <material name="default"/>
    </visual>
    <visual name="camera_mount">
      <origin xyz="0.107 0 0.044505" rpy="0 0 0"/>
      <geometry><box size="0.02 0.03 0.029"/></geometry>
      <material name="default"/>
    </visual>
    <visual name="cap_buck">
      <origin xyz="0.045 -0.01995 -0.01105" rpy="0 0 0"/>
      <geometry><box size="0.011 0.0063 0.0063"/></geometry>
      <material name="default"/>
    </visual>
    <visual name="cap_driver">
      <origin xyz="-0.004 0 0.017505" rpy="0 0 0"/>
      <geometry><box size="0.01 0.016 0.01"/></geometry>
      <material name="default"/>
    </visual>
    <visual name="deck_pillar_1">
      <origin xyz="-0.0807 -0.0561 0.0056525" rpy="0 0 0"/>
      <geometry><box size="0.0055 0.0055 0.039705"/></geometry>
      <material name="default"/>
    </visual>
    <visual name="deck_pillar_2">
      <origin xyz="-0.0807 0.0559 0.0056525" rpy="0 0 0"/>
      <geometry><box size="0.0055 0.0055 0.039705"/></geometry>
      <material name="default"/>
    </visual>
    <visual name="deck_pillar_3">
      <origin xyz="-0.0007 0.0559 0.0056525" rpy="0 0 0"/>
      <geometry><box size="0.0055 0.0055 0.039705"/></geometry>
      <material name="default"/>
    </visual>
    <visual name="deck_pillar_4">
      <origin xyz="0.0003 -0.0561 0.0056525" rpy="0 0 0"/>
      <geometry><box size="0.0055 0.0055 0.039705"/></geometry>
      <material name="default"/>
    </visual>
    <visual name="deck_pillar_5">
      <origin xyz="0.0844 -0.0523 0.0056525" rpy="0 0 0"/>
      <geometry><box size="0.0055 0.0055 0.039705"/></geometry>
      <material name="default"/>
    </visual>
    <visual name="deck_pillar_6">
      <origin xyz="0.0844 0.0527 0.0056525" rpy="0 0 0"/>
      <geometry><box size="0.0055 0.0055 0.039705"/></geometry>
      <material name="default"/>
    </visual>
    <visual name="esp32">
      <origin xyz="-0.0665 0 -0.00715" rpy="0 0 0"/>
      <geometry><box size="0.055 0.028 0.0141"/></geometry>
      <material name="default"/>
    </visual>
    <visual name="fence_nut_1">
      <origin xyz="-0.020125 0.029875 0.024305" rpy="0 0 0"/>
      <geometry><box size="0.0055 0.0055 0.0024"/></geometry>
      <material name="default"/>
    </visual>
    <visual name="fence_nut_2">
      <origin xyz="-0.020125 -0.029875 0.024305" rpy="0 0 0"/>
      <geometry><box size="0.0055 0.0055 0.0024"/></geometry>
      <material name="default"/>
    </visual>
    <visual name="fence_nut_3">
      <origin xyz="-0.079875 0.029875 0.024305" rpy="0 0 0"/>
      <geometry><box size="0.0055 0.0055 0.0024"/></geometry>
      <material name="default"/>
    </visual>
    <visual name="fence_nut_4">
      <origin xyz="-0.079875 -0.029875 0.024305" rpy="0 0 0"/>
      <geometry><box size="0.0055 0.0055 0.0024"/></geometry>
      <material name="default"/>
    </visual>
    <visual name="fence_post_1">
      <origin xyz="-0.020125 0.029875 0.040005" rpy="0 0 0"/>
      <geometry><box size="0.0055 0.0055 0.02"/></geometry>
      <material name="default"/>
    </visual>
    <visual name="fence_post_2">
      <origin xyz="-0.020125 -0.029875 0.040005" rpy="0 0 0"/>
      <geometry><box size="0.0055 0.0055 0.02"/></geometry>
      <material name="default"/>
    </visual>
    <visual name="fence_post_3">
      <origin xyz="-0.079875 0.029875 0.040005" rpy="0 0 0"/>
      <geometry><box size="0.0055 0.0055 0.02"/></geometry>
      <material name="default"/>
    </visual>
    <visual name="fence_post_4">
      <origin xyz="-0.079875 -0.029875 0.040005" rpy="0 0 0"/>
      <geometry><box size="0.0055 0.0055 0.02"/></geometry>
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
    <visual name="lidar_screw_2">
      <origin xyz="0.0765 -0.0215 0.084155" rpy="0 0 0"/>
      <geometry><box size="0.0045 0.0045 0.0017"/></geometry>
      <material name="lidar"/>
    </visual>
    <visual name="lidar_screw_3">
      <origin xyz="0.0335 0.0215 0.084155" rpy="0 0 0"/>
      <geometry><box size="0.0045 0.0045 0.0017"/></geometry>
      <material name="lidar"/>
    </visual>
    <visual name="lidar_screw_4">
      <origin xyz="0.0335 -0.0215 0.084155" rpy="0 0 0"/>
      <geometry><box size="0.0045 0.0045 0.0017"/></geometry>
      <material name="lidar"/>
    </visual>
    <visual name="mdd3a">
      <origin xyz="0.028 0 0.014205" rpy="0 0 0"/>
      <geometry><box size="0.04826 0.04166 0.0126"/></geometry>
      <material name="default"/>
    </visual>
    <visual name="mdd3a_standoff_1">
      <origin xyz="0.04959 0.01829 0.023005" rpy="0 0 0"/>
      <geometry><box size="0.005 0.005 0.005"/></geometry>
      <material name="default"/>
    </visual>
    <visual name="mdd3a_standoff_2">
      <origin xyz="0.04959 -0.01829 0.023005" rpy="0 0 0"/>
      <geometry><box size="0.005 0.005 0.005"/></geometry>
      <material name="default"/>
    </visual>
    <visual name="mdd3a_standoff_3">
      <origin xyz="0.00641 0.01829 0.023005" rpy="0 0 0"/>
      <geometry><box size="0.005 0.005 0.005"/></geometry>
      <material name="default"/>
    </visual>
    <visual name="mdd3a_standoff_4">
      <origin xyz="0.00641 -0.01829 0.023005" rpy="0 0 0"/>
      <geometry><box size="0.005 0.005 0.005"/></geometry>
      <material name="default"/>
    </visual>
    <visual name="motor_bracket_fl">
      <origin xyz="0.0616 0.0247 -0.0002" rpy="0 0 0"/>
      <geometry><box size="0.012 0.005 0.022"/></geometry>
      <material name="motor"/>
    </visual>
    <visual name="motor_bracket_fr">
      <origin xyz="0.0616 -0.0247 -0.0002" rpy="0 0 0"/>
      <geometry><box size="0.012 0.005 0.022"/></geometry>
      <material name="motor"/>
    </visual>
    <visual name="motor_bracket_rl">
      <origin xyz="-0.0616 0.0247 -0.0002" rpy="0 0 0"/>
      <geometry><box size="0.012 0.005 0.022"/></geometry>
      <material name="motor"/>
    </visual>
    <visual name="motor_bracket_rr">
      <origin xyz="-0.0616 -0.0247 -0.0002" rpy="0 0 0"/>
      <geometry><box size="0.012 0.005 0.022"/></geometry>
      <material name="motor"/>
    </visual>
    <visual name="motor_fl">
      <origin xyz="0.065925 0.0405625 0" rpy="0 0 0"/>
      <geometry><box size="0.07995 0.027375 0.0252"/></geometry>
      <material name="motor"/>
    </visual>
    <visual name="motor_fr">
      <origin xyz="0.065925 -0.0405625 0" rpy="0 0 0"/>
      <geometry><box size="0.07995 0.027375 0.0252"/></geometry>
      <material name="motor"/>
    </visual>
    <visual name="motor_rl">
      <origin xyz="-0.065925 0.0405625 0" rpy="0 0 0"/>
      <geometry><box size="0.07995 0.027375 0.0252"/></geometry>
      <material name="motor"/>
    </visual>
    <visual name="motor_rr">
      <origin xyz="-0.065925 -0.0405625 0" rpy="0 0 0"/>
      <geometry><box size="0.07995 0.027375 0.0252"/></geometry>
      <material name="motor"/>
    </visual>
    <visual name="motor_spacer_fl">
      <origin xyz="0.0616 0.0255 -0.0127" rpy="0 0 0"/>
      <geometry><box size="0.0138 0.006 0.003"/></geometry>
      <material name="motor"/>
    </visual>
    <visual name="motor_spacer_fr">
      <origin xyz="0.0616 -0.0255 -0.0127" rpy="0 0 0"/>
      <geometry><box size="0.0138 0.006 0.003"/></geometry>
      <material name="motor"/>
    </visual>
    <visual name="motor_spacer_rl">
      <origin xyz="-0.0616 0.0255 -0.0127" rpy="0 0 0"/>
      <geometry><box size="0.0138 0.006 0.003"/></geometry>
      <material name="motor"/>
    </visual>
    <visual name="motor_spacer_rr">
      <origin xyz="-0.0616 -0.0255 -0.0127" rpy="0 0 0"/>
      <geometry><box size="0.0138 0.006 0.003"/></geometry>
      <material name="motor"/>
    </visual>
    <visual name="pi5">
      <origin xyz="0.0342 0.0008315 0.04396" rpy="0 0 0"/>
      <geometry><box size="0.09 0.057663 0.01979"/></geometry>
      <material name="pi5"/>
    </visual>
    <visual name="pi5_cooler">
      <origin xyz="0.045 0 0.042405" rpy="0 0 0"/>
      <geometry><box size="0.0635 0.0425 0.01"/></geometry>
      <material name="pi5"/>
    </visual>
    <visual name="pi_screw_1">
      <origin xyz="0.074 0.0245 0.024655" rpy="0 0 0"/>
      <geometry><box size="0.0045 0.0045 0.0017"/></geometry>
      <material name="default"/>
    </visual>
    <visual name="pi_screw_2">
      <origin xyz="0.074 -0.0245 0.024655" rpy="0 0 0"/>
      <geometry><box size="0.0045 0.0045 0.0017"/></geometry>
      <material name="default"/>
    </visual>
    <visual name="pi_screw_3">
      <origin xyz="0.016 0.0245 0.024655" rpy="0 0 0"/>
      <geometry><box size="0.0045 0.0045 0.0017"/></geometry>
      <material name="default"/>
    </visual>
    <visual name="pi_screw_4">
      <origin xyz="0.016 -0.0245 0.024655" rpy="0 0 0"/>
      <geometry><box size="0.0045 0.0045 0.0017"/></geometry>
      <material name="default"/>
    </visual>
    <visual name="pi_standoff_1">
      <origin xyz="0.074 0.0245 0.033005" rpy="0 0 0"/>
      <geometry><box size="0.005 0.005 0.006"/></geometry>
      <material name="default"/>
    </visual>
    <visual name="pi_standoff_2">
      <origin xyz="0.074 -0.0245 0.033005" rpy="0 0 0"/>
      <geometry><box size="0.005 0.005 0.006"/></geometry>
      <material name="default"/>
    </visual>
    <visual name="pi_standoff_3">
      <origin xyz="0.016 0.0245 0.033005" rpy="0 0 0"/>
      <geometry><box size="0.005 0.005 0.006"/></geometry>
      <material name="default"/>
    </visual>
    <visual name="pi_standoff_4">
      <origin xyz="0.016 -0.0245 0.033005" rpy="0 0 0"/>
      <geometry><box size="0.005 0.005 0.006"/></geometry>
      <material name="default"/>
    </visual>
    <visual name="switch">
      <origin xyz="-0.1 0 0.023255" rpy="0 0 0"/>
      <geometry><box size="0.015 0.021 0.0255"/></geometry>
      <material name="default"/>
    </visual>
    <visual name="top_plate">
      <origin xyz="0.0020045 -2.5e-06 0.027755" rpy="0 0 0"/>
      <geometry><box size="0.230779 0.132523 0.0045"/></geometry>
      <material name="plate"/>
    </visual>
    <visual name="ultrasonic">
      <origin xyz="0.1101 0 0.010505" rpy="0 0 0"/>
      <geometry><box size="0.0136 0.045 0.02"/></geometry>
      <material name="default"/>
    </visual>
    <visual name="ultrasonic_bracket">
      <origin xyz="0.1088 0 0.013505" rpy="0 0 0"/>
      <geometry><box size="0.015 0.047 0.024"/></geometry>
      <material name="default"/>
    </visual>
    <visual name="xt30">
      <origin xyz="0 0.036 -0.0116" rpy="0 0 0"/>
      <geometry><box size="0.025 0.01 0.0052"/></geometry>
      <material name="default"/>
    </visual>
    <collision name="battery">
      <origin xyz="0 0 -0.0067" rpy="0 0 0"/>
      <geometry><box size="0.07 0.05 0.015"/></geometry>
    </collision>
    <collision name="bottom_plate">
      <origin xyz="0.002005 -2.5e-06 -0.01645" rpy="0 0 0"/>
      <geometry><box size="0.23078 0.132523 0.0045"/></geometry>
    </collision>
    <collision name="buck_5v">
      <origin xyz="0.0507 0 -0.0089" rpy="0 0 0"/>
      <geometry><box size="0.0254 0.0254 0.0106"/></geometry>
    </collision>
    <collision name="camera">
      <origin xyz="0.105785 0 0.0463845" rpy="0 0 0"/>
      <geometry><box size="0.011569 0.025 0.023339"/></geometry>
    </collision>
    <collision name="camera_mount">
      <origin xyz="0.107 0 0.044505" rpy="0 0 0"/>
      <geometry><box size="0.02 0.03 0.029"/></geometry>
    </collision>
    <collision name="cap_buck">
      <origin xyz="0.045 -0.01995 -0.01105" rpy="0 0 0"/>
      <geometry><box size="0.011 0.0063 0.0063"/></geometry>
    </collision>
    <collision name="cap_driver">
      <origin xyz="-0.004 0 0.017505" rpy="0 0 0"/>
      <geometry><box size="0.01 0.016 0.01"/></geometry>
    </collision>
    <collision name="deck_pillar_1">
      <origin xyz="-0.0807 -0.0561 0.0056525" rpy="0 0 0"/>
      <geometry><box size="0.0055 0.0055 0.039705"/></geometry>
    </collision>
    <collision name="deck_pillar_2">
      <origin xyz="-0.0807 0.0559 0.0056525" rpy="0 0 0"/>
      <geometry><box size="0.0055 0.0055 0.039705"/></geometry>
    </collision>
    <collision name="deck_pillar_3">
      <origin xyz="-0.0007 0.0559 0.0056525" rpy="0 0 0"/>
      <geometry><box size="0.0055 0.0055 0.039705"/></geometry>
    </collision>
    <collision name="deck_pillar_4">
      <origin xyz="0.0003 -0.0561 0.0056525" rpy="0 0 0"/>
      <geometry><box size="0.0055 0.0055 0.039705"/></geometry>
    </collision>
    <collision name="deck_pillar_5">
      <origin xyz="0.0844 -0.0523 0.0056525" rpy="0 0 0"/>
      <geometry><box size="0.0055 0.0055 0.039705"/></geometry>
    </collision>
    <collision name="deck_pillar_6">
      <origin xyz="0.0844 0.0527 0.0056525" rpy="0 0 0"/>
      <geometry><box size="0.0055 0.0055 0.039705"/></geometry>
    </collision>
    <collision name="esp32">
      <origin xyz="-0.0665 0 -0.00715" rpy="0 0 0"/>
      <geometry><box size="0.055 0.028 0.0141"/></geometry>
    </collision>
    <collision name="fence_nut_1">
      <origin xyz="-0.020125 0.029875 0.024305" rpy="0 0 0"/>
      <geometry><box size="0.0055 0.0055 0.0024"/></geometry>
    </collision>
    <collision name="fence_nut_2">
      <origin xyz="-0.020125 -0.029875 0.024305" rpy="0 0 0"/>
      <geometry><box size="0.0055 0.0055 0.0024"/></geometry>
    </collision>
    <collision name="fence_nut_3">
      <origin xyz="-0.079875 0.029875 0.024305" rpy="0 0 0"/>
      <geometry><box size="0.0055 0.0055 0.0024"/></geometry>
    </collision>
    <collision name="fence_nut_4">
      <origin xyz="-0.079875 -0.029875 0.024305" rpy="0 0 0"/>
      <geometry><box size="0.0055 0.0055 0.0024"/></geometry>
    </collision>
    <collision name="fence_post_1">
      <origin xyz="-0.020125 0.029875 0.040005" rpy="0 0 0"/>
      <geometry><box size="0.0055 0.0055 0.02"/></geometry>
    </collision>
    <collision name="fence_post_2">
      <origin xyz="-0.020125 -0.029875 0.040005" rpy="0 0 0"/>
      <geometry><box size="0.0055 0.0055 0.02"/></geometry>
    </collision>
    <collision name="fence_post_3">
      <origin xyz="-0.079875 0.029875 0.040005" rpy="0 0 0"/>
      <geometry><box size="0.0055 0.0055 0.02"/></geometry>
    </collision>
    <collision name="fence_post_4">
      <origin xyz="-0.079875 -0.029875 0.040005" rpy="0 0 0"/>
      <geometry><box size="0.0055 0.0055 0.02"/></geometry>
    </collision>
    <collision name="front_screw_1">
      <origin xyz="0.11 0.01 0.027905" rpy="0 0 0"/>
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
    </collision>
    <collision name="mdd3a_standoff_1">
      <origin xyz="0.04959 0.01829 0.023005" rpy="0 0 0"/>
      <geometry><box size="0.005 0.005 0.005"/></geometry>
    </collision>
    <collision name="mdd3a_standoff_2">
      <origin xyz="0.04959 -0.01829 0.023005" rpy="0 0 0"/>
      <geometry><box size="0.005 0.005 0.005"/></geometry>
    </collision>
    <collision name="mdd3a_standoff_3">
      <origin xyz="0.00641 0.01829 0.023005" rpy="0 0 0"/>
      <geometry><box size="0.005 0.005 0.005"/></geometry>
    </collision>
    <collision name="mdd3a_standoff_4">
      <origin xyz="0.00641 -0.01829 0.023005" rpy="0 0 0"/>
      <geometry><box size="0.005 0.005 0.005"/></geometry>
    </collision>
    <collision name="motor_bracket_fl">
      <origin xyz="0.0616 0.0247 -0.0002" rpy="0 0 0"/>
      <geometry><box size="0.012 0.005 0.022"/></geometry>
    </collision>
    <collision name="motor_bracket_fr">
      <origin xyz="0.0616 -0.0247 -0.0002" rpy="0 0 0"/>
      <geometry><box size="0.012 0.005 0.022"/></geometry>
    </collision>
    <collision name="motor_bracket_rl">
      <origin xyz="-0.0616 0.0247 -0.0002" rpy="0 0 0"/>
      <geometry><box size="0.012 0.005 0.022"/></geometry>
    </collision>
    <collision name="motor_bracket_rr">
      <origin xyz="-0.0616 -0.0247 -0.0002" rpy="0 0 0"/>
      <geometry><box size="0.012 0.005 0.022"/></geometry>
    </collision>
    <collision name="motor_fl">
      <origin xyz="0.065925 0.0405625 0" rpy="0 0 0"/>
      <geometry><box size="0.07995 0.027375 0.0252"/></geometry>
    </collision>
    <collision name="motor_fr">
      <origin xyz="0.065925 -0.0405625 0" rpy="0 0 0"/>
      <geometry><box size="0.07995 0.027375 0.0252"/></geometry>
    </collision>
    <collision name="motor_rl">
      <origin xyz="-0.065925 0.0405625 0" rpy="0 0 0"/>
      <geometry><box size="0.07995 0.027375 0.0252"/></geometry>
    </collision>
    <collision name="motor_rr">
      <origin xyz="-0.065925 -0.0405625 0" rpy="0 0 0"/>
      <geometry><box size="0.07995 0.027375 0.0252"/></geometry>
    </collision>
    <collision name="motor_spacer_fl">
      <origin xyz="0.0616 0.0255 -0.0127" rpy="0 0 0"/>
      <geometry><box size="0.0138 0.006 0.003"/></geometry>
    </collision>
    <collision name="motor_spacer_fr">
      <origin xyz="0.0616 -0.0255 -0.0127" rpy="0 0 0"/>
      <geometry><box size="0.0138 0.006 0.003"/></geometry>
    </collision>
    <collision name="motor_spacer_rl">
      <origin xyz="-0.0616 0.0255 -0.0127" rpy="0 0 0"/>
      <geometry><box size="0.0138 0.006 0.003"/></geometry>
    </collision>
    <collision name="motor_spacer_rr">
      <origin xyz="-0.0616 -0.0255 -0.0127" rpy="0 0 0"/>
      <geometry><box size="0.0138 0.006 0.003"/></geometry>
    </collision>
    <collision name="pi5">
      <origin xyz="0.0342 0.0008315 0.04396" rpy="0 0 0"/>
      <geometry><box size="0.09 0.057663 0.01979"/></geometry>
    </collision>
    <collision name="pi5_cooler">
      <origin xyz="0.045 0 0.042405" rpy="0 0 0"/>
      <geometry><box size="0.0635 0.0425 0.01"/></geometry>
    </collision>
    <collision name="pi_screw_1">
      <origin xyz="0.074 0.0245 0.024655" rpy="0 0 0"/>
      <geometry><box size="0.0045 0.0045 0.0017"/></geometry>
    </collision>
    <collision name="pi_screw_2">
      <origin xyz="0.074 -0.0245 0.024655" rpy="0 0 0"/>
      <geometry><box size="0.0045 0.0045 0.0017"/></geometry>
    </collision>
    <collision name="pi_screw_3">
      <origin xyz="0.016 0.0245 0.024655" rpy="0 0 0"/>
      <geometry><box size="0.0045 0.0045 0.0017"/></geometry>
    </collision>
    <collision name="pi_screw_4">
      <origin xyz="0.016 -0.0245 0.024655" rpy="0 0 0"/>
      <geometry><box size="0.0045 0.0045 0.0017"/></geometry>
    </collision>
    <collision name="pi_standoff_1">
      <origin xyz="0.074 0.0245 0.033005" rpy="0 0 0"/>
      <geometry><box size="0.005 0.005 0.006"/></geometry>
    </collision>
    <collision name="pi_standoff_2">
      <origin xyz="0.074 -0.0245 0.033005" rpy="0 0 0"/>
      <geometry><box size="0.005 0.005 0.006"/></geometry>
    </collision>
    <collision name="pi_standoff_3">
      <origin xyz="0.016 0.0245 0.033005" rpy="0 0 0"/>
      <geometry><box size="0.005 0.005 0.006"/></geometry>
    </collision>
    <collision name="pi_standoff_4">
      <origin xyz="0.016 -0.0245 0.033005" rpy="0 0 0"/>
      <geometry><box size="0.005 0.005 0.006"/></geometry>
    </collision>
    <collision name="switch">
      <origin xyz="-0.1 0 0.023255" rpy="0 0 0"/>
      <geometry><box size="0.015 0.021 0.0255"/></geometry>
    </collision>
    <collision name="top_plate">
      <origin xyz="0.0020045 -2.5e-06 0.027755" rpy="0 0 0"/>
      <geometry><box size="0.230779 0.132523 0.0045"/></geometry>
    </collision>
    <collision name="ultrasonic">
      <origin xyz="0.1101 0 0.010505" rpy="0 0 0"/>
      <geometry><box size="0.0136 0.045 0.02"/></geometry>
    </collision>
    <collision name="ultrasonic_bracket">
      <origin xyz="0.1088 0 0.013505" rpy="0 0 0"/>
      <geometry><box size="0.015 0.047 0.024"/></geometry>
    </collision>
    <collision name="xt30">
      <origin xyz="0 0.036 -0.0116" rpy="0 0 0"/>
      <geometry><box size="0.025 0.01 0.0052"/></geometry>
    </collision>
  </link>
  <link name="wheel_fl">
    <inertial>
      <origin xyz="0 0 0" rpy="0 0 0"/>
      <mass value="0.025"/>
      <inertia ixx="8e-06" ixy="0" ixz="0" iyy="1.3e-05" iyz="0" izz="8e-06"/>
    </inertial>
    <visual>
      <origin xyz="0 0 0" rpy="1.5708 0 0"/>
      <geometry><cylinder radius="0.0325" length="0.026"/></geometry>
      <material name="rubber"/>
    </visual>
    <collision>
      <origin xyz="0 0 0" rpy="1.5708 0 0"/>
      <geometry><cylinder radius="0.0325" length="0.026"/></geometry>
    </collision>
  </link>
  <joint name="wheel_fl_joint" type="continuous">
    <origin xyz="0.04 0.062 0" rpy="0 0 0"/>
    <parent link="base_link"/>
    <child link="wheel_fl"/>
    <axis xyz="0 1 0"/>
    <limit effort="0.1648" velocity="22.56"/>
    <dynamics damping="0.0" friction="0.0"/>
  </joint>
  <link name="wheel_fr">
    <inertial>
      <origin xyz="0 0 0" rpy="0 0 0"/>
      <mass value="0.025"/>
      <inertia ixx="8e-06" ixy="-0" ixz="0" iyy="1.3e-05" iyz="0" izz="8e-06"/>
    </inertial>
    <visual>
      <origin xyz="0 0 0" rpy="1.5708 0 0"/>
      <geometry><cylinder radius="0.0325" length="0.026"/></geometry>
      <material name="rubber"/>
    </visual>
    <collision>
      <origin xyz="0 0 0" rpy="1.5708 0 0"/>
      <geometry><cylinder radius="0.0325" length="0.026"/></geometry>
    </collision>
  </link>
  <joint name="wheel_fr_joint" type="continuous">
    <origin xyz="0.04 -0.062 0" rpy="0 0 0"/>
    <parent link="base_link"/>
    <child link="wheel_fr"/>
    <axis xyz="0 1 0"/>
    <limit effort="0.1648" velocity="22.56"/>
    <dynamics damping="0.0" friction="0.0"/>
  </joint>
  <link name="wheel_rl">
    <inertial>
      <origin xyz="0 0 0" rpy="0 0 0"/>
      <mass value="0.025"/>
      <inertia ixx="8e-06" ixy="-0" ixz="-0" iyy="1.3e-05" iyz="0" izz="8e-06"/>
    </inertial>
    <visual>
      <origin xyz="0 0 0" rpy="1.5708 0 0"/>
      <geometry><cylinder radius="0.0325" length="0.026"/></geometry>
      <material name="rubber"/>
    </visual>
    <collision>
      <origin xyz="0 0 0" rpy="1.5708 0 0"/>
      <geometry><cylinder radius="0.0325" length="0.026"/></geometry>
    </collision>
  </link>
  <joint name="wheel_rl_joint" type="continuous">
    <origin xyz="-0.04 0.062 0" rpy="0 0 0"/>
    <parent link="base_link"/>
    <child link="wheel_rl"/>
    <axis xyz="0 1 0"/>
    <limit effort="0.1648" velocity="22.56"/>
    <dynamics damping="0.0" friction="0.0"/>
  </joint>
  <link name="wheel_rr">
    <inertial>
      <origin xyz="0 0 0" rpy="0 0 0"/>
      <mass value="0.025"/>
      <inertia ixx="8e-06" ixy="0" ixz="-0" iyy="1.3e-05" iyz="0" izz="8e-06"/>
    </inertial>
    <visual>
      <origin xyz="0 0 0" rpy="1.5708 0 0"/>
      <geometry><cylinder radius="0.0325" length="0.026"/></geometry>
      <material name="rubber"/>
    </visual>
    <collision>
      <origin xyz="0 0 0" rpy="1.5708 0 0"/>
      <geometry><cylinder radius="0.0325" length="0.026"/></geometry>
    </collision>
  </link>
  <joint name="wheel_rr_joint" type="continuous">
    <origin xyz="-0.04 -0.062 0" rpy="0 0 0"/>
    <parent link="base_link"/>
    <child link="wheel_rr"/>
    <axis xyz="0 1 0"/>
    <limit effort="0.1648" velocity="22.56"/>
    <dynamics damping="0.0" friction="0.0"/>
  </joint>
  <link name="laser_link"/>
  <joint name="laser_joint" type="fixed">
    <origin xyz="0.055 0 0.116405" rpy="0 0 0"/>
    <parent link="base_link"/>
    <child link="laser_link"/>
  </joint>
  <link name="camera_link"/>
  <joint name="camera_joint" type="fixed">
    <origin xyz="0.11047 0 0.04711" rpy="0 0.261799 0"/>
    <parent link="base_link"/>
    <child link="camera_link"/>
  </joint>
  <link name="camera_optical_link"/>
  <joint name="camera_optical_joint" type="fixed">
    <origin xyz="0 0 0" rpy="-1.5708 0 -1.5708"/>
    <parent link="camera_link"/>
    <child link="camera_optical_link"/>
  </joint>
  <link name="imu_link"/>
  <joint name="imu_joint" type="fixed">
    <origin xyz="-0.024 0 0.013455" rpy="3.14159 0 0"/>
    <parent link="base_link"/>
    <child link="imu_link"/>
  </joint>
  <link name="ultrasonic_link"/>
  <joint name="ultrasonic_joint" type="fixed">
    <origin xyz="0.1169 0 0.010505" rpy="0 0 0"/>
    <parent link="base_link"/>
    <child link="ultrasonic_link"/>
  </joint>
  <!-- payload (300 g) omitted here; scout_payload.urdf or xacro arg payload:=true adds it -->

  <!-- ros2_control sketch (NOT controller code). Hardware plugin name is a placeholder for the
       ESP32 micro-ROS / serial bridge. Skid-steer runs on diff_drive_controller with two wheels
       per side:
       controller_manager:
         ros__parameters: {update_rate: 50, diff_drive_controller: {type: diff_drive_controller/DiffDriveController}}
       diff_drive_controller:
         ros__parameters:
           left_wheel_names:  [wheel_fl_joint, wheel_rl_joint]
           right_wheel_names: [wheel_fr_joint, wheel_rr_joint]
           wheel_separation: 0.124            # nominal; skid-steer needs wheel_separation_multiplier ~ sim/results.json spin.effective_track_ratio
           wheel_radius: 0.0325
           wheel_separation_multiplier: 1.0   # calibrate on each floor (docs/sim-round4.md: 1.6-1.9 in sim)
           base_frame_id: base_footprint
           odom_frame_id: odom
           enable_odom_tf: false              # robot_localization EKF publishes odom->base_footprint
           linear.x.max_velocity: 0.3
           angular.z.max_velocity: 1.0
           cmd_vel_timeout: 0.3               # REQ-SCOUT-002
  -->
</robot>
