mattyjayt/terra-hawk-scout/(commit log)

2026-10-30 docs: documentation skeleton, PRD/SRS/interfaces/DD-SCOUT-HW drafts, ADRs, layout CAD, diagrams and figure
2026-11-01 wip(cad): scout v2 design rounds 1–2 (CAD r1, physics r1+r2 review, sim r1)
    [motor_profiles.json, scout.urdf, scout.urdf.xacro]
2026-11-02 feat(cad): scout v2 round 3 — review applied (C1, MDD3A, D36V50F5, no motor buck, payload x=-50 + fence, IMU at CoR), exports, assembly steps, power/wiring/assembly diagrams, drivetrain figure
    [battery.stl, bottom_plate.stl, buck_5v.stl, cable_5v_esp32.stl, cable_batt_xt30.stl, cable_buck5_lidar.stl, cable_buck5_pi.stl, cable_camera_ffc.stl]
2026-11-02 feat(design): scout v2 round 4 — sim and URDF from CAD params, final physics review + purchase list, assembly guide page, cleanup
    [motor_profiles.json, scout.urdf, scout.urdf.xacro, scout_payload.urdf]
2026-11-02 feat(firmware): R4 base controller (motors, servo, IMU, battery, watchdog) + bench sketches, serial-r4-v1 spec, ADR-0005, teleop tool
2026-11-03 chore: Scout is Pi 5 + UNO R4 only — remove ESP32/micro-ROS path (ADR-0006)
    - delete firmware/esp32_base and the never-implemented IF-MICROROS spec
    - ADR-0006 accepted; ADR-0002 superseded; ADR-0005 made permanent
    - DD-SCOUT-FW re-scoped to the R4 firmware (issue #16)
    - README, docs index, BOM, DD-SCOUT-HW pinout (R4/Elegoo shield), runbook, SRS (REQ-016 serial reconnect, REQ-010 Python perception), ros-topics publishers
    - cad/scout-v2 README notes the ESP32 slot is superseded
2026-11-03 docs: IF-ROS-TOPICS v1.0 contract, DD-SCOUT-BRIDGE, fake R4 emulator, lab course
    - IF-ROS-TOPICS v1.0 (approved P1-P2): topics, field-level message shapes, QoS profiles,
    services, TF tree, parameters, versioning rules, traceability
    - DD-SCOUT-BRIDGE v0.9 (draft for approval): functional core / I/O shell, reader thread,
    link state machine, kinematics with ratio-preserving saturation + deadband, stale-IMU
    detection (frozen IMU observed 3 Nov), 3-level test design
    - SRS: REQ-SCOUT-021..024; test plan: TC-SCOUT-021..025
    - tools/fake_r4.py: serial-r4-v1 emulator on a pty (JSON log, --freeze-imu) for SIL tests
    - docs/learning/: 8-lab course (personal learning material, to be removed later)
    -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
2026-11-04 feat(scout_base_py): serial link, reader thread, drive with timeout
2026-11-04 docs(learning): Lab 4 rewritten step by step — 4.0 Lab 3 fixes, 4.4 telemetry, 4.5 pan + services, 4.6 diagnostics + shutdown (signatures, steps, tests)
2026-11-05 fix(scout_base_py): StaleDetector compares with the previous sample; RateMeter uses a true sliding window (+ tests from field data)
    [conversions.py, test_conversion.py]
2026-11-05 feat(scout_base_py): telemetry publishers and lab 4.0 fixes
    [base_bridge.py, conversions.py, kinematics.py, protocol.py]
2026-11-05 feat(scout_base_py): pan command, services with ack wait (Lab 4.5); fix double degree conversion, CRLF strip
    [base_bridge.py, kinematics.py, protocol.py, test_kinematics.py]
2026-11-05 chore: remove docs/learning (course material moved to a private notebook)
2026-11-05 docs: archify P1/P2 graph + cmd_vel safety sequence, anatomy Twist->PWM figure; linked from contract, DD-SCOUT-BRIDGE and index
2026-11-06 fixed battery work, added foxglove layout & tested with rosbag
    [base_bridge.py, conversions.py, test_conversion.py]
2026-11-07 feat(scout_description): URDF of the Scout
    [scout.urdf.xacro]
2026-11-07 feat(scout_description): description launch, with missing pan_base_link. pan_link, camera_link, camera_optical_frame
    [scout.urdf.xacro]
2026-11-07 final urdf & launch files
    [scout.urdf.xacro]
2026-11-08 scout_perception package init with battery fix
    [base_bridge.py, test_pep257.py]
2026-11-09 fixing perception assembly
2026-11-09 docs: remove outdated ESP32/micro-ROS/encoder/LD19 statements
    - ADR-0002 marked superseded in its title and a banner; ADR-0003 status Deferred
    (no encoders on the robot; odometry = LiDAR scan matching + gyro)
    - SRS/PRD/IF-ROS-TOPICS: odometry from LiDAR scan matching, not wheel encoders
    - DD-SCOUT-HW: RPLIDAR C1, no HC-SR04 load, measured battery, resolved questions
    - BOM: RPLIDAR C1 ordered, encoder motors deferred, D36V50F5, 2S box in use
    - cad/scout-v2 and cad/scout-layout: note that they are design studies, not the robot
2026-11-10 docs: target ROS 2 graph for Pi 5 + UNO R4 (replaces the ESP32 design), robot photo, YOLO26n in the current graph
